Vivianki/LiCy/Documentos/relatorio/licy-apendices.tex

% ---
% Arquivo com os apêndices do Trabalho de Conclusão de Curso dos alunos
% Gabriel Takaoka Nishimura, Felippe Demarqui Ramos e Vivian Kimie Isuyama 
% da Escola Politécnica da Universidade de São Paulo
% ---
\chapter{Diagramas da Arquitetura}

\begin{figure}[h]
	\caption{\label{fig_sindrome_arq}Arquitetura do módulo de cálculo das síndromes.}
	\centering
	
	\legend{Fonte: Autores.}
\end{figure}

\begin{figure}[h]
	\caption{\label{fig_berlekamp_arq}Arquitetura do módulo de Berlekamp-Massey.}
	\centering
	
	\legend{Fonte: Autores.}
\end{figure}

\begin{figure}[h]
	\caption{\label{fig_chienloc_arq}Arquitetura do módulo de busca de Chien: localização de erros.}
	\centering
	
	\legend{Fonte: Autores.}
\end{figure}

\begin{figure}[h]
	\caption{\label{fig_chienval_arq}Arquitetura do módulo de busca de Chien: valores de erros.}
	\centering
		
	\legend{Fonte: Autores.}
\end{figure}

\begin{figure}[h]
	\caption{\label{figure:interleaver-rtl}Arquitetura do módulo de \textit{Interleaver}.}
	\centering
	
	\legend{Fonte: Autores.}
\end{figure}
\begin{figure}[h]
	\caption{\label{figure:sync-rtl}Arquitetura do módulo de Sincronização.}
	\centering
	
	\legend{Fonte: Autores.}
\end{figure}
\begin{figure}[h]
	\caption{\label{figure:manchester-decoder-rtl}Arquitetura do módulo de Decodificação Manchester.}
	\centering
	
	\legend{Fonte: Autores.}
\end{figure}

\begin{figure}[h]
	\caption{\label{figure:viterbi-rtl}Arquitetura do módulo de Decodificação Viterbi.}
	\centering
	
	\legend{Fonte: Autores.}
\end{figure}
