Vivianki/LiCy/Documentos/relatorio/ficha-catalografica.tex

\begin{fichacatalografica}
	\sffamily
	\vspace*{\fill}					% Posição vertical
	\begin{center}					% Minipage Centralizado
		\fbox{\begin{minipage}[c][8cm]{13.5cm}		% Largura
			\small
			\imprimirautor
			%Sobrenome, Nome do autor
				
			\hspace{0.5cm} \imprimirtitulo  / \imprimirautor. --
			\imprimirlocal, \imprimirdata-
			
			\hspace{0.5cm} \pageref{LastPage} p. : il. (algumas color.) ; 30 cm.\\
			
			\hspace{0.5cm} \imprimirorientadorRotulo~\imprimirorientador\\
			
			\hspace{0.5cm}
			\parbox[t]{\textwidth}{\imprimirtipotrabalho~--~\imprimirinstituicao,
				\imprimirdata.}\\
			
			\hspace{0.5cm}
			1. Engenharia
			2. Engenharia de computação
			3. Ensino e aprendizagem
			I. Universidade de São Paulo. Escola Politécnica. Departamento de Computação 	
		\end{minipage}}
	\end{center}
\end{fichacatalografica}
