Vivianki/LiCy/Documentos/relatorio/Arquitetura.pdf

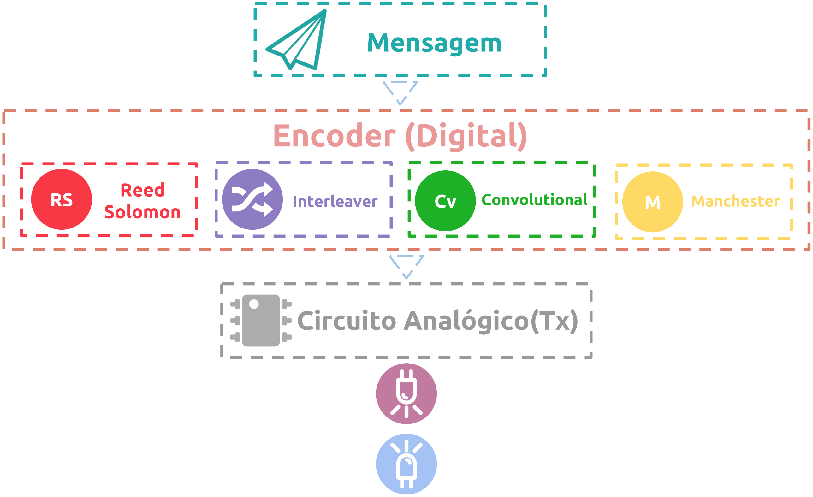
[picture p23: figure]
Convolutional Reed; Solomon RS; Interleaver; Mensagem; Manchester; Encoder (Digital); Circuito Analógico(Tx)

## Circuito Analógico(Rx)

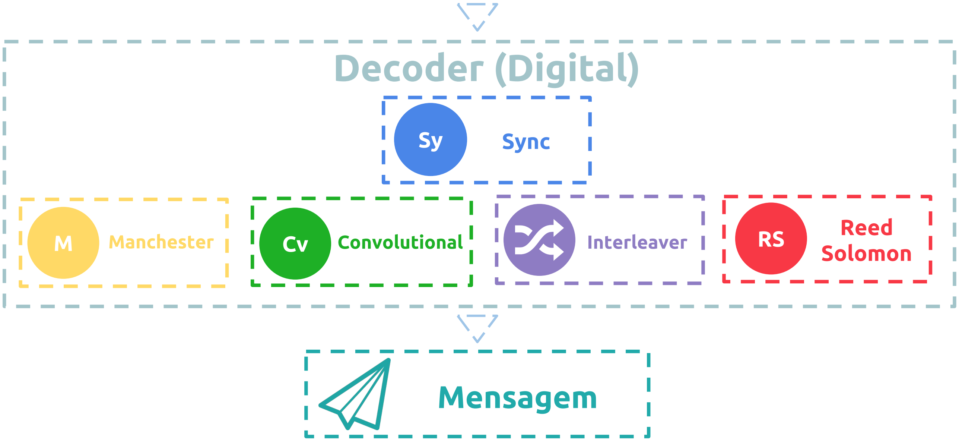
[picture p24: figure]
Convolutional; Reed; Solomon M; Manchester; Interleaver; Decoder (Digital); Mensagem; Sync
