Vivianki/LiCy/Documentos/relatorio/circuits/receiver_lify_final.pdf

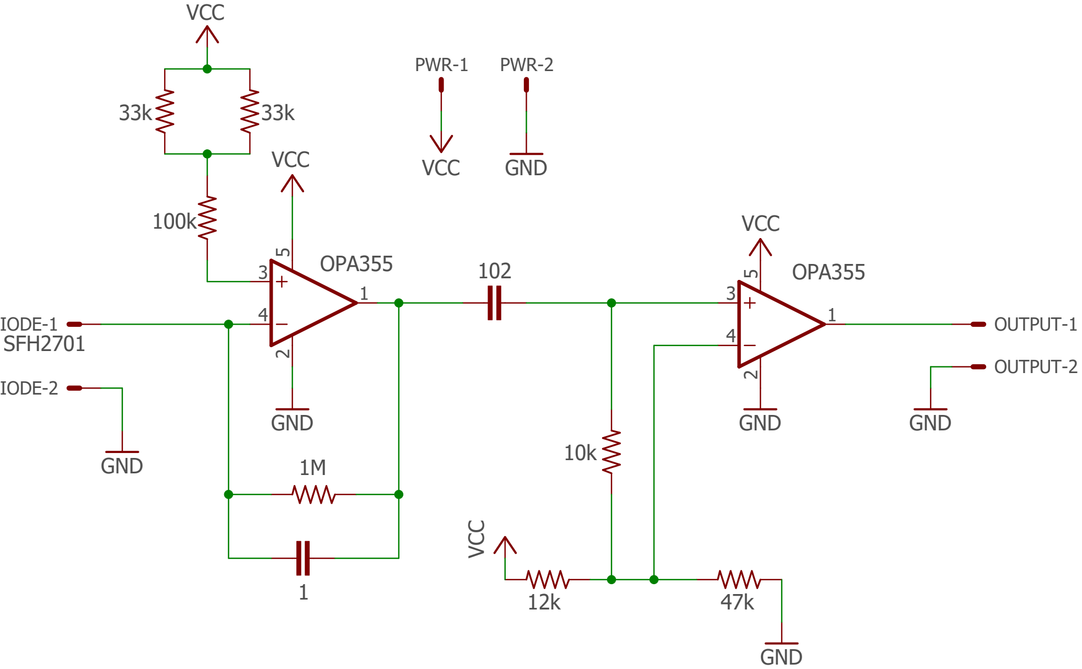
[picture p25: figure]
OPA355; GND; VCC; SFH2701; OUTPUT-1; OUTPUT-2; PWR-1; PWR-2

PHOTODIODE-1

PHOTODIODE-2
