Vivianki/LiCy/Documentos/relatorio/circuits/transmitter_fail1.pdf

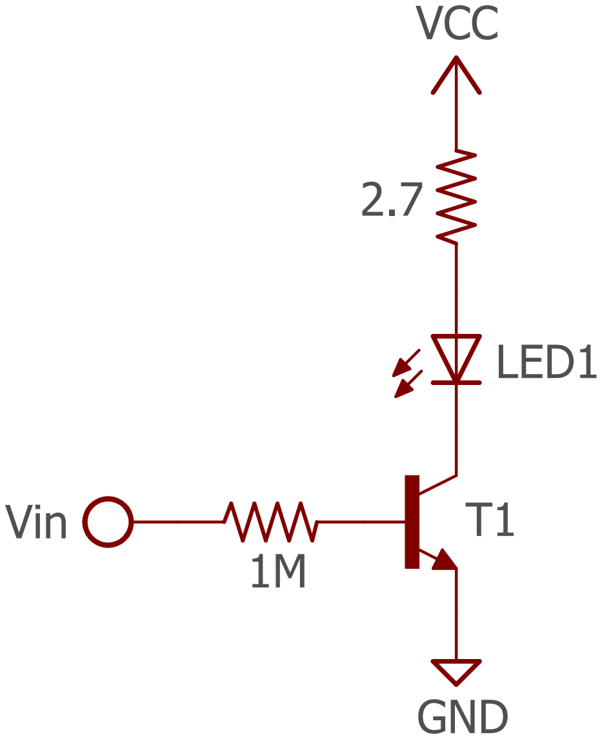
[picture p26: figure]
Vin; VCC; GND; LED1
