Vivianki/LiCy/Documentos/relatorio/circuits/transmitter_fail0.pdf

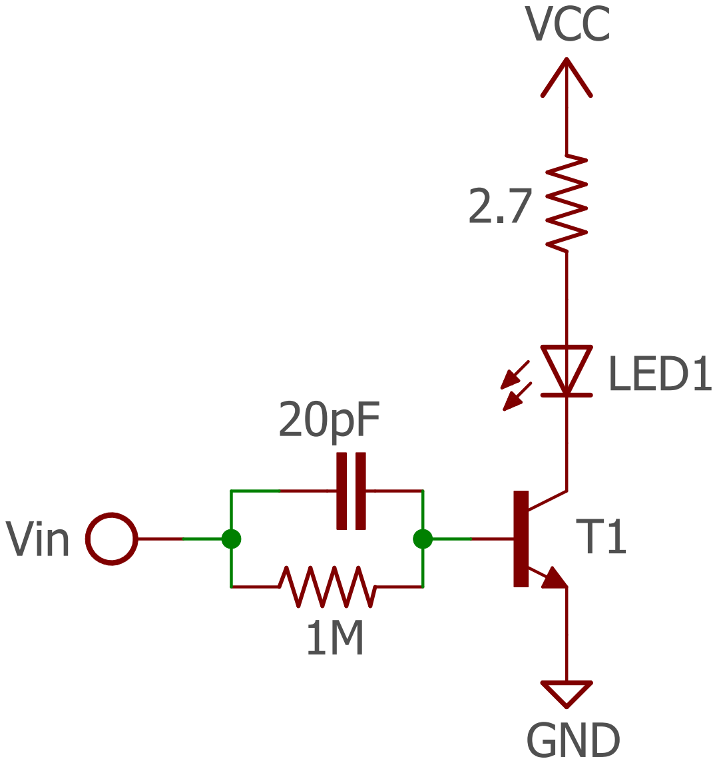
[picture p27: figure]
Vin; VCC; GND; LED1
