Vivianki/LiCy/Documentos/relatorio/circuits/transmitter_lify.pdf

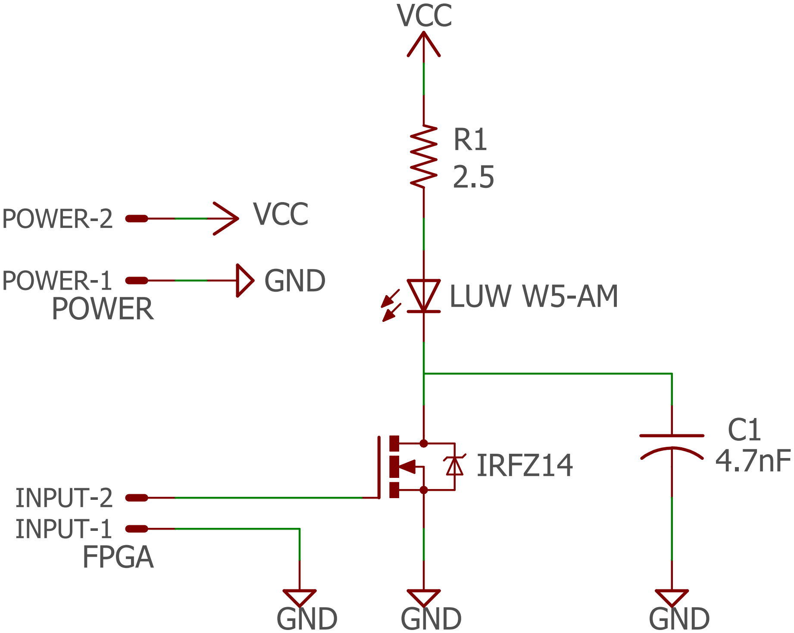
[picture p28: figure]
IRFZ14; GND; VCC; LUW W5-AM; FPGA; POWER; INPUT-1; INPUT-2; POWER-1; POWER-2
