Vivianki/LiCy/Documentos/relatorio/circuits/led_circuit.pdf

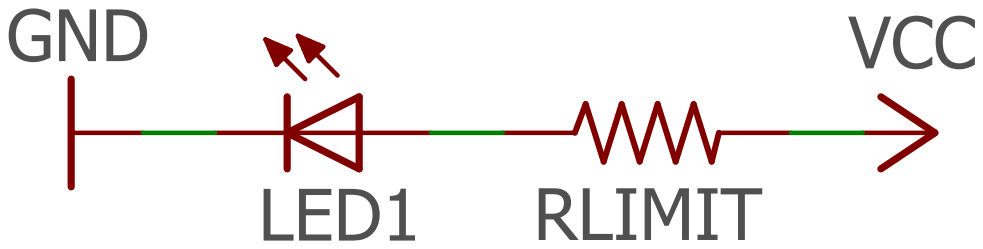
[picture p30: figure]
GND; VCC; LED1; RLIMIT
