Vivianki/LiCy/Documentos/relatorio/circuits/highpass_filter.pdf

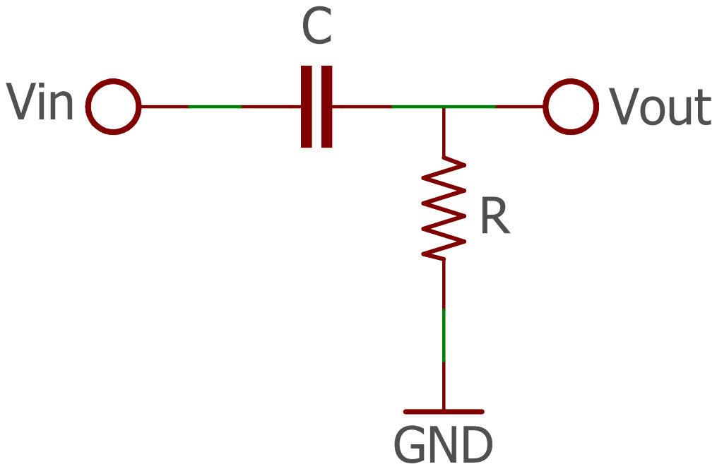
[picture p31: figure]
Vin; Vout; GND
