Vivianki/LiCy/Documentos/relatorio/circuits/lowpass-filter.pdf

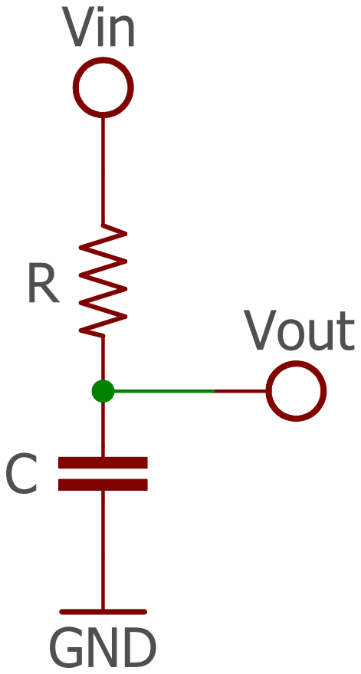
[picture p32: figure]
Vin; Vout; GND
