Vivianki/LiCy/Documentos/relatorio/circuits/mosfet_example.pdf

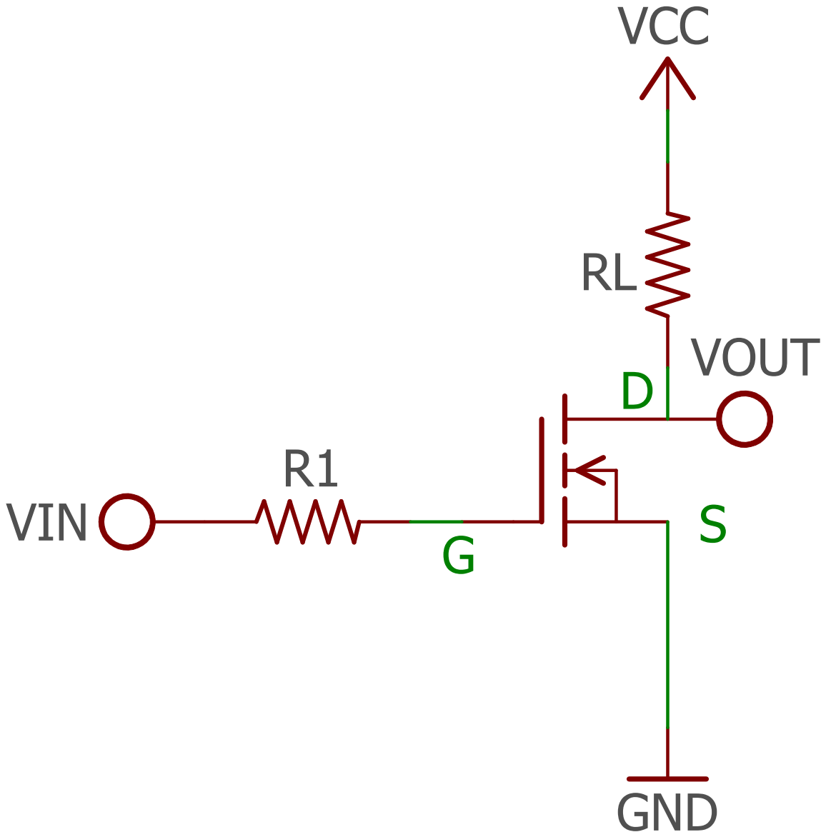
[picture p33: figure]
VCC; GND; VIN; VOUT
