Vivianki/LiCy/Documentos/relatorio/circuits/transimpedance_amp_simple.pdf

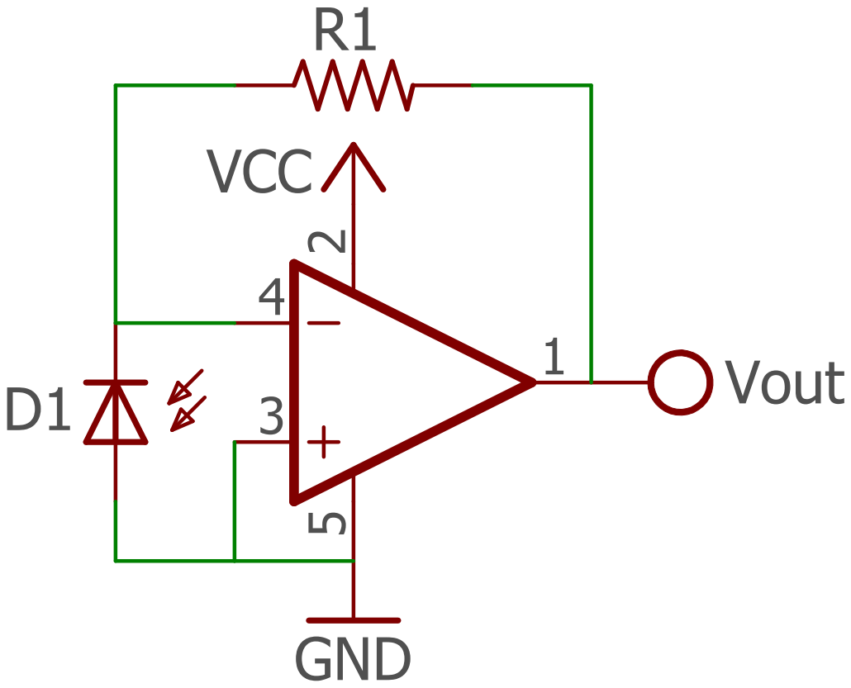
[picture p34: figure]
VCC; Vout; GND
