Vivianki/LiCy/Documentos/relatorio/licy.tex

% ------------------------------------------------------------------------
% ------------------------------------------------------------------------
% LiCy - Trabalho de Conclusão de Curso da Escola Politécnica da USP
% Integrantes: Gabriel Takaoka Nishimura, Felippe Demarqui Ramos e Vivian Kimie Isuyama.
% ------------------------------------------------------------------------
% ------------------------------------------------------------------------

\documentclass[
	12pt,				% tamanho da fonte
	openright,			% capítulos começam em pág ímpar
	oneside,			% para impressão em recto e verso. Oposto a oneside
	a4paper,			% tamanho do papel.
	hyphens,			% url longa nas referencias
	english,			% idioma adicional para hifenização
	brazil				% o último idioma é o principal do documento
]{abntex2}

% ---
%  PACOTES
% ---

% Pacotes básicos
\usepackage{lmodern}			% Usa a fonte Latin Modern
\usepackage[T1]{fontenc}		% Selecao de codigos de fonte.
\usepackage[utf8]{inputenc}		% Conversão automática dos acentos
\usepackage{lastpage}			% Usado pela Ficha catalográfica
\usepackage{indentfirst}		% Indenta o primeiro parágrafo de cada seção.
\usepackage{color}				% Controle das cores
\usepackage{amssymb}			% Less than or equal to
\usepackage{tikz}				% desenhos de graficos aux
\usepackage{pgfplots}			% desenhos de gráficos
\usepackage{graphicx}			% Inclusão de gráficos
\usepackage{subcaption}			% Subfigure
\usepackage{float}				% Gráficos
\usepackage{gensymb}			% degree
\usepackage{microtype} 			% para melhorias de justificação
\usepackage{lipsum}				% para geração de dummy text
\usepackage{listings}			% para listagem de código %
\usepackage{amsmath}			% para construção de sistemas lineares%

% Pacotes de citações
\usepackage[brazilian,hyperpageref]{backref}	 % Paginas com as citações
\usepackage[alf,abnt-url-package=url]{abntex2cite}	% Citações padrão ABNT

% ---
% CONFIGURAÇÕES DE PACOTES
% ---

% ---
% Configurações do pacote
\newenvironment{spmatrix}[1]{
	\def\mysubscript{#1}\mathop\bgroup\begin{pmatrix}
	}
{\end{pmatrix}\egroup_{\textstyle\mathstrut\mysubscript}}
% ---

% ---
% Configurações do pacote PGFPLOT
\pgfplotsset{compat=1.14}
\usetikzlibrary{patterns}
\usepgfplotslibrary{fillbetween}

% ---
% Configurações do pacote float
\newfloat{chart}{tbhp}{loc} %section
\floatname{chart}{Gráfico}
\floatstyle{plaintop}
\restylefloat{chart}
\newcommand{\listofcharts}{\listof{chart}{Lista de Gráficos}}
% ---
% Configurações do pacote backref
\renewcommand{\backrefpagesname}{Citado na(s) página(s):~}
\renewcommand{\backref}{}
\renewcommand*{\backrefalt}[4]{
	\ifcase #1 %
	Nenhuma citação no texto.%
	\or
	Citado na página #2.%
	\else
	Citado #1 vezes nas páginas #2.%
	\fi}%
% ---

% ---
% Informações de dados para CAPA e FOLHA DE ROSTO
% ---
\titulo{\textit{Light Cyber}: Um estudo sobre a implementação de \textit{Light Fidelity} utilizando a norma IEEE 802.15.7}
\autor{Gabriel Takaoka Nishimura \\ Felippe Demarqui Ramos \\ Vivian Kimie Isuyama}
\local{São Paulo}
\data{2016}
\orientador{Prof. Dr. Bruno Carvalho de Albertini}
\instituicao{Universidade de São Paulo -  USP \par
			Escola Politécnica \par
			Engenharia Elétrica com ênfase em Computação}
\tipotrabalho{Trabalho de Conclusão de Curso}
\preambulo{Trabalho de Conclusão de Curso apresentado ao Departamento de Engenharia de Computação e Sistemas
	Digitais da Escola Politécnica da Universidade de São Paulo para obtenção do título de Bacharel de Engenharia}
% ---

% ---
% Configurações de aparência do PDF final
\definecolor{blue}{RGB}{41,5,195} % cor azul

% informações do PDF
\makeatletter
\hypersetup{
	%pagebackref=true,
	pdftitle={\@title},
	pdfauthor={\@author},
	pdfsubject={\imprimirpreambulo},
	pdfcreator={LaTeX with abnTeX2},
	pdfkeywords={abnt}{latex}{abntex}{abntex2}{trabalho acadêmico},
	colorlinks=true,       		% false: boxed links; true: colored links
	linkcolor=blue,          	% color of internal links
	citecolor=blue,        		% color of links to bibliography
	filecolor=magenta,      		% color of file links
	urlcolor=blue,
	bookmarksdepth=4
}
\makeatother
% ---

% ---
% Espaçamentos entre linhas e parágrafos
% ---
\setlength{\parindent}{1.3cm} % O tamanho do parágrafo
\setlength{\parskip}{0.2cm}  % espacamento entre um paragrafo e outro

% ---
% compila o indice
% ---
\makeindex
% ---

% ----
% Início do documento
% ----
\begin{document}

	% Seleciona o idioma do documento
	\selectlanguage{brazil}

	% Retira espaço extra obsoleto entre as frases.
	\frenchspacing

	% ----------------------------------------------------------
	% ELEMENTOS PRÉ-TEXTUAIS
	% ----------------------------------------------------------
	% \pretextual

	% ---
	% Capa
	% ---
	\imprimircapa
	% ---

	% ---
	% Folha de rosto
	% ---
	%\imprimirfolhaderosto*
	
	\begin{center}
		%fix do nome zuadinho
		{\ABNTEXchapterfont\large\ Gabriel Takaoka Nishimura \\ Felippe Demarqui Ramos \\ \vspace*{0.18cm} Vivian Kimie Isuyama}
		
		\vspace*{\fill}\vspace*{\fill}
%		\vspace*{-0.2cm}
		\begin{center}
			\ABNTEXchapterfont\bfseries\Large\imprimirtitulo
		\end{center}
		\vspace*{\fill}
		
		{%
			\hspace{.45\textwidth}
			\begin{minipage}{.5\textwidth}
				\SingleSpacing
				\imprimirpreambulo
			\end{minipage}%
			\vspace*{\fill}
		}%
		
		{\imprimirinstituicao\vspace*{\fill}}
		
		{\large\imprimirorientadorRotulo~\imprimirorientador\par}

		\vspace*{\fill}
		
		{\large\imprimirlocal}
		\par
		{\large\imprimirdata}
		\vspace*{1cm}
		
	\end{center}
	% ---

	% ---
	% Ficha Catalográfica
	% Quando receber pdf da biblioteca, descomentar linhas abaixo
	% ---
	%\include{ficha-catalografica}
	% ---

	% \begin{fichacatalografica}
	%     \includepdf{fig_ficha_catalografica.pdf}
	% \end{fichacatalografica}

	% ---
	% TODO APROVACAO
	% Quando receber pdf com assinaturas, descomentar linha abaixo
	% ---
	% \includepdf{folhadeaprovacao_final.pdf}
	%

	% ---
	% Agradecimentos
	% ---
	\begin{agradecimentos}
		À instituição de ensino e todos os seus docentes por fornecerem uma aventura de graduação inesquecível aos integrantes do grupo.

		Ao nosso orientador, Bruno de Carvalho Albertini, por todo o apoio e paciência com o grupo. Seu otimismo e bom humor sempre foram grande fonte de motivação.

		Aos docentes e técnicos do Departamento de Sistemas Eletrônicos pelas aulas extracurriculares de eletrônica.

		À Carolina Ribeiro Minchin e Caique Bernardes Queiroz Magalhães por suas exímias revisões. A gentileza foi imensurável.

		Às nossas famílias pelo amor, incentivo e apoio incondicional.

		Por fim aos nossos amigos, que acreditaram no nosso potencial.
	\end{agradecimentos}
	% ---

	% ---
	% Epígrafe
	% ---
	\begin{epigrafe}
		\vspace*{\fill}
		\begin{flushright}
			\textit{``In a dark place we find ourselves,\\
				and a little more knowledge	lights our way.\\
				(Yoda, Episode 3: Revenge of the Sith)}
		\end{flushright}
	\end{epigrafe}
	% ---

	% ---
	% RESUMOS
	% ---
	\include{licy-resumos}
	% ---

	% ---
	% inserir lista de ilustrações
	% ---
	\pdfbookmark[0]{\listfigurename}{lof}
	\listoffigures*
	\cleardoublepage
	% ---

	% ---
	% inserir lista de gráficos
	% ---
	\pdfbookmark[0]{\listtablename}{lot}
	\listofcharts
	\cleardoublepage
	% ---

	% ---
	% inserir lista de tabelas
	% ---
	\pdfbookmark[0]{\listtablename}{lot}
	\listoftables*
	\cleardoublepage
	% ---

	% ---
	% inserir lista de abreviaturas e siglas
	% ---
	\begin{siglas}
		\item[AC] Corrente Alternada (do inglês \emph{Alternating Current})
		\item[ACS] Adicionar, Comparar e Selecionar (do inglês \emph{Add, Compare and Select})
		\item[ADC] Conversor Digital Analógico (do inglês \emph{Analog Digital Converter})
		\item[BM] Métrica de Ramificação (do inglês \emph{Branch Metrics})
		\item[BER] Taxa de Erro de \textit{bit} (do inglês \emph{Bit Error Rate})
		\item[CAP] \emph{Carrier-less amplitude and phase}
		\item[DC] Corrente Contínua (do inglês \emph{Direct Current})
		\item[DMT] Multi-Tom Discreto (do inglês \emph{Discrete Multi-Tone})
		\item[EAP] Estrutura Analítica de Projeto
		\item[FET] Transistor de Efeito de Campo (do inglês \emph{Field Effect Transistor})
		\item[FLP] Padrão de Rápido Travamento (do inglês \emph{Fast Locking Pattern})
		\item[FPGA] Arranjo de Portas Programável (do inglês \emph{Field Programable Gate Array})
		\item[GF] Campos de Galois (do inglês \emph{Galois Field})
		\item[GND] Terra (do inglês \emph{Ground})
		\item[GPIO] Pinos de Entrada e Saída de Propósito Geral (do inglês \emph{General Purpose Input/Output})
		\item[HDL] Linguagem de Descrição de Hardware (do inglês \emph{Hardware Description Language})
		\item[IEEE] Instituto dos Engenheiros Elétricos e Eletrônicos (do inglês \emph{Institute of Electrical and Electronics Engineers})
		\item[IP] Propriedade Intelectual (do inglês \emph{Intellectual Property})
		\item[ISI] Interferência Inter-Símbolo (do inglês \emph{Inter-symbol Interference})
		\item[LED] Diodo Emissor de Luz (do inglês \emph{Light Emitting Diode})
		\item[LUT] Tabela de Pesquisa (do inglês \emph{Look Up Table})
		\item[MAC] Controle de Acesso de Mídia (do inglês \emph{Media Access Control})
		\item[M-CMMA] \emph{Modified Cascaded Multi-Modulus Algorithm}
		\item[MCS] Esquema de Modulação e Codificação (do inglês \emph{Modulation and Coding Scheme})
		\item[MOSFET] \emph{Metal Oxide Semiconductor Field Effect Transistor}
		\item[OFDM] Multiplexação de Divisão de Frequência Ortogonal (do inglês \emph{Orthgonal Frequency Divided Multiplexing})
		\item[OOK] Chaveamento Alto-Baixo (do inglês \emph{On-Off Keying})
		\item[PHR] Cabeçalho do PHY (do inglês PHY \emph{Header})
		\item[PISO] Entrada Paralela para Saída Serial (do inglês \emph{Parallel Input to Serial Output})
		\item[PM] Métrica de Caminho (do inglês \emph{Path Metrics})
		\item[PPDU] Unidade de Dados da Camada Física (do inglês \emph{Physical Layer Data Unit})
		\item[PSDU] Unidade de Serviço de dados PHY I (do inglês \emph{PHY Service Data Unit})
		\item[QAM] Modulação de amplitude em quadratura (do inglês \emph{Quadrature Amplitude Modulation})
		\item[RLL] Comprimento de Execução Limitado (do inglês \emph{Run Length Limited})
		\item[RLS] \emph{Recursive Least Square}
		\item[RGB] Vermelho Verde e Azul (do inglês \emph{Red Green and Blue})
		\item[RS] Reed Solomon
		\item[RTL] Nível de Transferência de Registradores (do inglês \emph{Register Transfer Level})
		\item[SHR] Cabeçalho de Sincronização (do inglês \emph{Synchronization Header})
		\item[SIPO] Entrada Serial para Saída Paralela (do inglês \emph{Serial Input to Parallel Output})
		\item[TDP] Padrão Dependente de Topologia (do inglês \emph{Topology Dependant Pattern})
		\item[TTL] Lógica de Transistor-Transistor (do inglês \emph{Transistor-Transistor Logic)}
		\item[UART] Receptor/Transmissor Asíncrono Universal (do inglês \emph{Universal Asynchronous Receiver/Transmitter})
		\item[UC] Unidade de Controle
		\item[USB] Barramento Serial Universal (do inglês \emph{Universal Serial Bus})
		\item[VCC] Voltagem no Coletor Comum
		\item[VHDL] Linguagem Verilog de Descrição de Hardware (do inglês \emph{Verilog Hardware Description Language})
		\item[VPAN] \emph{Visible-Light Communication Personal Area Network}
		\item[WDM] Multiplexação por Divisão de Frequência (do inglês \emph{Wavelength Division Multiplexing)}
	\end{siglas}
	% ---

	% ---
	% inserir o sumario
	% ---
	\pdfbookmark[0]{\contentsname}{toc}
	\tableofcontents*
	\cleardoublepage
	% ---

	% ----------------------------------------------------------
	% ELEMENTOS TEXTUAIS
	% ----------------------------------------------------------
	\textual

	% ----------------------------------------------------------
	% Introdução
	% ----------------------------------------------------------
	\include{licy-introducao}
	% ----------------------------------------------------------
	
	% ----------------------------------------------------------
	% Revisões Bibliográficas
	% ----------------------------------------------------------
	\include{licy-revisao-bibliografica}
	% ----------------------------------------------------------

	% ----------------------------------------------------------
	% Metodologia
	% ----------------------------------------------------------
	\include{licy-metodologia}
	% ----------------------------------------------------------

	% ----------------------------------------------------------
	% Execução
	% ----------------------------------------------------------
	\include{licy-execucao}
	% ----------------------------------------------------------

	% ----------------------------------------------------------
	% Prepara pdf para iniciar o bookmark na raiz
	% ----------------------------------------------------------
	\phantompart

	% ----------------------------------------------------------
	% Conclusão
	% ----------------------------------------------------------
	\include{licy-conclusao}
	% ----------------------------------------------------------

	% ----------------------------------------------------------
	% ELEMENTOS PÓS-TEXTUAIS
	% ----------------------------------------------------------
	\postextual
	% ----------------------------------------------------------

	% ----------------------------------------------------------
	% Referências bibliográficas
	% ----------------------------------------------------------
	\bibliography{referencias-licy}

	% ----------------------------------------------------------
	% Glossário
	% ----------------------------------------------------------
	%\glossary
	% ----------------------------------------------------------

	% ----------------------------------------------------------
	% Apêndices
	% ----------------------------------------------------------
	\begin{apendicesenv}
		\partapendices % pagina indicando inicio dos apendices
		\include{licy-apendices}
	\end{apendicesenv}
	% ----------------------------------------------------------

	% ----------------------------------------------------------
	% Anexos - SEM ANEXOS
	% ----------------------------------------------------------
	%\begin{anexosenv}
		%\partanexos	% Imprime uma página indicando o início dos anexos
		%\include{licy-anexos}
	%\end{anexosenv}
	% ----------------------------------------------------------

	%---------------------------------------------------------------------
	% INDICE REMISSIVO
	%---------------------------------------------------------------------
	\phantompart
	\printindex
	%---------------------------------------------------------------------

\end{document}
