Vivianki/LiCy/Documentos/relatorio/gantt.pdf

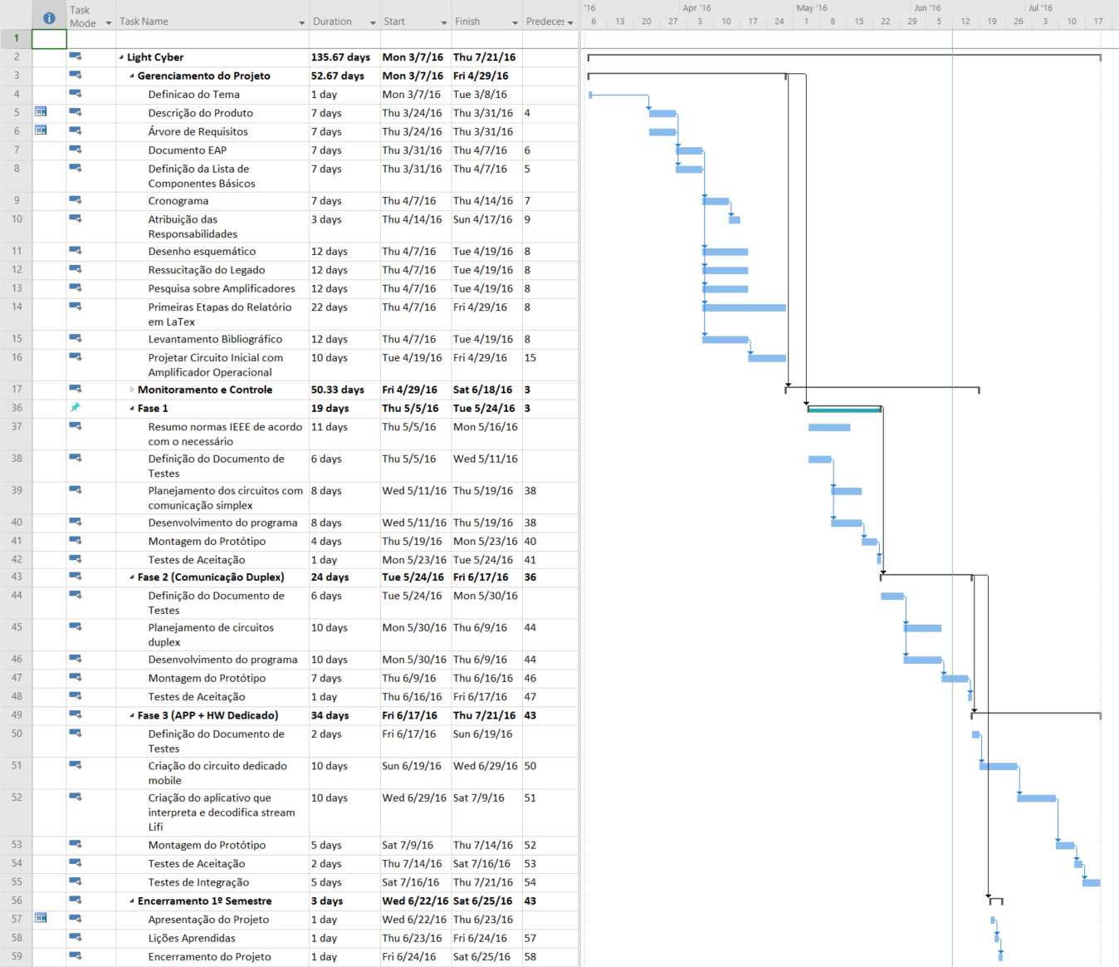
[picture p45: page 1]
