Vivianki/LiCy/Documentos/relatorio/interleaver/rtl.pdf

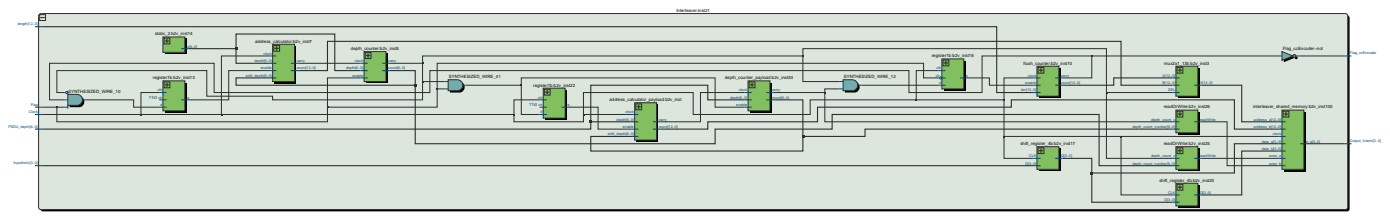
[picture p46: figure]
Interleaver:inst21; Clock Flag; InputIntrlv[3..0]; length[12..0]; PSDU_depth[6..0]; Flag_ccEncoder; Output_Interlv[3..0]; Flag_ccEncoder~not; SYNTHESIZED_WIRE_10; SYNTHESIZED_WIRE_41; SYNTHESIZED_WIRE_12; address_calculator:b2v_inst7; clock; enable; depth[6..0]; shift_depth[6..0]; carry; count[12..0]; address_calculator_payload:b2v_inst; depth_counter:b2v_inst5; count[6..0]; flush_counter:b2v_inst10; clock enable; len[12..0]; interleaver_shared_memory:b2v_inst100; wren_a wren_b; address_a[12..0] address_b[12..0]; data_a[3..0] data_b[3..0]; mux2x1_13b:b2v_inst3; SEL; readOrWrite:b2v_inst25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

count[6..0] | depth_counter_payload:b2v_inst30
shift_register_4b:b2v_inst17 CLK D[3..0] | Q[3..0]
shift_register_4b:b2v_inst20 CLK D[3..0] | Q[3..0]
