Vivianki/LiCy/Documentos/relatorio/viterbi/rtl.pdf

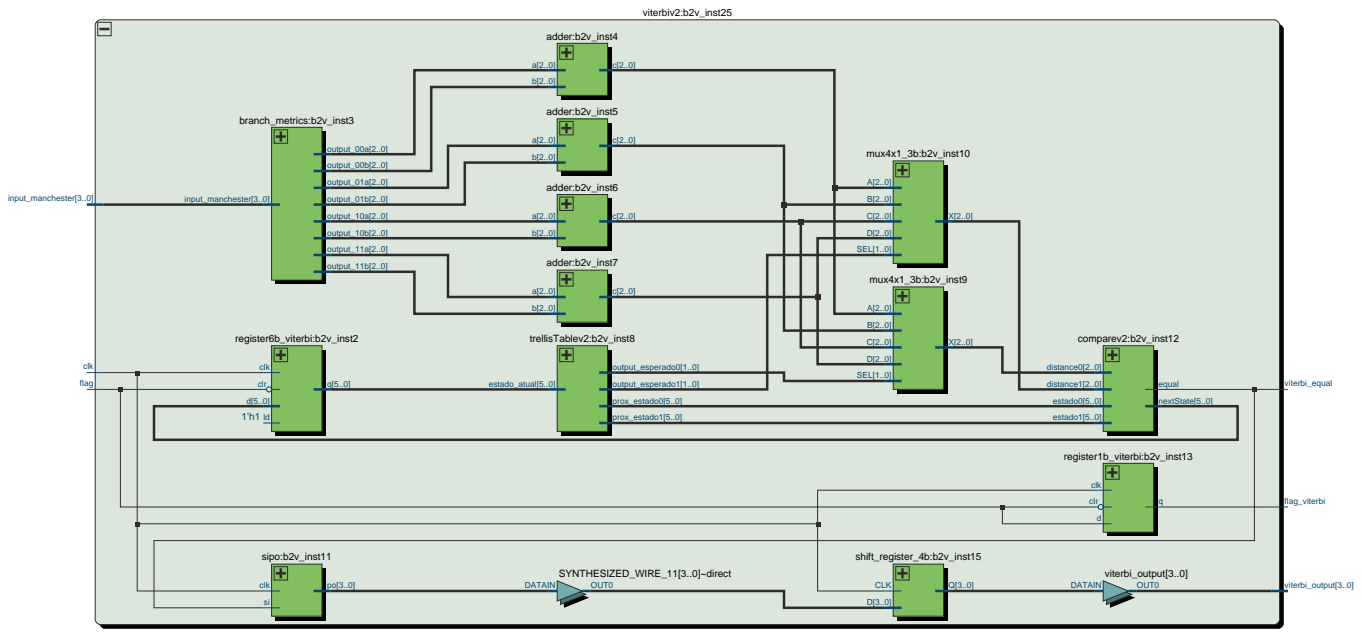
[picture p47: figure]
viterbiv2:b2v_inst25; clk; flag; input_manchester[3..0]; flag_viterbi; viterbi_equal; viterbi_output[3..0]; SYNTHESIZED_WIRE_11[3..0]~direct DATAIN; OUT0; adder:b2v_inst4; adder:b2v_inst5; adder:b2v_inst6; adder:b2v_inst7; branch_metrics:b2v_inst3; output_00a[2..0]; output_00b[2..0]; output_01a[2..0]; output_01b[2..0]; output_10a[2..0]; output_10b[2..0]; output_11a[2..0]; output_11b[2..0]; comparev2:b2v_inst12; estado0[5..0]; estado1[5..0]; distance0[2..0]; distance1[2..0]; equal; nextState[5..0]; mux4x1_3b:b2v_inst9; SEL[1..0]; mux4x1_3b:b2v_inst10; register1b_viterbi:b2v_inst13; clr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
