Vivianki/LiCy/Documentos/relatorio/RS/ChienLocationRTL.pdf

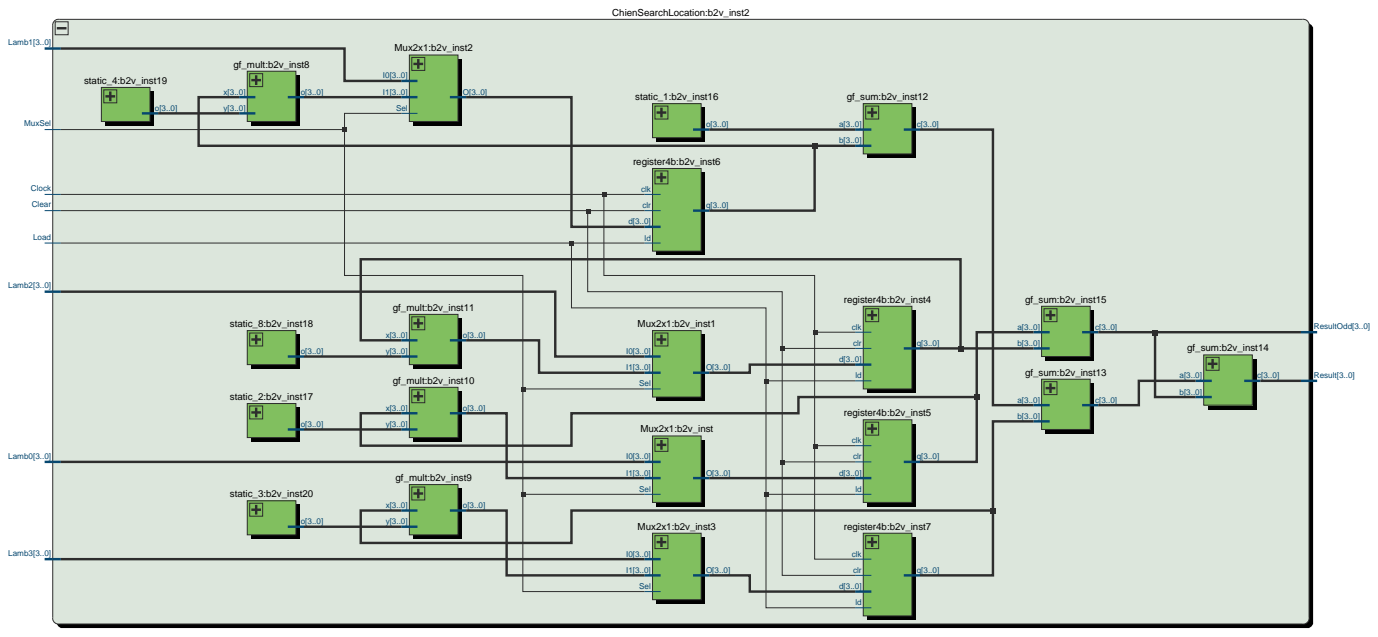
[picture p48: figure]
ChienSearchLocation:b2v_inst2; Clear; Clock; Load; MuxSel; Lamb0[3..0]; Lamb1[3..0]; Lamb2[3..0]; Lamb3[3..0]; Result[3..0]; ResultOdd[3..0]; Mux2x1:b2v_inst; Sel; Mux2x1:b2v_inst1; Mux2x1:b2v_inst2; Mux2x1:b2v_inst3; gf_mult:b2v_inst8; gf_mult:b2v_inst9; gf_mult:b2v_inst10; gf_mult:b2v_inst11; gf_sum:b2v_inst12; gf_sum:b2v_inst13; gf_sum:b2v_inst14; gf_sum:b2v_inst15; register4b:b2v_inst4; clk; clr; register4b:b2v_inst5; register4b:b2v_inst6; register4b:b2v_inst7; static_1:b2v_inst16; static_2:b2v_inst17; static_3:b2v_inst20; static_4:b2v_inst19; static_8:b2v_inst18
