Vivianki/LiCy/Documentos/relatorio/RS/ChienValueRTL.pdf

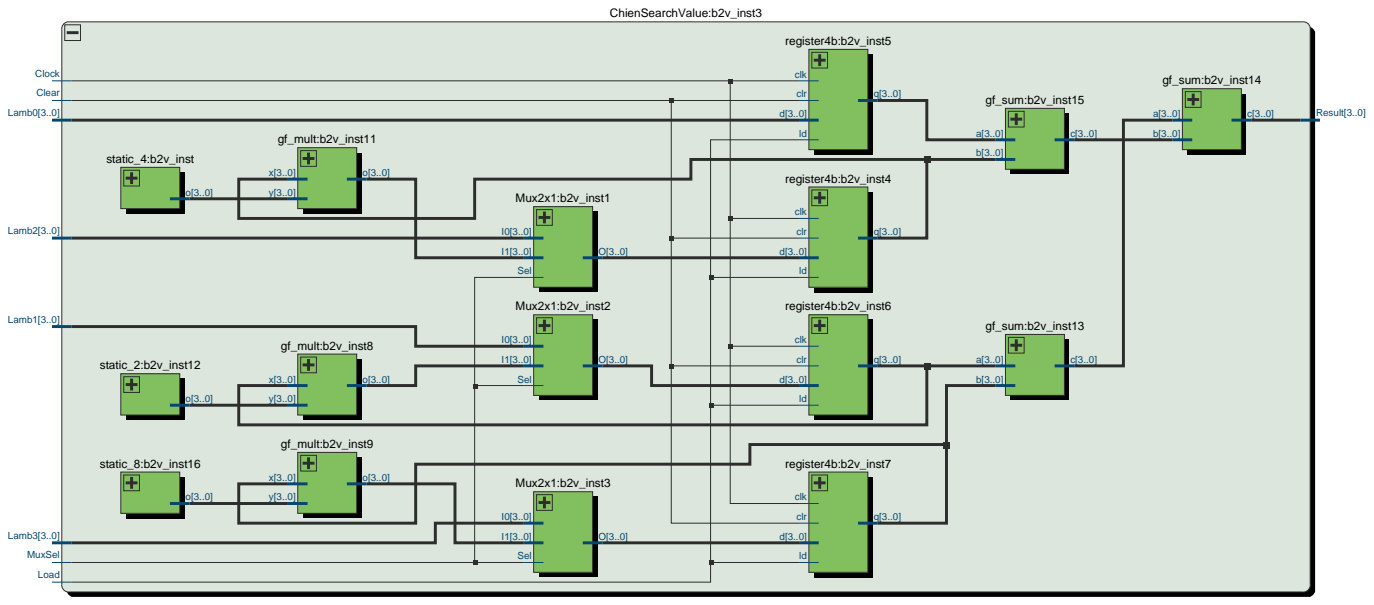
[picture p49: figure]
ChienSearchValue:b2v_inst3; Clear; Clock; Load; MuxSel; Lamb0[3..0]; Lamb1[3..0]; Lamb2[3..0]; Lamb3[3..0]; Result[3..0]; Mux2x1:b2v_inst1; Sel; Mux2x1:b2v_inst2; Mux2x1:b2v_inst3; gf_mult:b2v_inst8; gf_mult:b2v_inst9; gf_mult:b2v_inst11; gf_sum:b2v_inst13; gf_sum:b2v_inst14; gf_sum:b2v_inst15; register4b:b2v_inst4; clk; clr; register4b:b2v_inst5; register4b:b2v_inst6; register4b:b2v_inst7; static_2:b2v_inst12; static_4:b2v_inst; static_8:b2v_inst16
