Vivianki/LiCy/Documentos/relatorio/RS/ForneyRTL.pdf

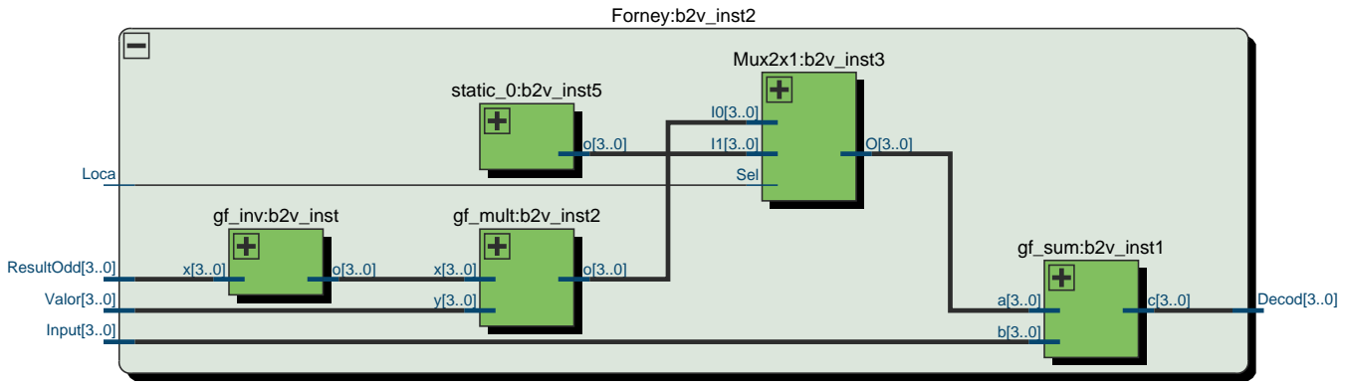
[picture p50: figure]
Forney:b2v_inst2; Loca; Input[3..0]; ResultOdd[3..0]; Valor[3..0]; Decod[3..0]; Mux2x1:b2v_inst3; Sel; gf_inv:b2v_inst; gf_mult:b2v_inst2; gf_sum:b2v_inst1; static_0:b2v_inst5
