Vivianki/LiCy/Documentos/relatorio/RS/SindromeRTL.pdf

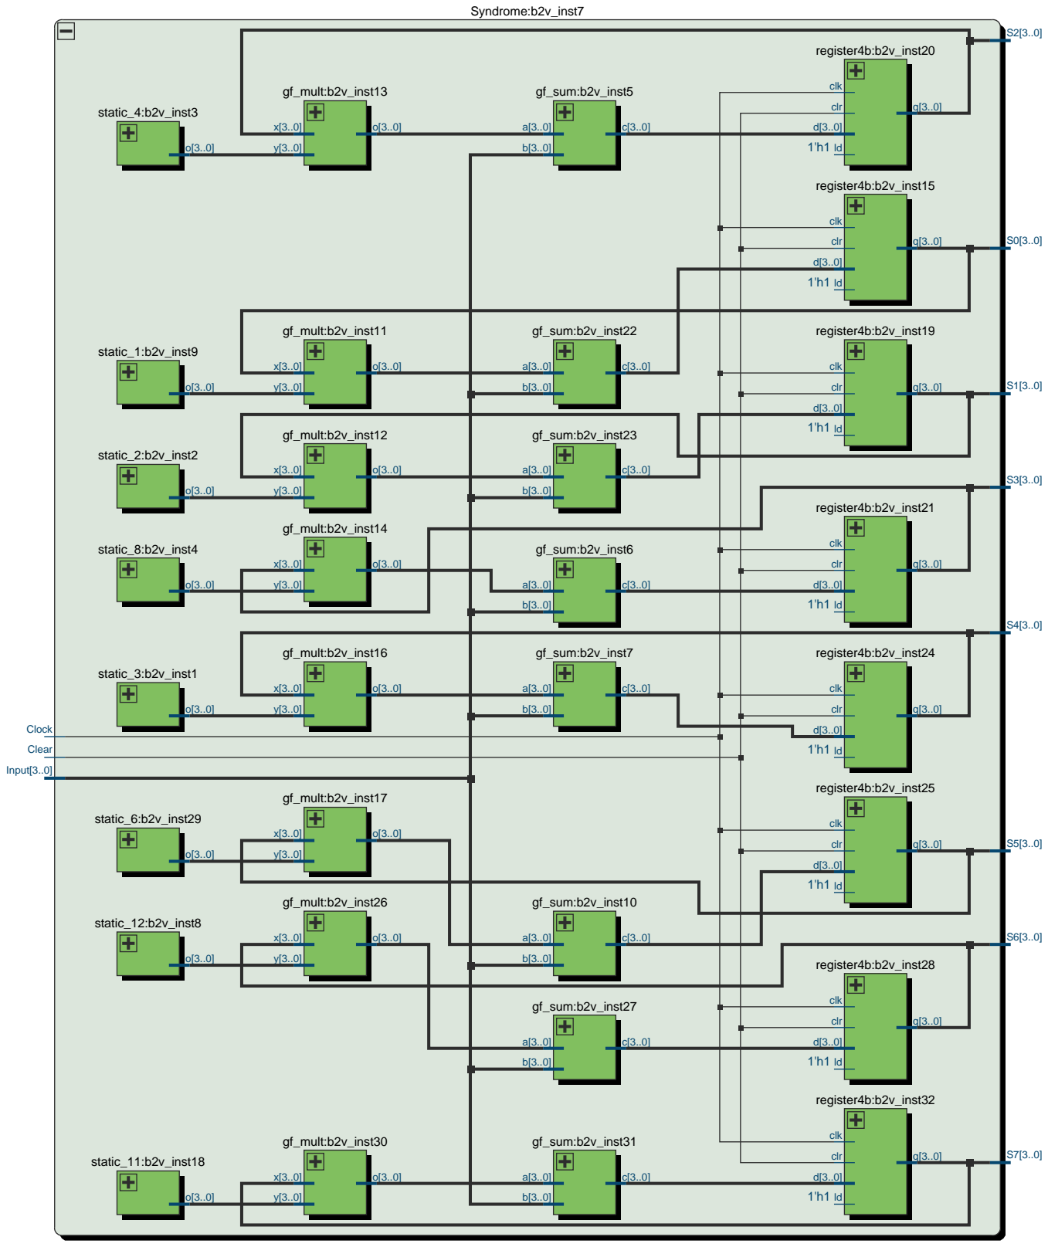
[picture p51: figure]
Syndrome:b2v_inst7; Clear; Clock; Input[3..0]; gf_mult:b2v_inst11; gf_mult:b2v_inst12; gf_mult:b2v_inst13; gf_mult:b2v_inst14; gf_mult:b2v_inst16; gf_mult:b2v_inst17; gf_mult:b2v_inst26; gf_mult:b2v_inst30; gf_sum:b2v_inst5; gf_sum:b2v_inst6; gf_sum:b2v_inst7; gf_sum:b2v_inst10; gf_sum:b2v_inst22; gf_sum:b2v_inst23; gf_sum:b2v_inst27; gf_sum:b2v_inst31; register4b:b2v_inst15; clk; clr; register4b:b2v_inst19; register4b:b2v_inst20; register4b:b2v_inst21; register4b:b2v_inst24; register4b:b2v_inst25; register4b:b2v_inst28; register4b:b2v_inst32; static_1:b2v_inst9; static_2:b2v_inst2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
