Vivianki/LiCy/Documentos/relatorio/circuits/highpass_filter_bias.pdf

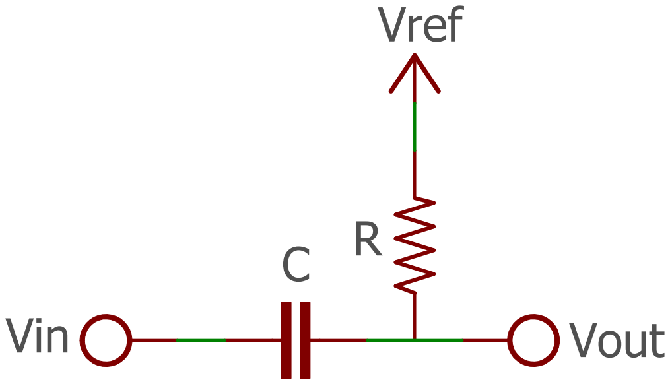
[picture p52: figure]
Vin; Vout; Vref
