Vivianki/LiCy/Documentos/relatorio/circuits/photos/RX TIA_photo.jpg

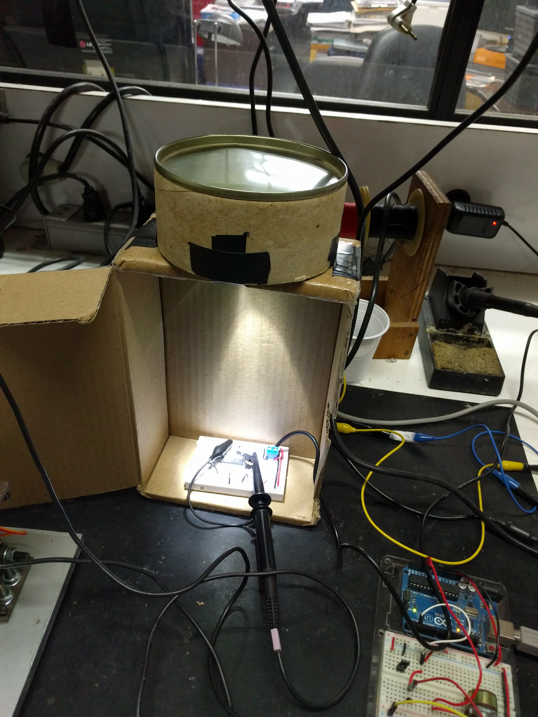
Documentos/relatorio/circuits/photos/RX TIA_photo.jpg
