Vivianki/LiCy/Documentos/relatorio/circuits/photos/RX_TIA_circuit.jpg

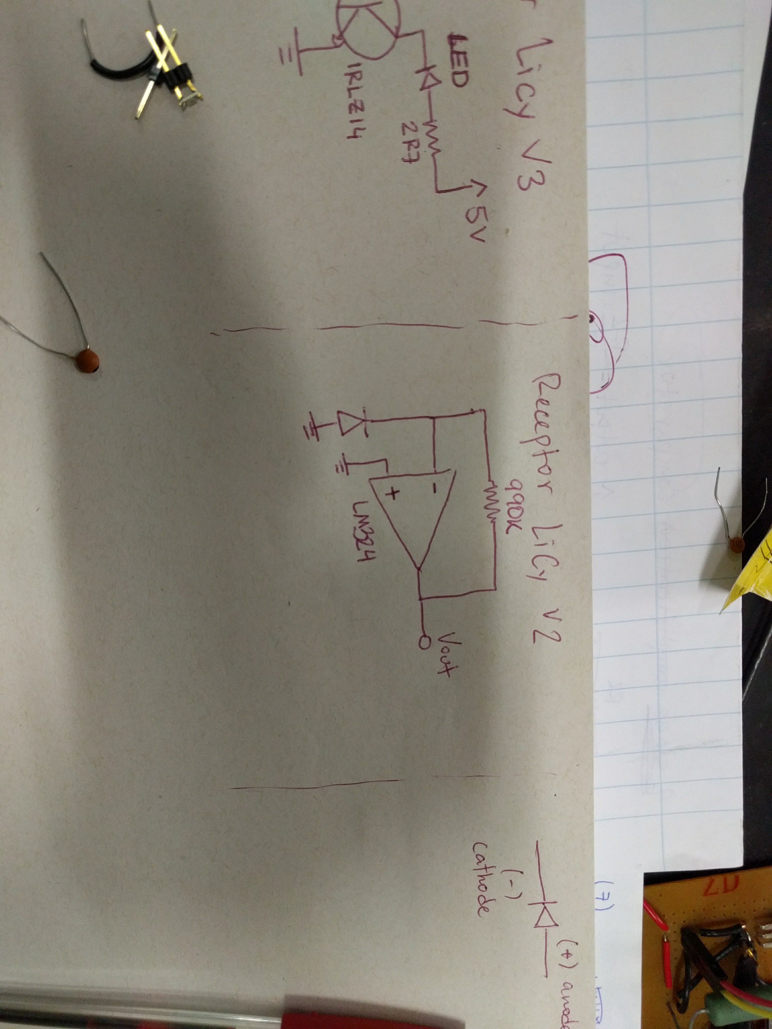
Documentos/relatorio/circuits/photos/RX_TIA_circuit.jpg
