Vivianki/LiCy/Documentos/relatorio/circuits/photos/TX_bd139_and DCbias.jpg

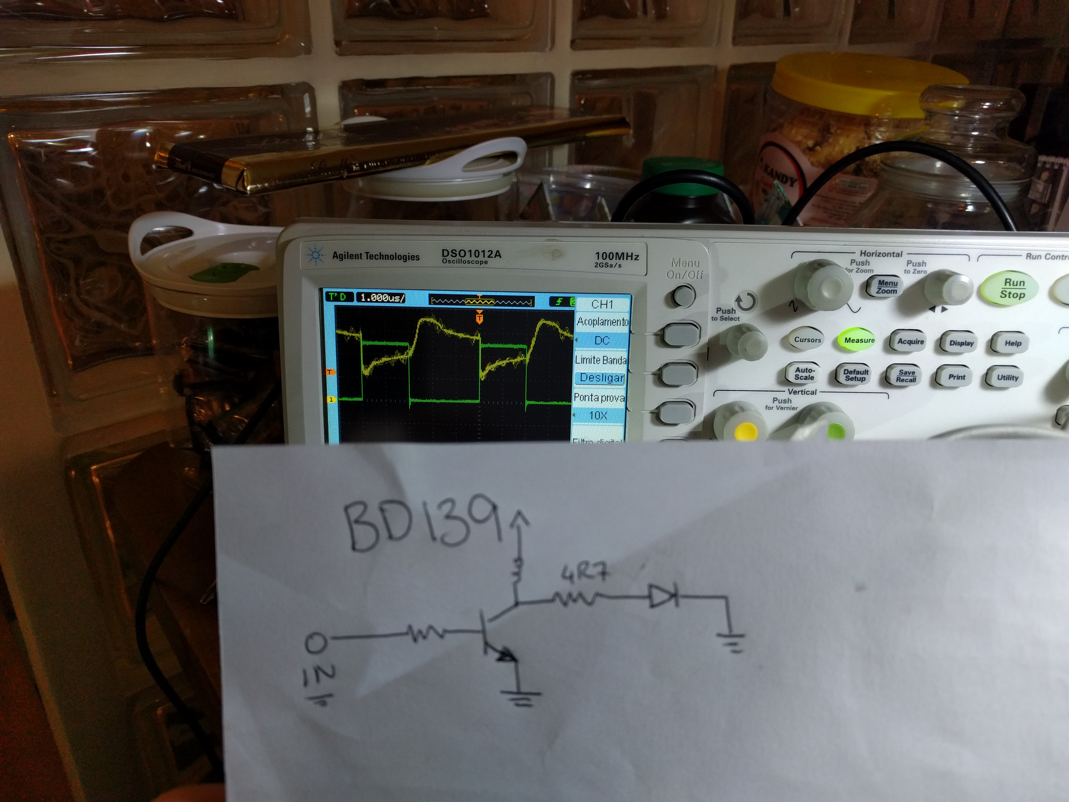
Documentos/relatorio/circuits/photos/TX_bd139_and DCbias.jpg
