Vivianki/LiCy/Documentos/relatorio/circuits/photos/TX_probe_circuit.jpg

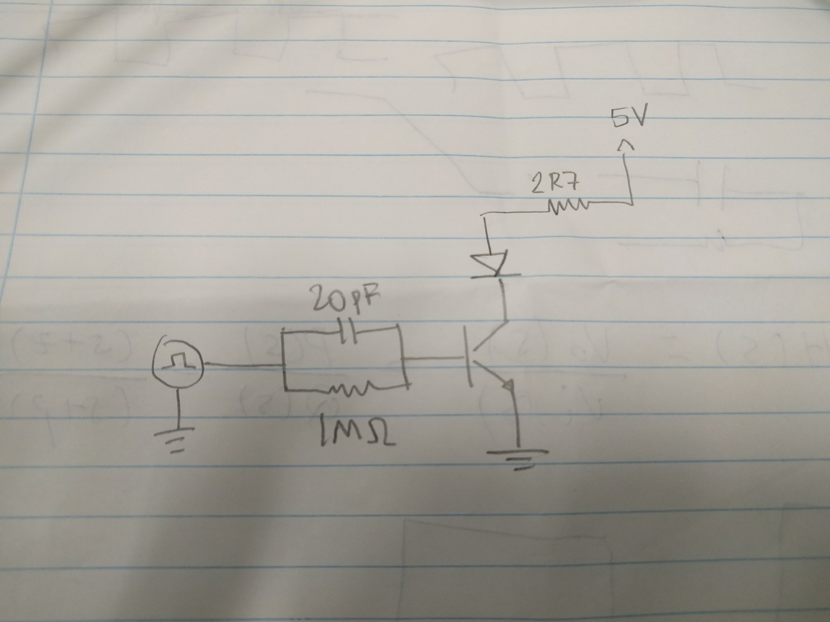
Documentos/relatorio/circuits/photos/TX_probe_circuit.jpg
