Vivianki/LiCy/Documentos/relatorio/RS/Sim_Lambda.PNG

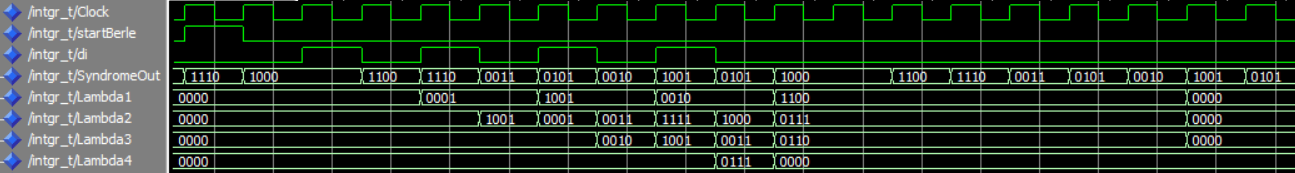
Documentos/relatorio/RS/Sim_Lambda.PNG
