Vivianki/LiCy/Documentos/relatorio/RS/Sindrome_bloco.jpg

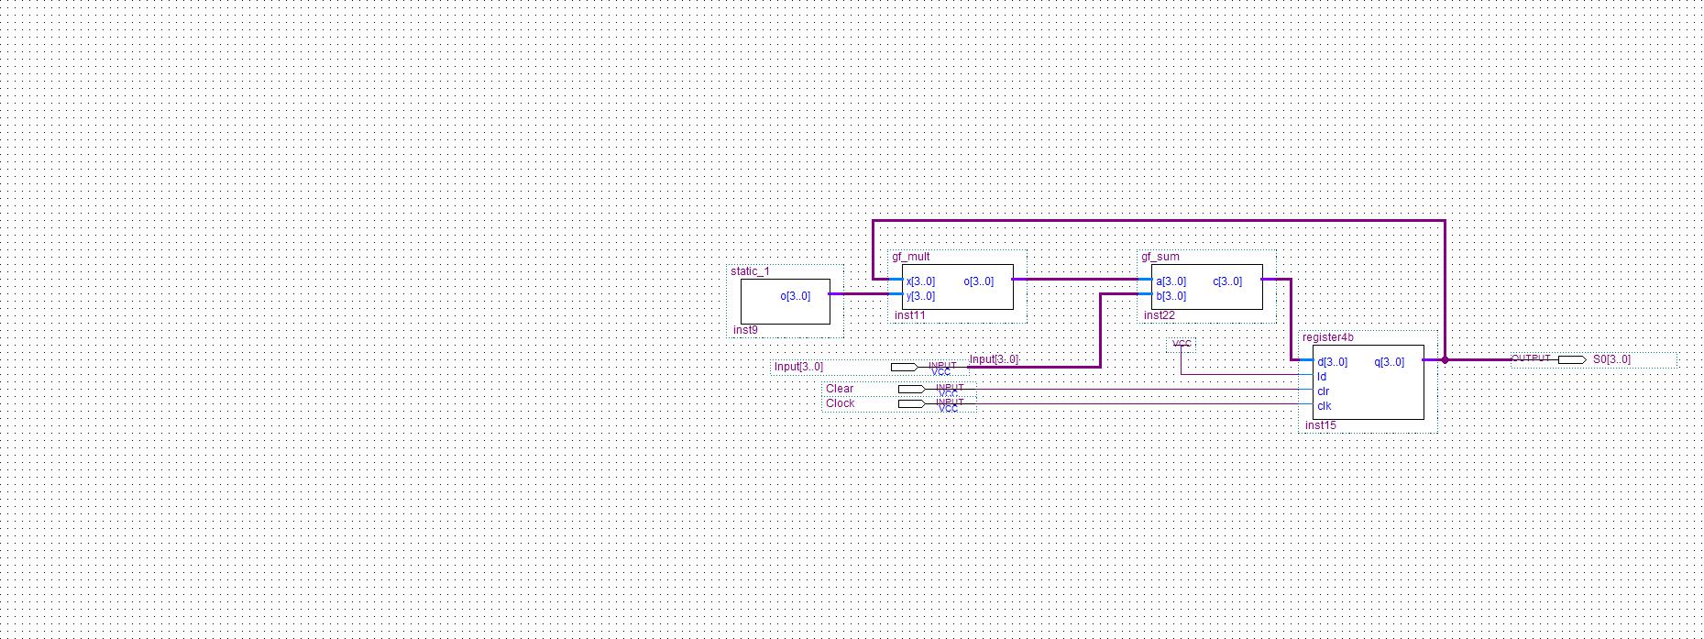
Documentos/relatorio/RS/Sindrome_bloco.jpg
