Vivianki/LiCy/Documentos/relatorio/RS/Sindrome_bloco.PNG

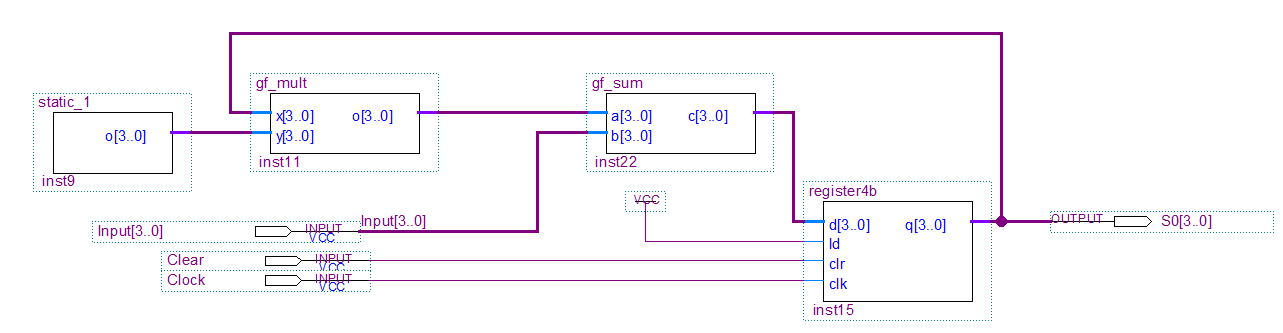
Documentos/relatorio/RS/Sindrome_bloco.PNG
