Vivianki/LiCy/JS Reed Solomon/thEPLUSGTR.jpg

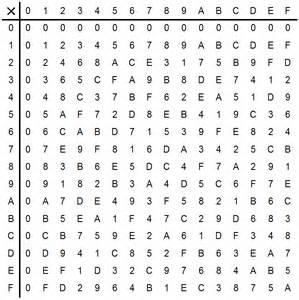
JS Reed Solomon/thEPLUSGTR.jpg
