Vivianki/LiCy/Reed Solomon decoder/simulation/modelsim/berlekamp_birl.png

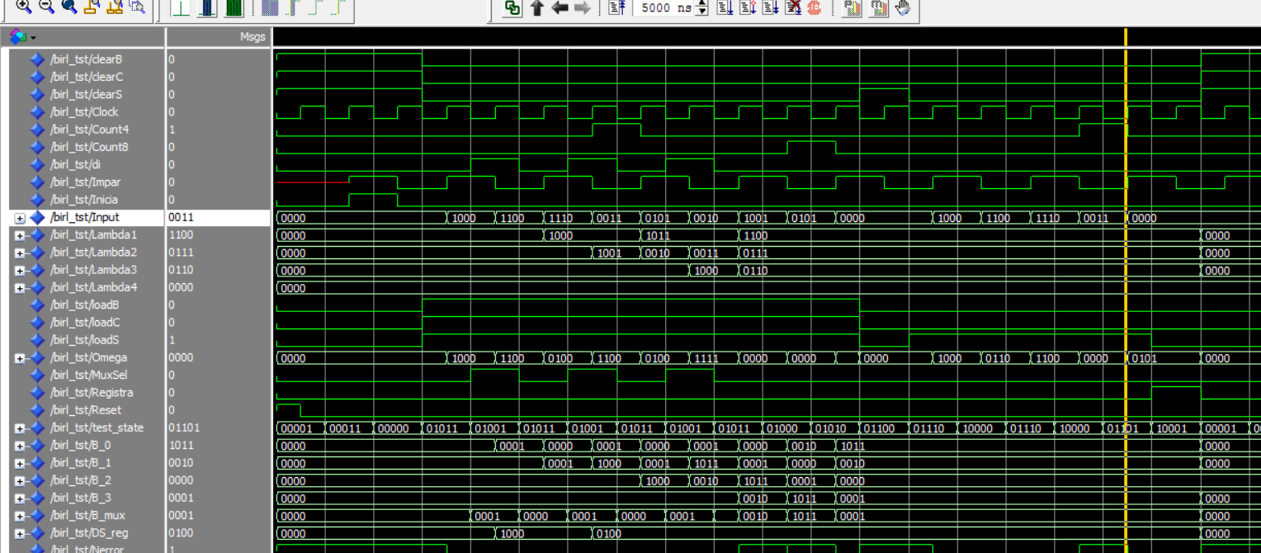
Reed Solomon decoder/simulation/modelsim/berlekamp_birl.png
