Vivianki/LiCy/Reed Solomon decoder/simulation/modelsim/BerlekampChienForney.png

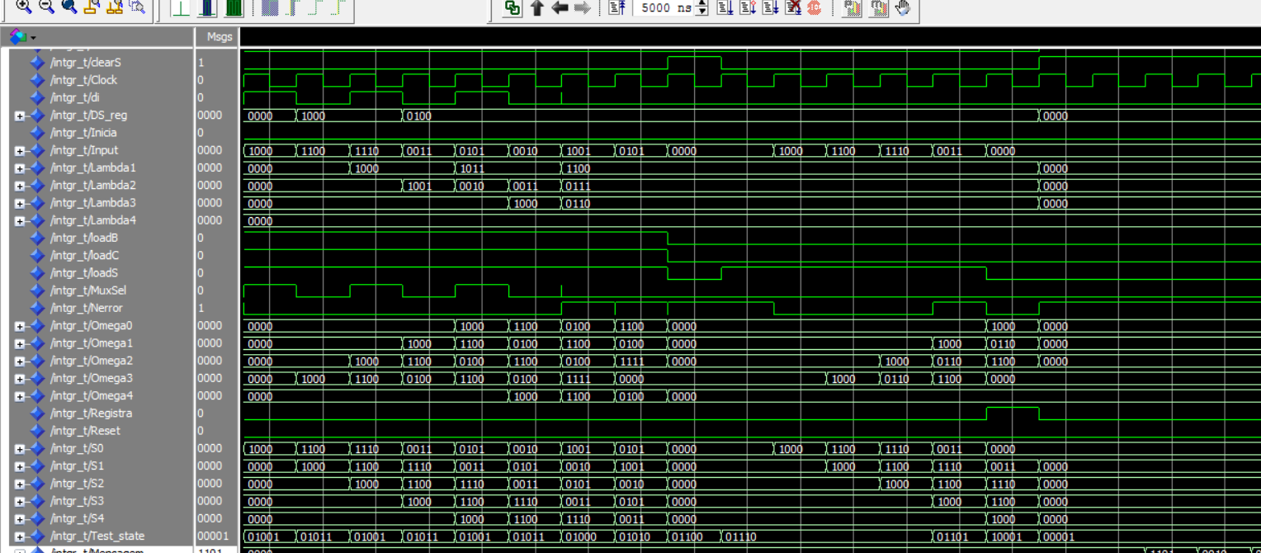
Reed Solomon decoder/simulation/modelsim/BerlekampChienForney.png
