Vivianki/LiCy/Reed Solomon decoder/simulation/modelsim/chien sim.png

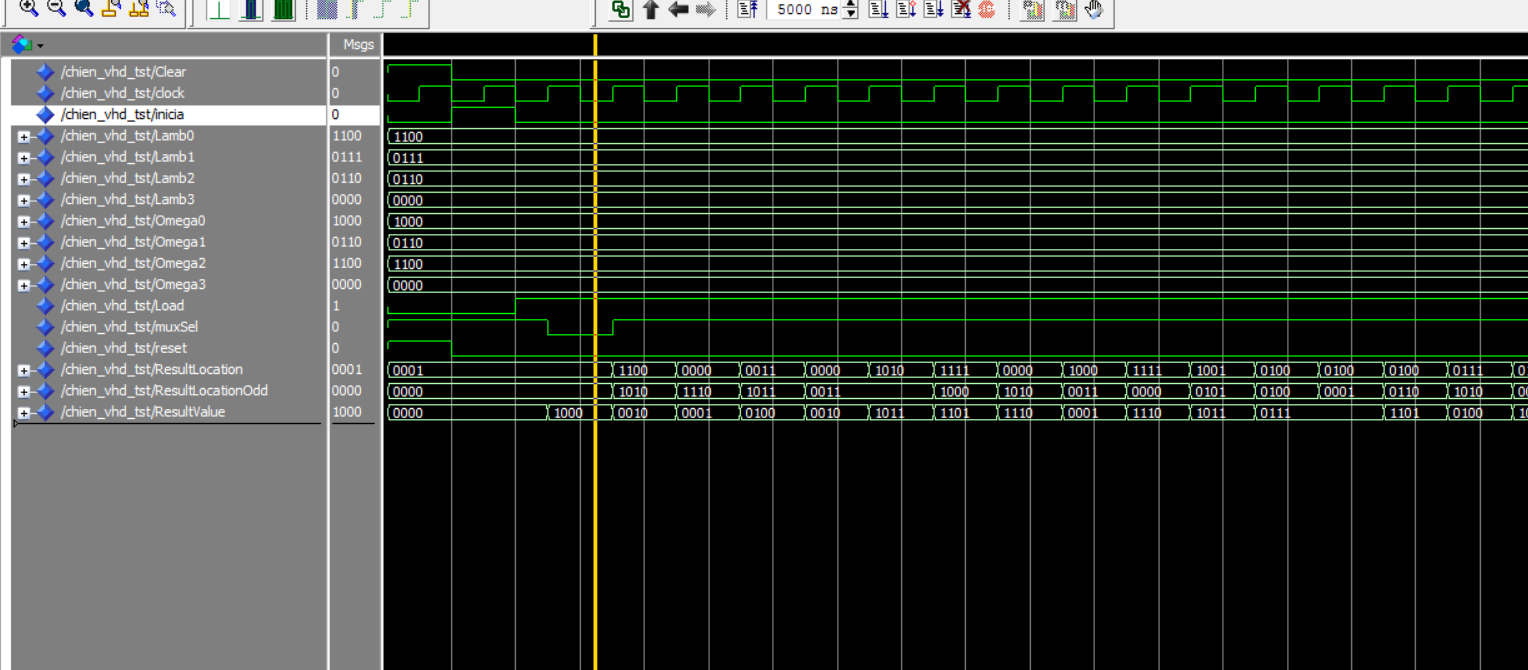
Reed Solomon decoder/simulation/modelsim/chien sim.png
