Vivianki/LiCy/VHDL Simulations/Working Sync Proof.png

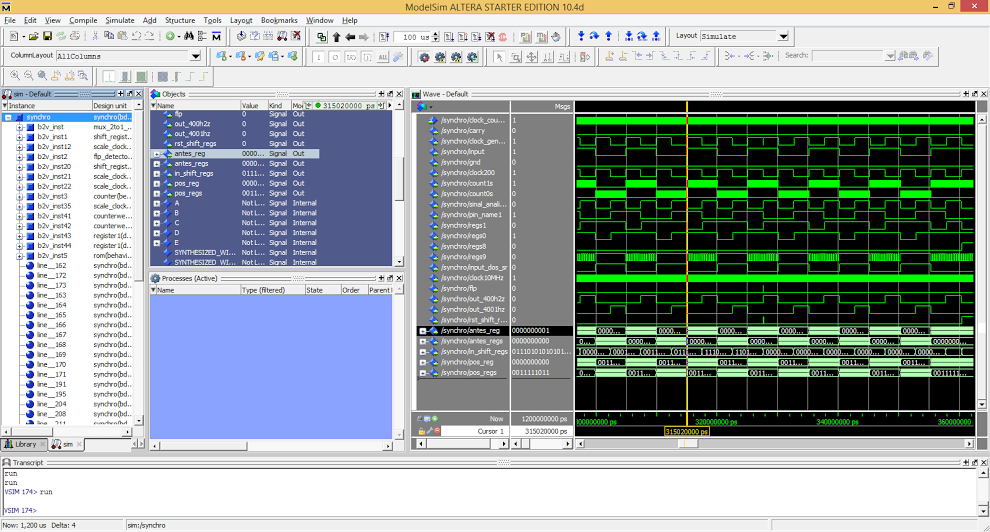
VHDL Simulations/Working Sync Proof.png
