Vivianki/LiCy/(list of files, cad)

Other CAD files:
VHDL/all_cycl5/all.stp
VHDL/Encoder/stp1.stp
VHDL/uart_test/output_files/uart_tap.stp
