Vivianki/LiCy/VHDL/uart_test/uart/uart.html

uart

2016.10.31.18:43:28 | Datasheet

Overview

All Components
rs232_0 altera_up_avalon_rs232 15.1

Memory Map

| rs232_0

avalon_rs232_slave

## rs232_0

altera_up_avalon_rs232 v15.1

Parameters

avalon_bus_type | Memory Mapped
clk_rate | 50000000
baud | 9600
parity | Odd
data_bits | 8
stop_bits | 1
AUTO_DEVICE_FAMILY | CYCLONEIVE
AUTO_CLK_CLOCK_RATE | 0
deviceFamily | Cyclone IV E
generateLegacySim | false

Software Assignments
(none)

generation took 0.00 seconds | rendering took 0.03 seconds
