Vivianki/LiCy/VHDL/uart_test/uart/testbench/uart_tb.html

uart_tb

2016.10.23.17:58:14 | Datasheet

Overview

All Components
uart_inst uart 1.0
uart_inst_rs232_0 altera_up_avalon_rs232 15.1

Memory Map

| uart_inst_avalon_rs232_slave_bfm
| m0
uart_inst
avalon_rs232_slave
uart_inst_rs232_0
avalon_rs232_slave | 0x00000000

## uart_inst

uart v1.0

Parameters

AUTO_GENERATION_ID | 1477252694
AUTO_UNIQUE_ID | uart
AUTO_DEVICE_FAMILY | CYCLONEIVE
AUTO_DEVICE | EP4CE30F23C7
AUTO_DEVICE_SPEEDGRADE | 7
AUTO_CLK_CLOCK_RATE | 0
AUTO_CLK_CLOCK_DOMAIN | 1
AUTO_CLK_RESET_DOMAIN | 1
deviceFamily | Cyclone IV E
generateLegacySim | false

Software Assignments
(none)

## uart_inst_rs232_0

altera_up_avalon_rs232 v15.1

uart_inst_avalon_rs232_slave_bfm | m0 | uart_inst_rs232_0
| avalon_rs232_slave
uart_inst_clk_bfm | clk
| clk
uart_inst_external_interface_bfm | conduit
| external_interface
uart_inst_interrupt_bfm | irq
| interrupt
uart_inst_reset_bfm | reset
| reset

Parameters

avalon_bus_type | Memory Mapped
clk_rate | 50000000
baud | 9600
parity | Odd
data_bits | 8
stop_bits | 1
AUTO_DEVICE_FAMILY | CYCLONEIVE
AUTO_CLK_CLOCK_RATE | 0
deviceFamily | Cyclone IV E
generateLegacySim | false

Software Assignments
(none)

## uart_inst_avalon_rs232_slave_bfm

altera_avalon_mm_master_bfm v15.1

uart_inst_clk_bfm | clk | uart_inst_avalon_rs232_slave_bfm
| clk
uart_inst_reset_bfm | reset
| clk_reset
| | | m0 | uart_inst_rs232_0
| | | avalon_rs232_slave

Parameters

AV_ADDRESS_W | 1
AV_SYMBOL_W | 8
AV_NUMSYMBOLS | 4
AV_BURSTCOUNT_W | 1
AV_READRESPONSE_W | 1
AV_WRITERESPONSE_W | 1
USE_READ | 1
USE_WRITE | 1
USE_ADDRESS | 1
USE_BYTE_ENABLE | 1
USE_BURSTCOUNT | 0
USE_READ_DATA | 1
USE_READ_DATA_VALID | 0
USE_WRITE_DATA | 1
USE_BEGIN_TRANSFER | 0
USE_BEGIN_BURST_TRANSFER | 0
USE_ARBITERLOCK | 0
USE_LOCK | 0
USE_DEBUGACCESS | 0
USE_WAIT_REQUEST | 0
USE_TRANSACTIONID | 0
USE_WRITERESPONSE | 0
USE_READRESPONSE | 0
USE_CLKEN | 0
ASSERT_HIGH_RESET | 1
ASSERT_HIGH_WAITREQUEST | 1
ASSERT_HIGH_READ | 1
ASSERT_HIGH_WRITE | 1
ASSERT_HIGH_BYTEENABLE | 1
ASSERT_HIGH_READDATAVALID | 1
ASSERT_HIGH_ARBITERLOCK | 1
ASSERT_HIGH_LOCK | 1
AV_CONSTANT_BURST_BEHAVIOR | 1
AV_BURST_LINEWRAP | 0
AV_BURST_BNDR_ONLY | 0
AV_ALWAYS_BURST_MAX_BURST | 0
AV_MAX_PENDING_READS | 0
AV_MAX_PENDING_WRITES | 0
AV_FIX_READ_LATENCY | 1
AV_READ_WAIT_TIME | 0
AV_WRITE_WAIT_TIME | 0
REGISTER_WAITREQUEST | 0
AV_REGISTERINCOMINGSIGNALS | 0
ADDRESS_UNITS | WORDS
VHDL_ID | 0
deviceFamily | UNKNOWN
generateLegacySim | false

Software Assignments
(none)

## uart_inst_clk_bfm

altera_avalon_clock_source v15.1

Parameters

CLOCK_RATE | 50000000
CLOCK_UNIT | 1
deviceFamily | UNKNOWN
generateLegacySim | false

Software Assignments
(none)

## uart_inst_external_interface_bfm

altera_conduit_bfm v15.1

Parameters

CLOCKED_SIGNAL | false
ENABLE_RESET | false
SIGNAL_ROLES | RXD,TXD
SIGNAL_WIDTHS | 1,1
SIGNAL_DIRECTIONS | output,input
deviceFamily | UNKNOWN
generateLegacySim | false

Software Assignments
(none)

## uart_inst_interrupt_bfm

altera_avalon_interrupt_sink v15.1

uart_inst_clk_bfm | clk | uart_inst_interrupt_bfm
| clock_reset
uart_inst_reset_bfm | reset
| clock_reset_reset
| | | irq | uart_inst_rs232_0
| | | interrupt

Parameters

ASSERT_HIGH_IRQ | 1
AV_IRQ_W | 1
ASYNCHRONOUS_INTERRUPT | 0
VHDL_ID | 0
deviceFamily | UNKNOWN
generateLegacySim | false

Software Assignments
(none)

## uart_inst_reset_bfm

altera_avalon_reset_source v15.1

uart_inst_clk_bfm | clk | uart_inst_reset_bfm
| clk
| | | reset | uart_inst_avalon_rs232_slave_bfm
| | | clk_reset
| | | reset | uart_inst_interrupt_bfm
| | | clock_reset_reset
| | | reset | uart_inst_rs232_0
| | | reset

Parameters

ASSERT_HIGH_RESET | 1
INITIAL_RESET_CYCLES | 50
deviceFamily | UNKNOWN
generateLegacySim | false

Software Assignments
(none)

generation took 0.00 seconds | rendering took 0.02 seconds
