Vivianki/LiCy/Documentos/relatorio/Req_Tree_Digital.pdf

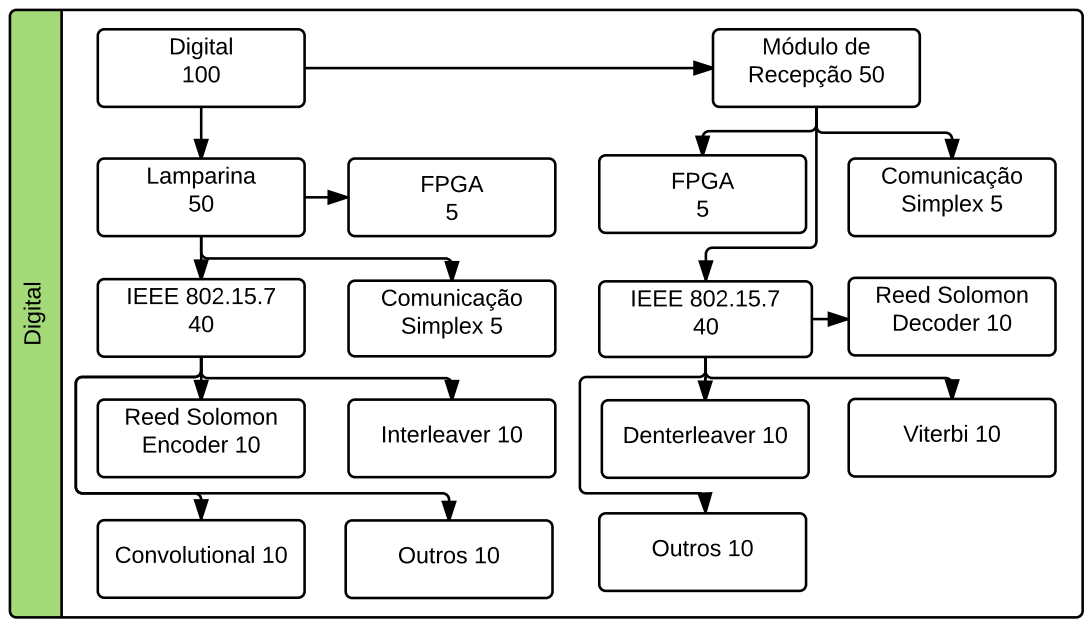
[picture p65: page 1]
Digital 100; Lamparina 50; FPGA 5; IEEE 802.15.7 40; Comunicação Simplex 5; IEEE 802.15.7; 40 Digital; Reed Solomon Encoder 10; Interleaver 10; Convolutional 10; Outros 10; Denterleaver 10; Viterbi 10

Módulo de Recepção 50

Reed Solomon Decoder 10
