Vivianki/LiCy/Documentos/relatorio/Req_Tree_NFunc.pdf

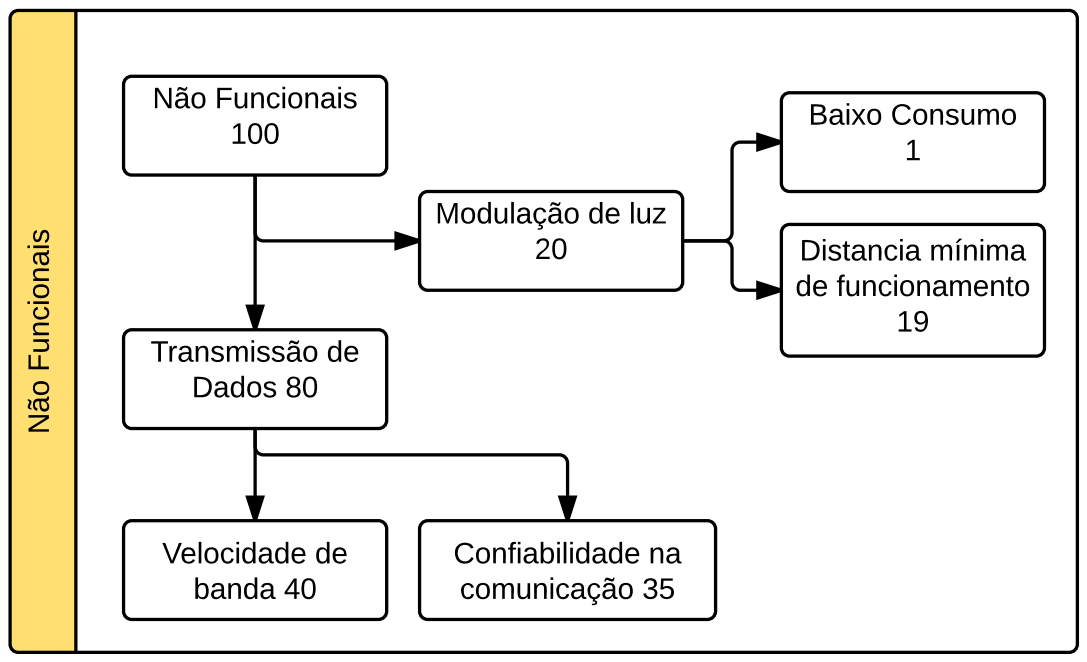
[picture p66: page 1]
Não Funcionais 100; Velocidade de banda 40; Confiabilidade na comunicação 35; Distancia mínima de funcionamento 19; Baixo Consumo 1; Não Funcionais

Modulação de luz

Transmissão de Dados 80
