Vivianki/LiCy/Documentos/relatorio/circuits/transimpedance_amp.pdf

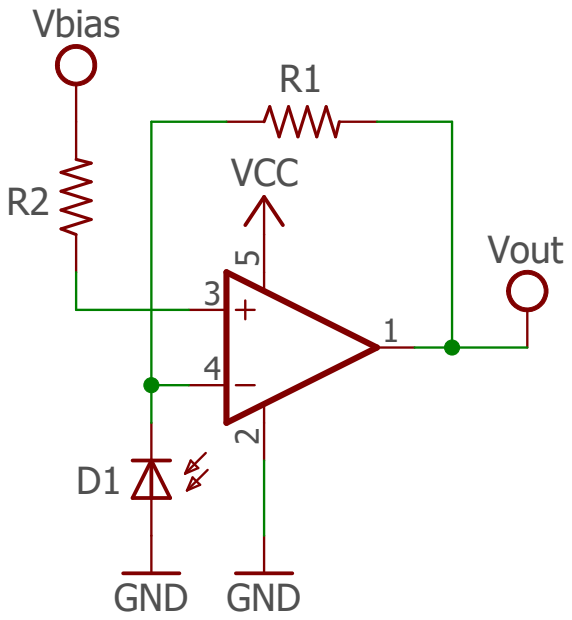
[picture p67: page 1]
VCC; GND; Vout; Vbias
