Vivianki/LiCy/Documentos/relatorio/circuits/dataflow_analog_circuits.pdf

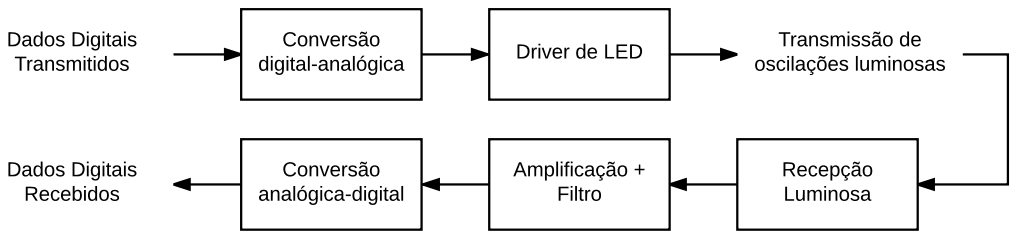
[picture p68: page 1]
Dados Digitais Transmitidos; Transmissão de oscilações luminosas; Recepção Luminosa; Amplificação + Filtro; Conversão analógica-digital; Conversão digital-analógica

Driver de LED

Dados Digitais Recebidos
