Vivianki/LiCy/Documentos/relatorio/circuits/mosfet_cutoff.pdf

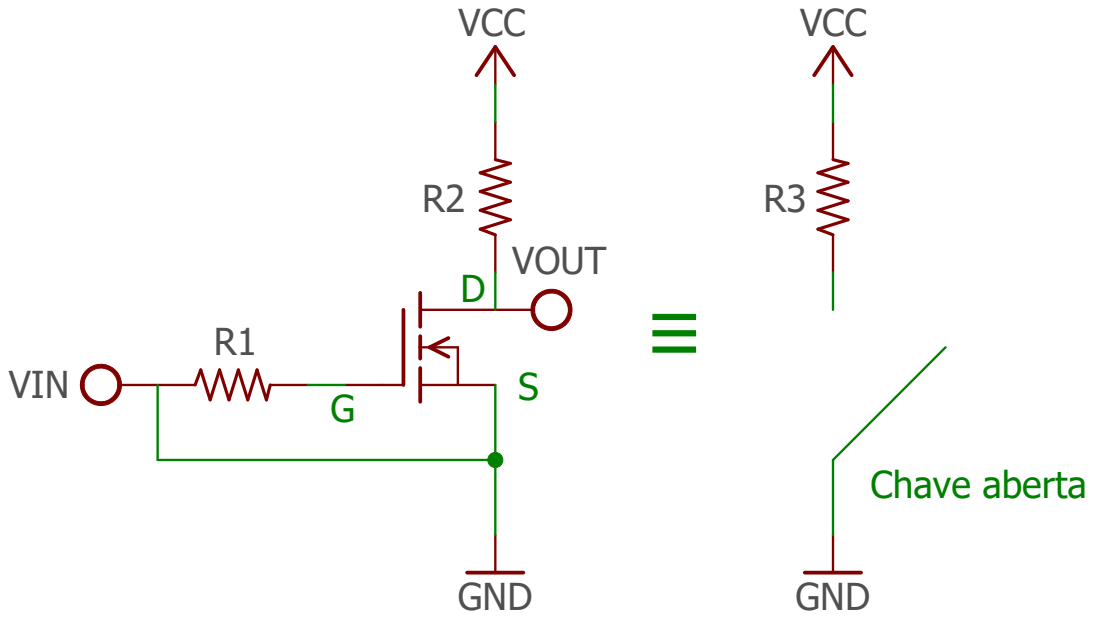
[picture p69: page 1]
VCC; GND; VIN; VOUT; Chave aberta
