Vivianki/LiCy/Documentos/relatorio/circuits/mosfet_saturation.pdf

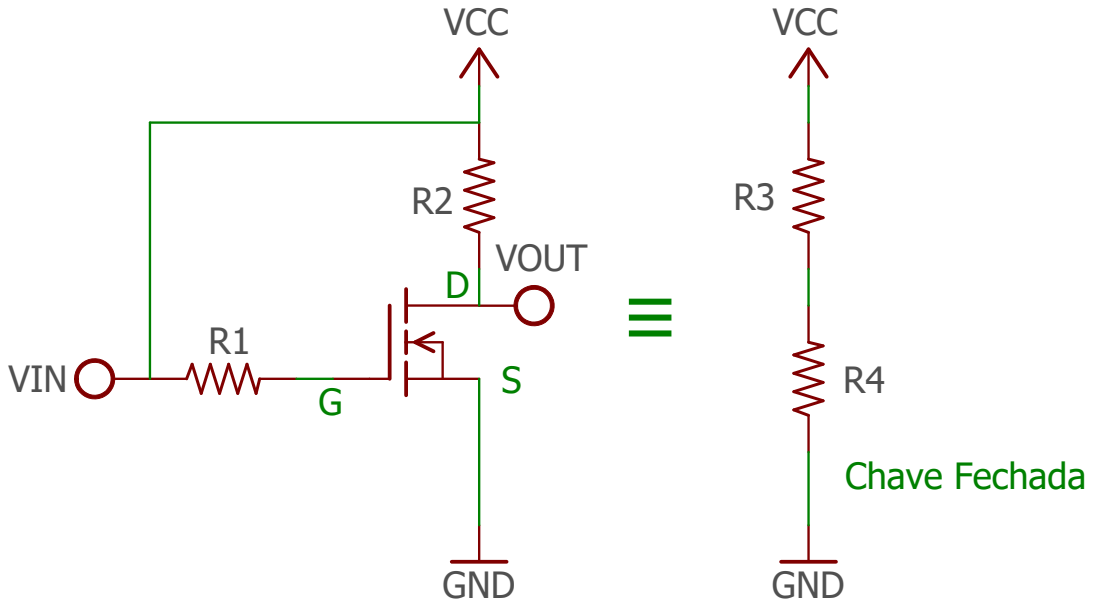
[picture p70: page 1]
VCC; GND; VIN; VOUT; Chave Fechada
