Vivianki/LiCy/Documentos/relatorio/sant-ana.pdf

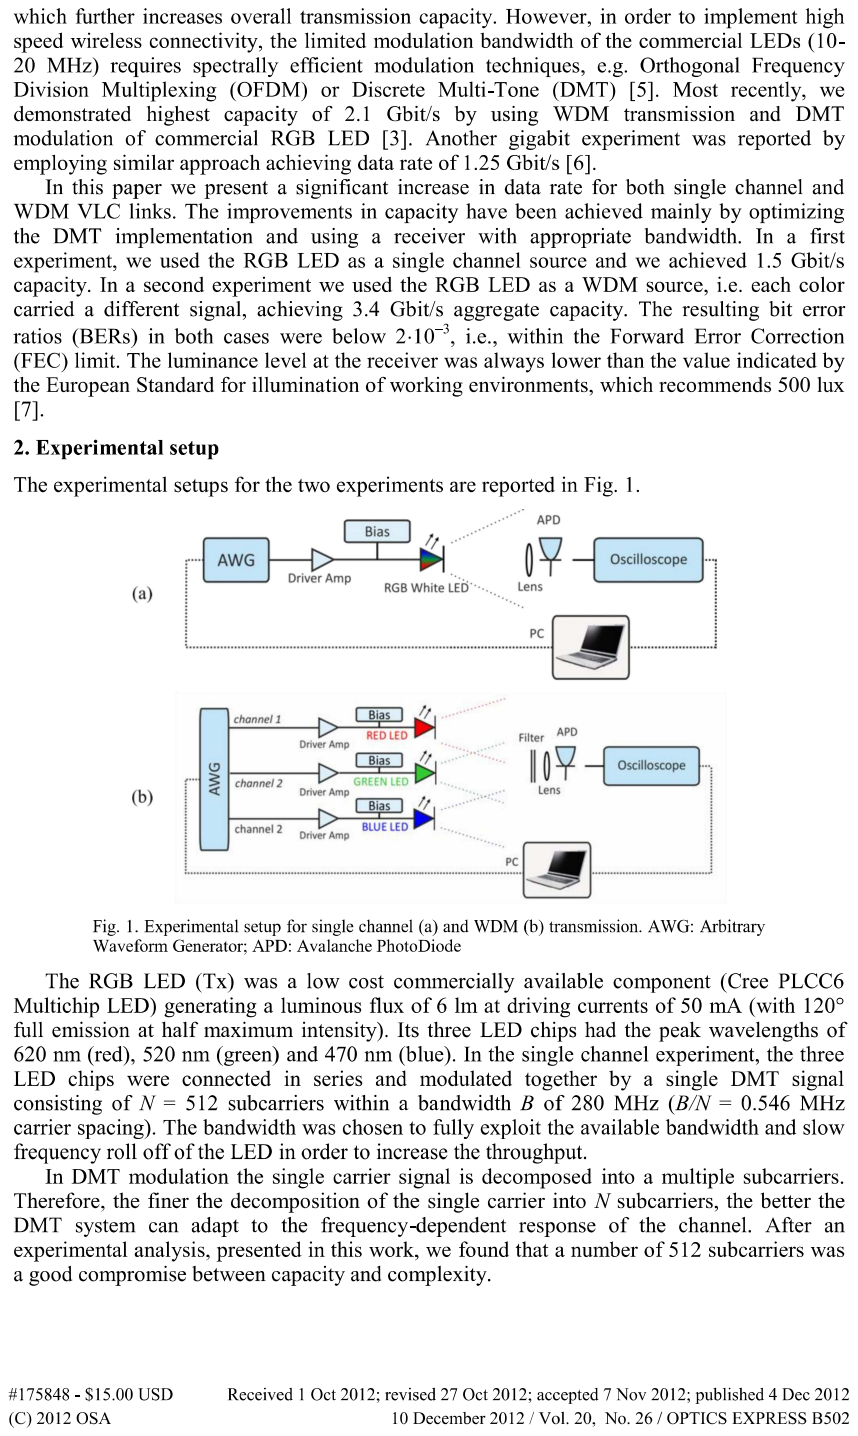
[picture p71: page 1]
