Vivianki/LiCy/Documentos/relatorio/PHY1-reception.pdf

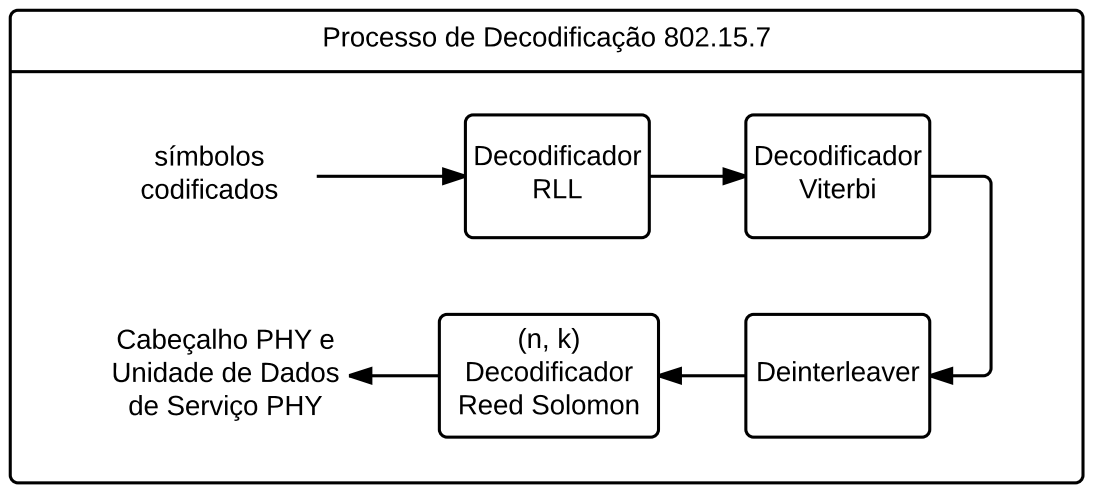
[picture p72: page 1]
símbolos codificados; Decodificador Viterbi; Deinterleaver; Decodificador RLL

Processo de Decodificação 802.15.7

Cabeçalho PHY e Unidade de Dados

Decodificador Reed Solomon

de Serviço PHY
