Vivianki/LiCy/Documentos/relatorio/PHY1-transmission.pdf

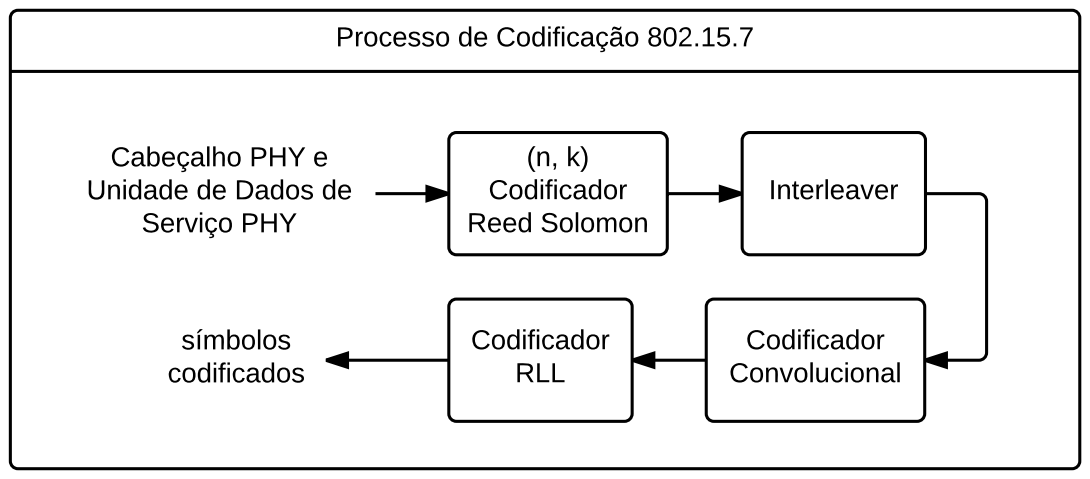
[picture p73: page 1]
Serviço PHY; Interleaver; Codificador Convolucional; Codificador RLL; símbolos codificados

Processo de Codificação 802.15.7

Cabeçalho PHY e Unidade de Dados de

Codificador Reed Solomon
