Vivianki/LiCy/Documentos/relatorio/EAP.pdf

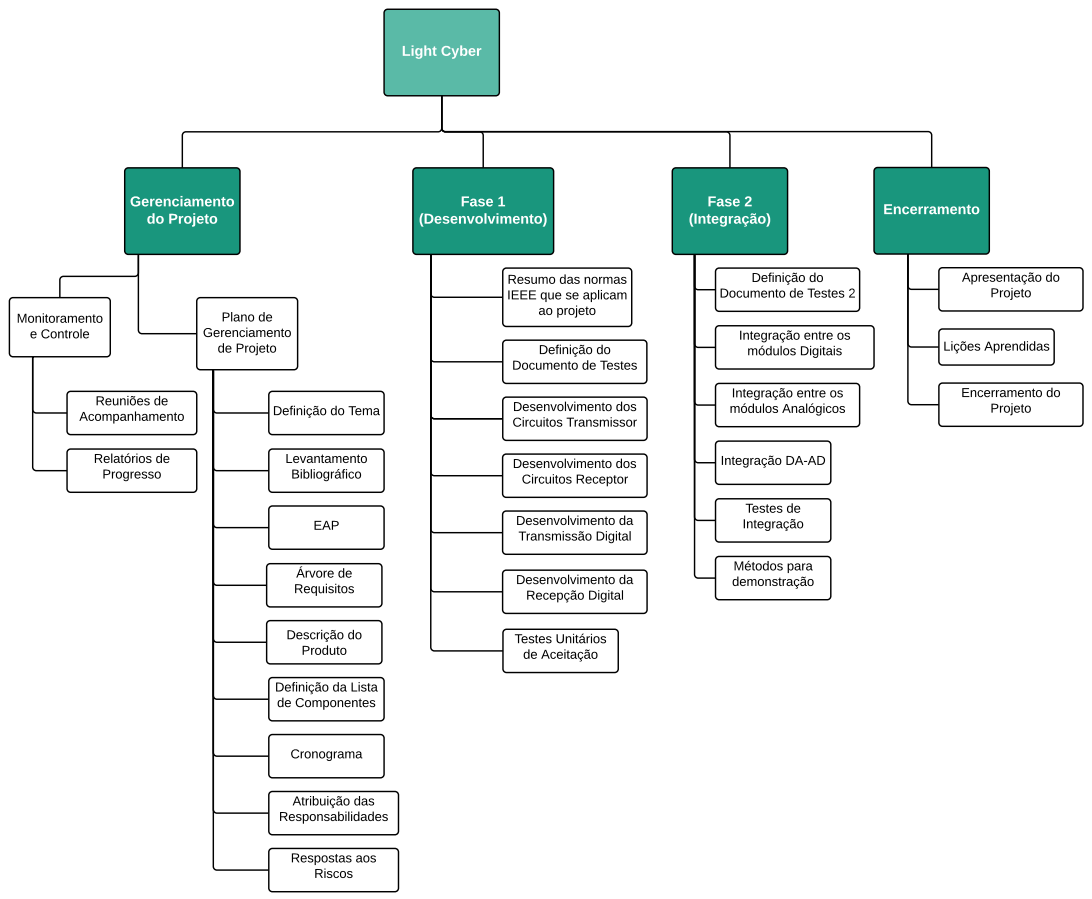
[picture p74: page 1]
Light Cyber; Gerenciamento do Projeto; Fase 1 (Desenvolvimento); Fase 2 (Integração); Levantamento Bibliográfico; Monitoramento e Controle; de Projeto; Testes Unitários de Aceitação; Encerramento; Relatórios de Progresso; EAP; Descrição do Produto; Cronograma; Lições Aprendidas; Encerramento do Projeto; Desenvolvimento da Transmissão Digital; Testes de Integração; Apresentação do Projeto; Métodos para demonstração

Resumo das normas
IEEE que se aplicam
ao projeto

Definição do Documento de Testes 2

Plano de Gerenciamento

Integração entre os módulos Digitais

Definição do Documento de Testes

Integração entre os módulos Analógicos

Definição do Tema Reuniões de
Acompanhamento

Desenvolvimento dos Circuitos Transmissor

Desenvolvimento dos Circuitos Receptor

Integração DA-AD

Árvore de Requisitos

Desenvolvimento da Recepção Digital

Definição da Lista
de Componentes

Atribuição das Responsabilidades

Respostas aos Riscos
