Vivianki/LiCy/Documentos/relatorio/Req_Tree_Analog.pdf

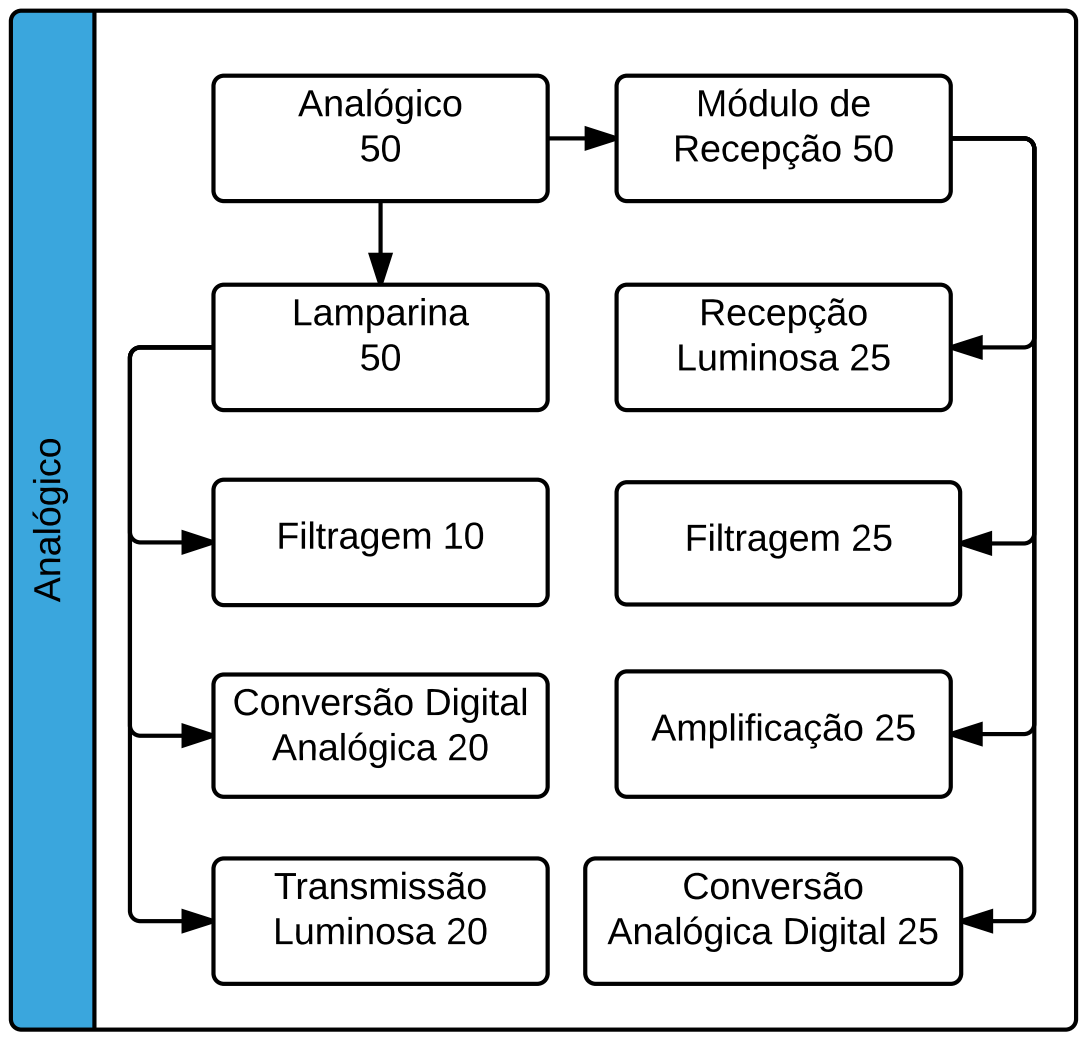
[picture p75: page 1]
Analógico 50; Lamparina 50; Transmissão Luminosa 20; Filtragem 10; Recepção Luminosa 25; Conversão Analógica Digital 25; Conversão Digital Analógica 20; Filtragem 25; Analógico; Amplificação 25

Módulo de Recepção 50
