Vivianki/LiCy/Documentos/relatorio/reed_solomon_message.pdf

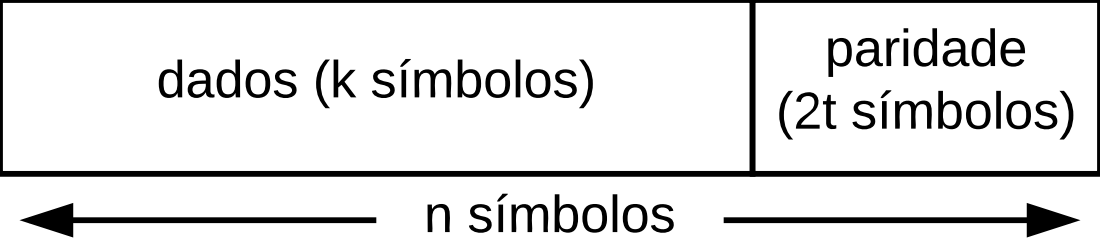
[picture p76: page 1]
dados (k símbolos); paridade; (2t símbolos); n símbolos
