Vivianki/LiCy/Documentos/relatorio/Encoder - Interleaver.pdf

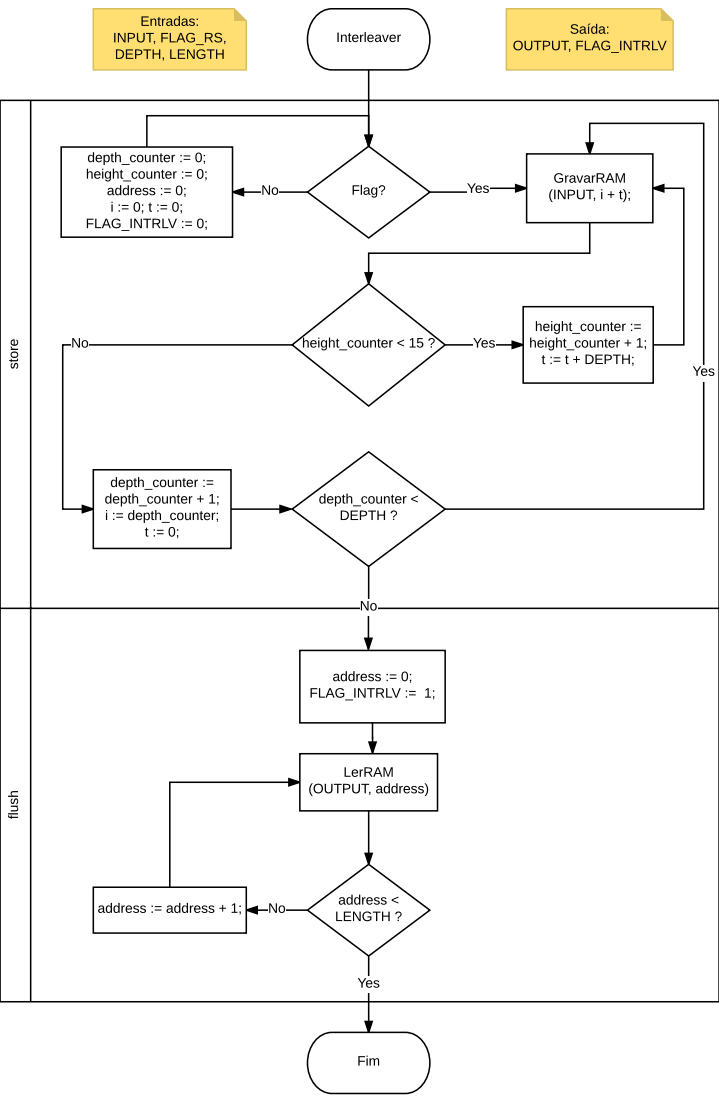
[picture p77: page 1]
Interleaver; Flag?; Yes; depth_counter := 0; height_counter := 0; address := 0; i := 0; t := 0; FLAG_INTRLV := 0;; GravarRAM (INPUT, i + t);; height_counter < 15 ?; height_counter := height_counter + 1; t := t + DEPTH;; depth_counter < DEPTH ?; depth_counter := depth_counter + 1; i := depth_counter; t := 0;; LerRAM (OUTPUT, address); Saída: OUTPUT, FLAG_INTRLV; store flush; address < LENGTH ?; Fim; address := address + 1;; address := 0; FLAG_INTRLV := 1;

Entradas:
INPUT, FLAG_RS, DEPTH, LENGTH
