Vivianki/LiCy/Documentos/relatorio/transmissao-blocos-simplificado.pdf

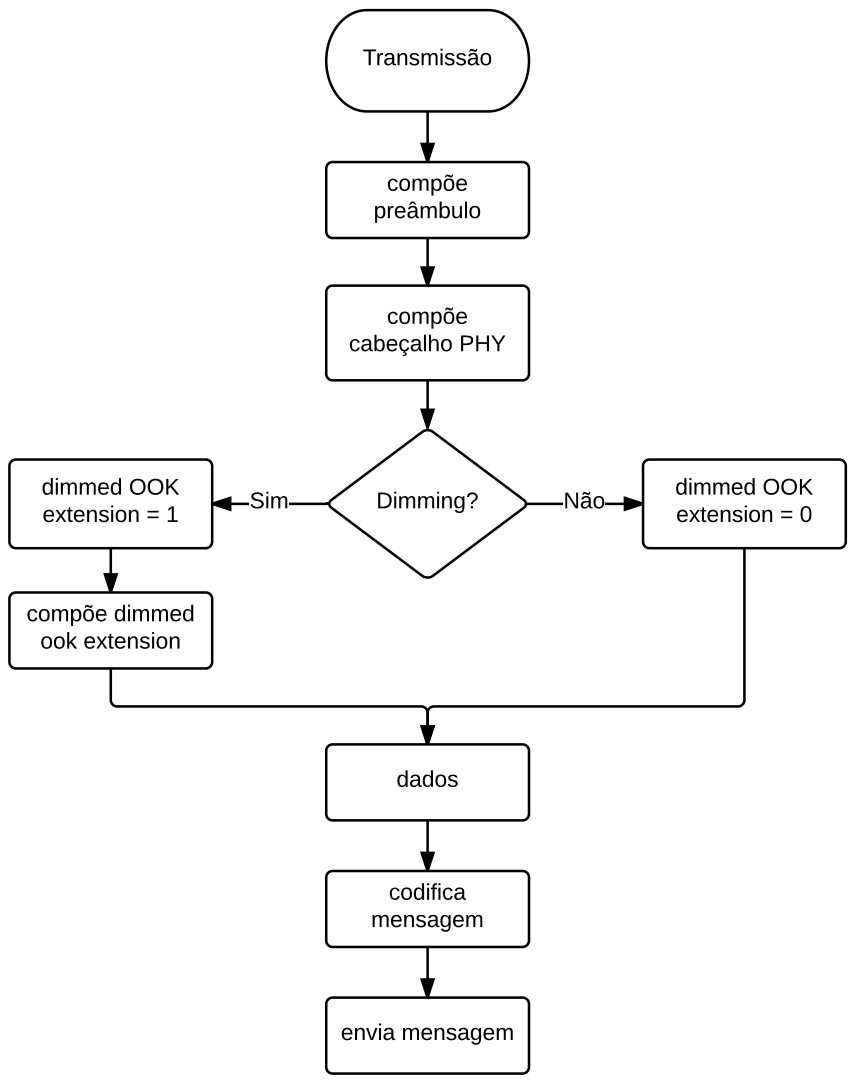
[picture p78: page 1]
Transmissão; compõe preâmbulo; compõe cabeçalho PHY; Sim; Dimming?; dimmed OOK; extension = 1; Não; dimmed OOK extension = 0; compõe dimmed ook extension; dados; codifica mensagem; envia mensagem
