Vivianki/LiCy/Documentos/relatorio/manchester/decoder-rtl.pdf

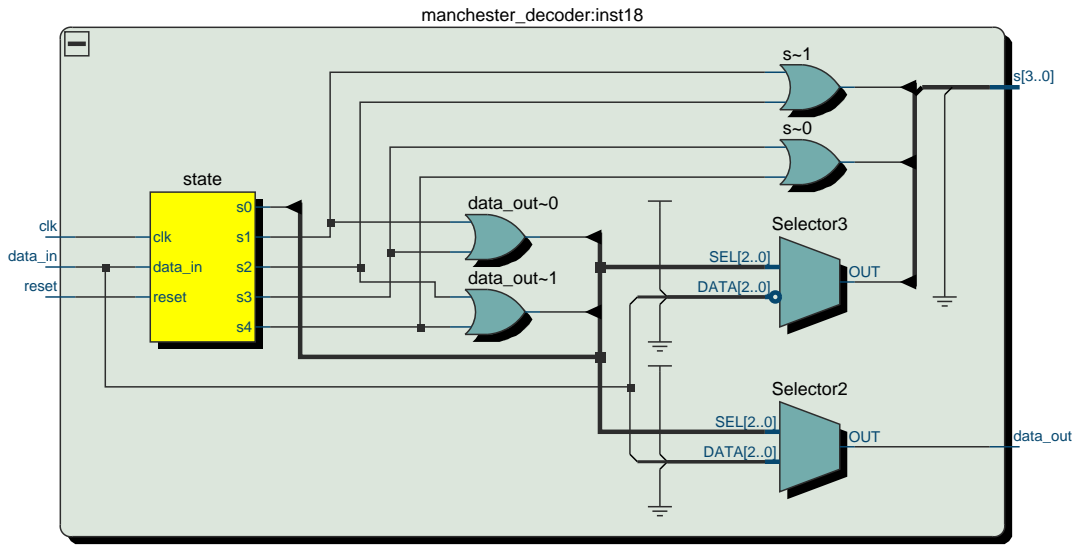
[picture p79: page 1]
manchester_decoder:inst18; clk; data_in; reset; data_out; Selector2; SEL[2..0]; DATA[2..0]; OUT; Selector3; data_out~0; data_out~1; state
