Vivianki/LiCy/Documentos/relatorio/sync/rtl.pdf

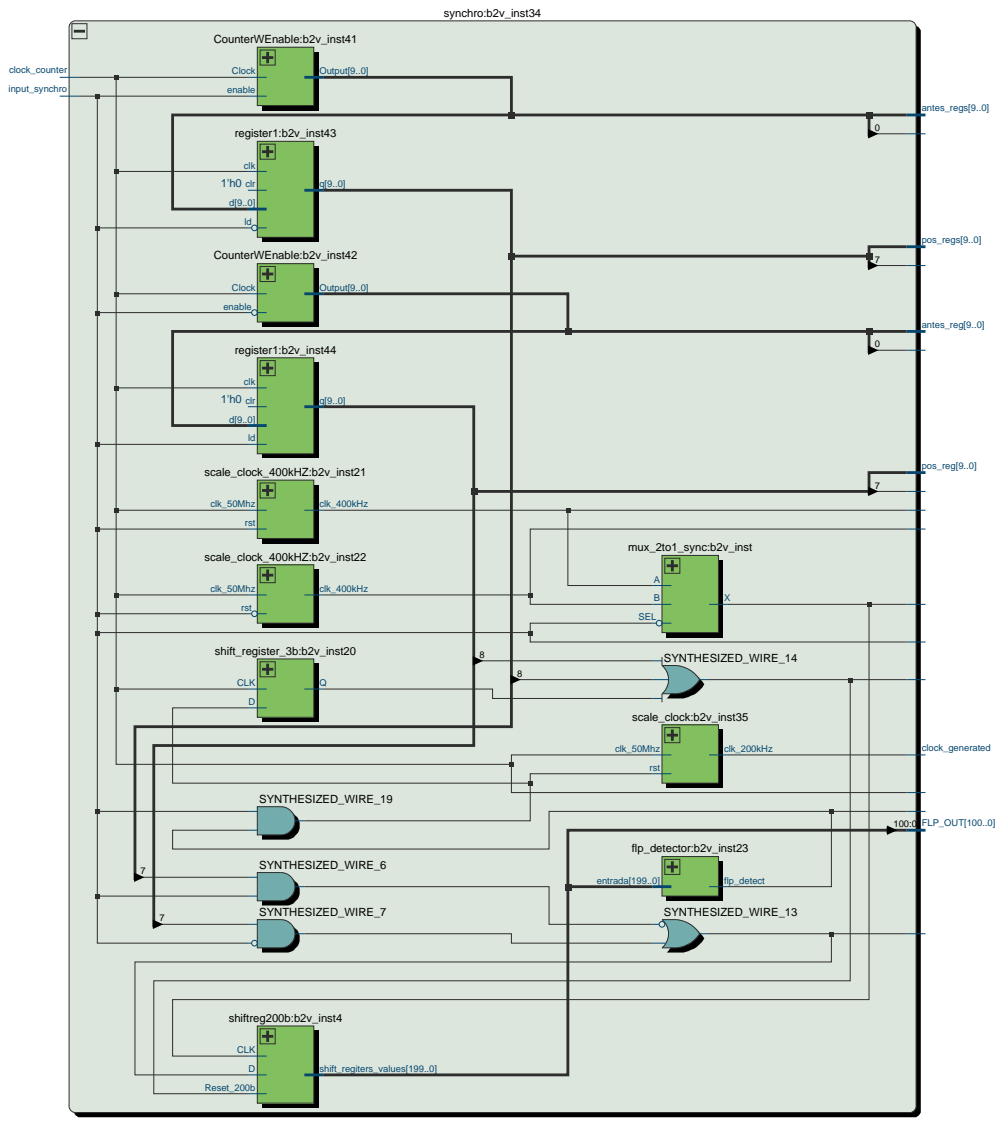
[picture p80: page 1]
synchro:b2v_inst34; clock_counter; input_synchro; clock_generated; antes_reg[9..0]; antes_regs[9..0]; FLP_OUT[100..0]; pos_reg[9..0]; pos_regs[9..0]; CounterWEnable:b2v_inst41; Clock; enable; Output[9..0]; CounterWEnable:b2v_inst42; SYNTHESIZED_WIRE_6; SYNTHESIZED_WIRE_7; SYNTHESIZED_WIRE_13; SYNTHESIZED_WIRE_14; SYNTHESIZED_WIRE_19; flp_detector:b2v_inst23; entrada[199..0]; flp_detect; mux_2to1_sync:b2v_inst; SEL; register1:b2v_inst43; clk 1'h0 clr; register1:b2v_inst44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
