Vivianki/LiCy/Documentos/relatorio/sync/schematics.pdf

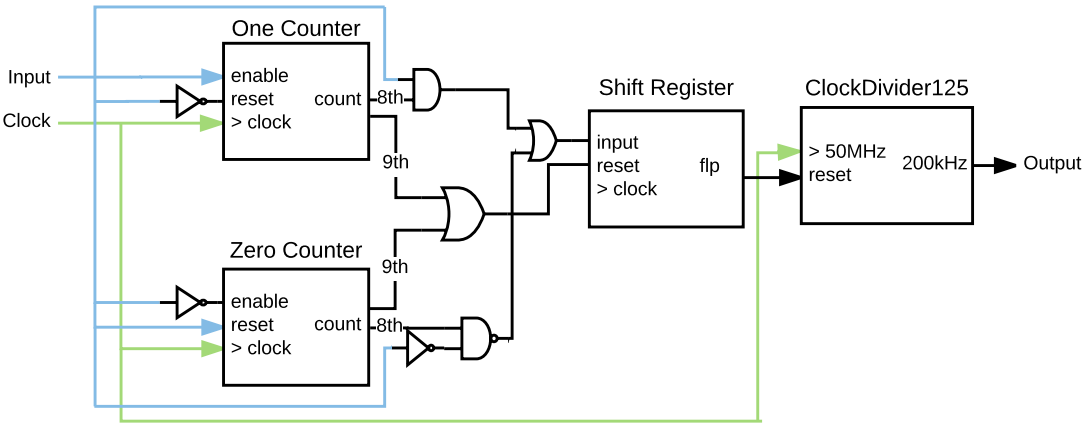
[picture p81: page 1]
ble; clo; hif; gis; r input reset > clock; flp Input; Clo; Divid
