Vivianki/LiCy/Documentos/relatorio/interleaver/flow.pdf

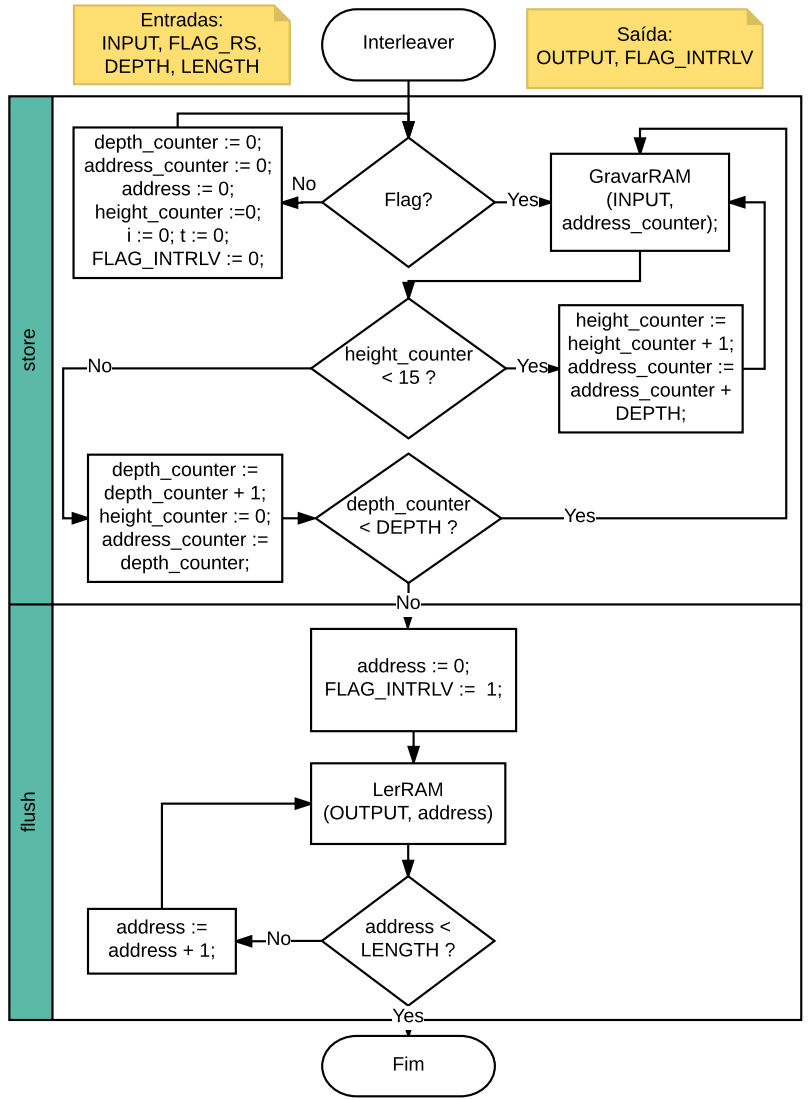
[picture p82: page 1]
Interleaver; Flag?; Yes; depth_counter := 0; address_counter := 0; address := 0; height_counter :=0; i := 0; t := 0; FLAG_INTRLV := 0;; GravarRAM (INPUT, address_counter);; height_counter; height_counter := height_counter + 1; address_counter := address_counter + DEPTH;; depth_counter < DEPTH ?; depth_counter := depth_counter + 1; height_counter := 0; address_counter := depth_counter;; LerRAM (OUTPUT, address); Saída: OUTPUT, FLAG_INTRLV; store flush; address < LENGTH ?; Fim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

Entradas:
INPUT, FLAG_RS, DEPTH, LENGTH
