Vivianki/LiCy/Documentos/relatorio/interleaver/order.pdf

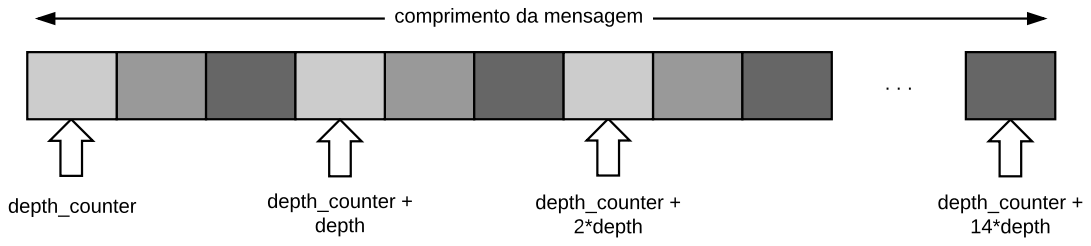
[picture p83: page 1]
depth_counter; depth_counter +; depth; depth_counter + 2*depth; depth_counter + 14*depth

comprimento da mensagem
