Vivianki/LiCy/Documentos/relatorio/interleaver/schematics.pdf

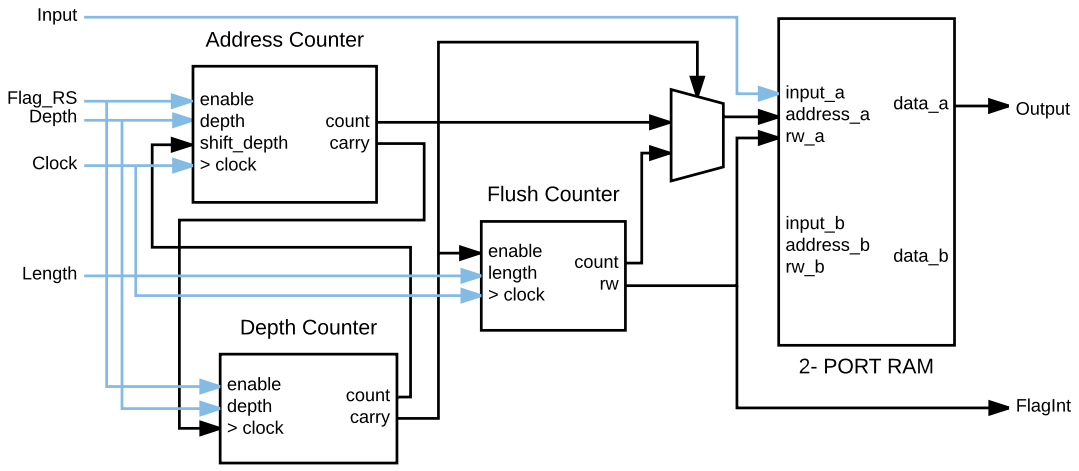
[picture p84: page 1]
a input; ble; clo; Flu; Fla; Clo; gIn

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

s hif >

ble length > clock
