Vivianki/LiCy/Documentos/relatorio/manchester/decoder-flow.pdf

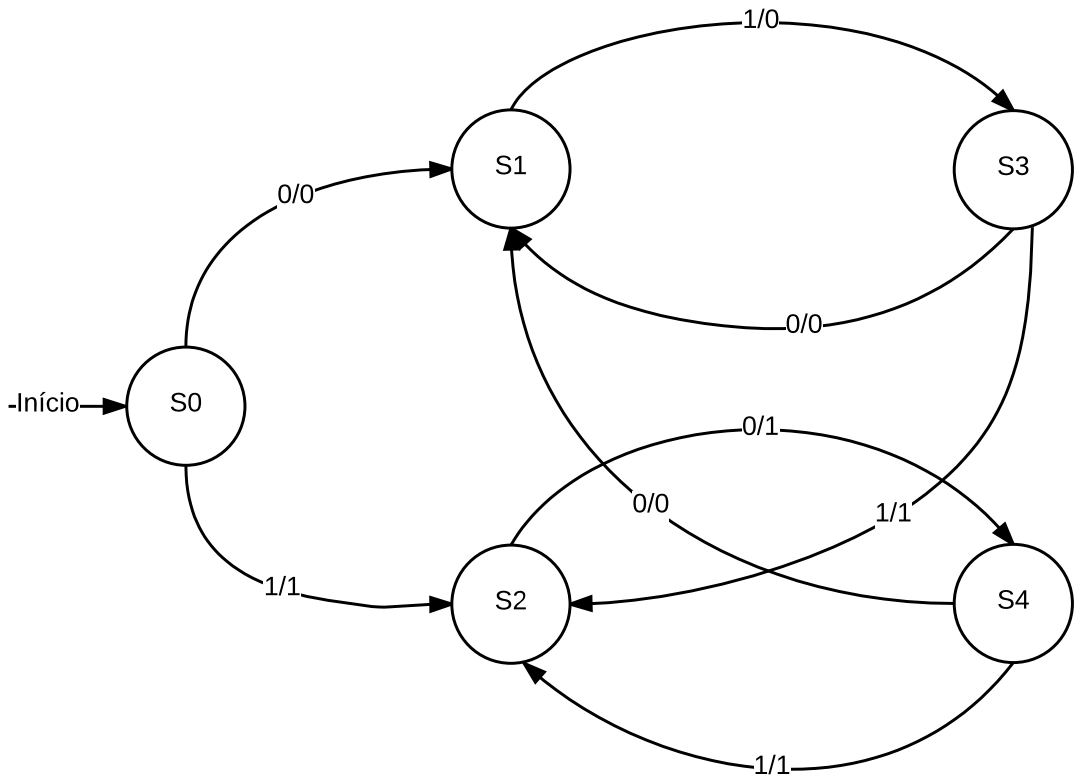
[picture p85: page 1]
Início
