Vivianki/LiCy/Documentos/relatorio/uart/txrx.pdf

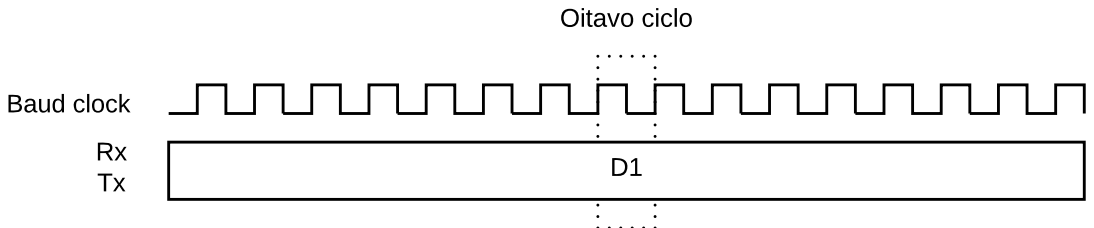
[picture p86: page 1]
clo; Oit; ciclo
