Vivianki/LiCy/Documentos/relatorio/frame/PSDU.pdf

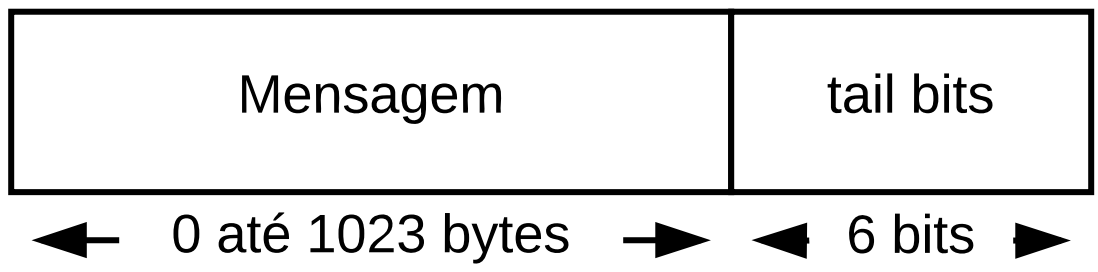
[picture p87: page 1]
Mensagem; tail bits; 0 até 1023 bytes; 6 bits
