Vivianki/LiCy/Documentos/relatorio/RS/BerlekampRTL.pdf

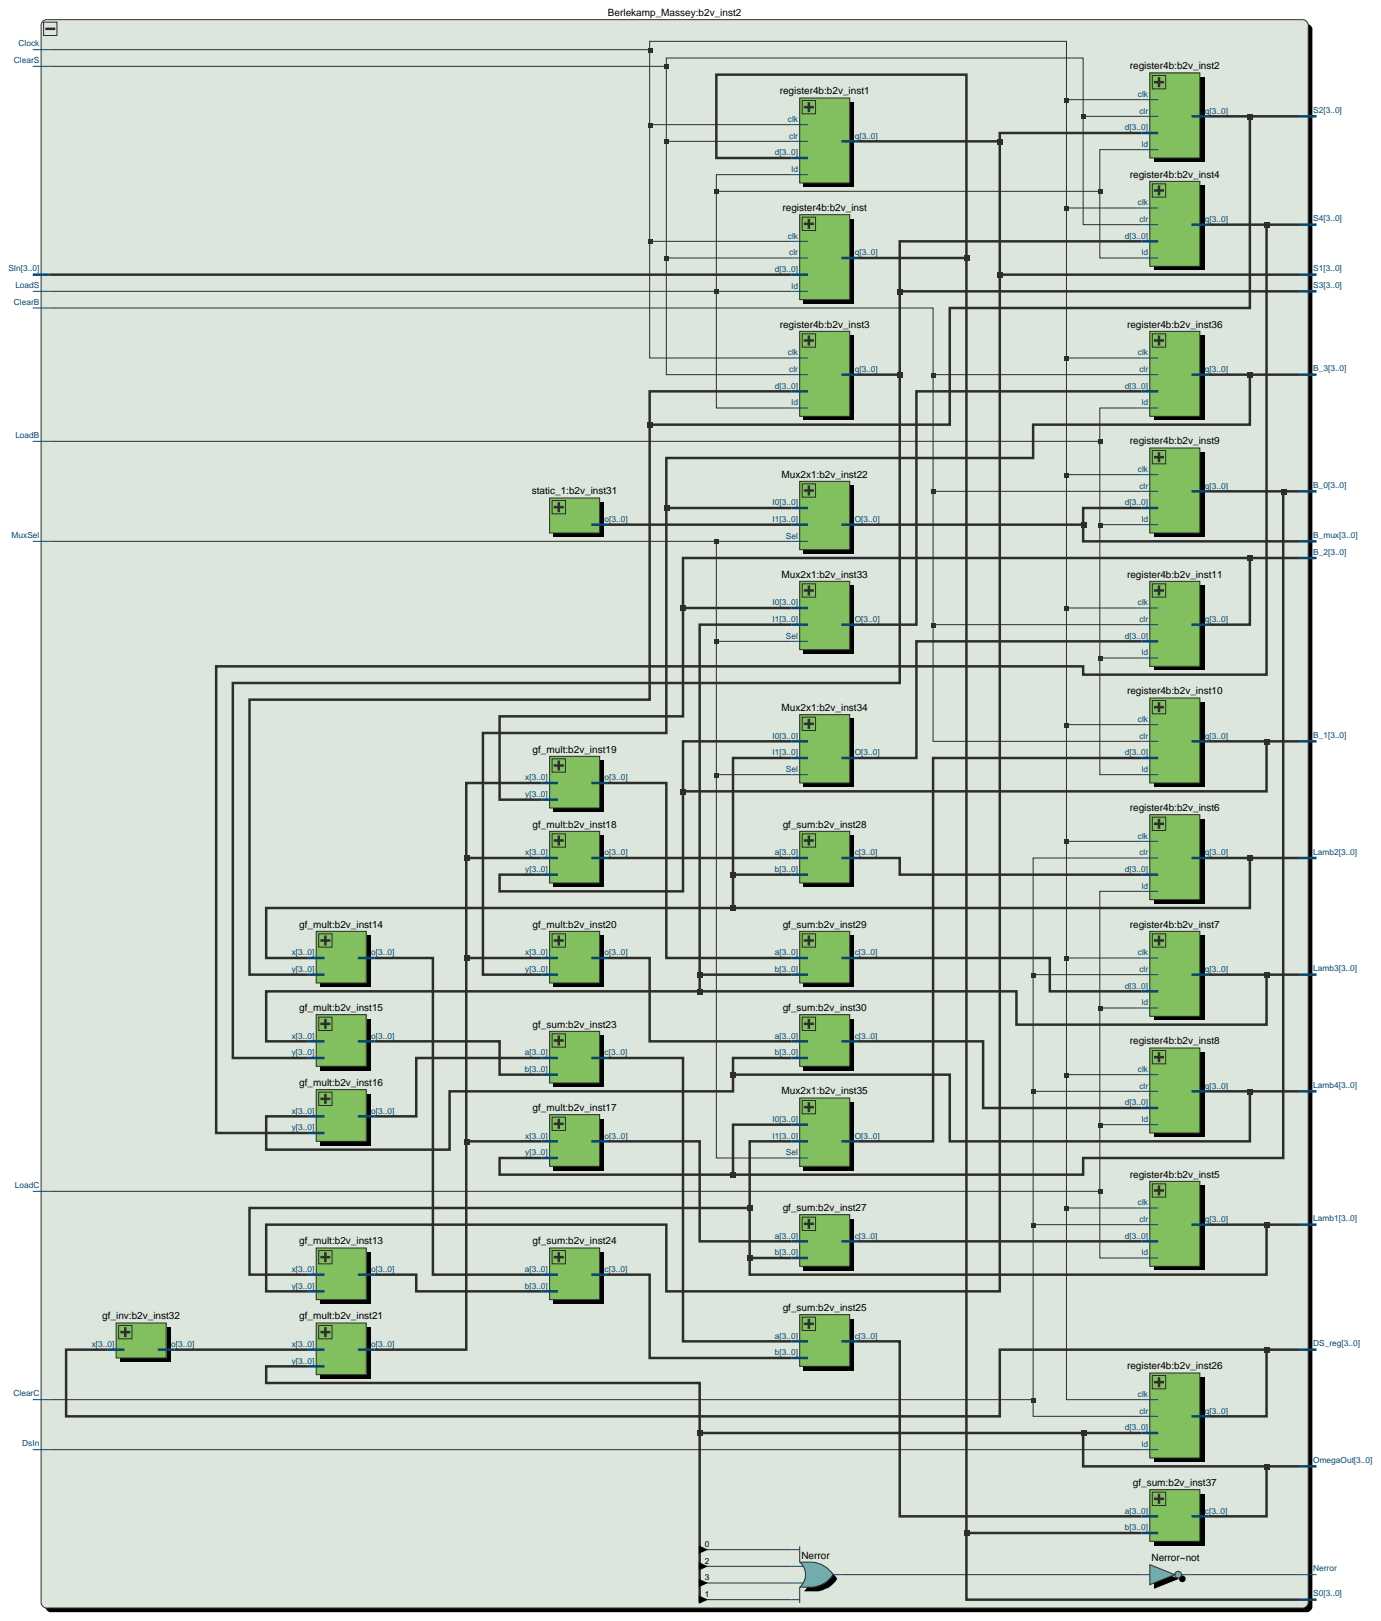
[picture p88: page 1]
Berlekamp_Massey:b2v_inst2; ClearB; ClearC; ClearS; Clock; DsIn; LoadB; LoadC; LoadS; MuxSel; SIn[3..0]; Nerror; B_mux[3..0]; DS_reg[3..0]; Lamb1[3..0]; Lamb2[3..0]; Lamb3[3..0]; Lamb4[3..0]; OmegaOut[3..0]; Mux2x1:b2v_inst22; Sel; Mux2x1:b2v_inst33; Mux2x1:b2v_inst34; Mux2x1:b2v_inst35; Nerror~not; gf_inv:b2v_inst32; gf_mult:b2v_inst13; gf_mult:b2v_inst14; gf_mult:b2v_inst15; gf_mult:b2v_inst16; gf_mult:b2v_inst17; gf_mult:b2v_inst18; gf_mult:b2v_inst19; gf_mult:b2v_inst20; gf_mult:b2v_inst21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
