Vivianki/LiCy/Documentos/relatorio/convolutional/puncture.pdf

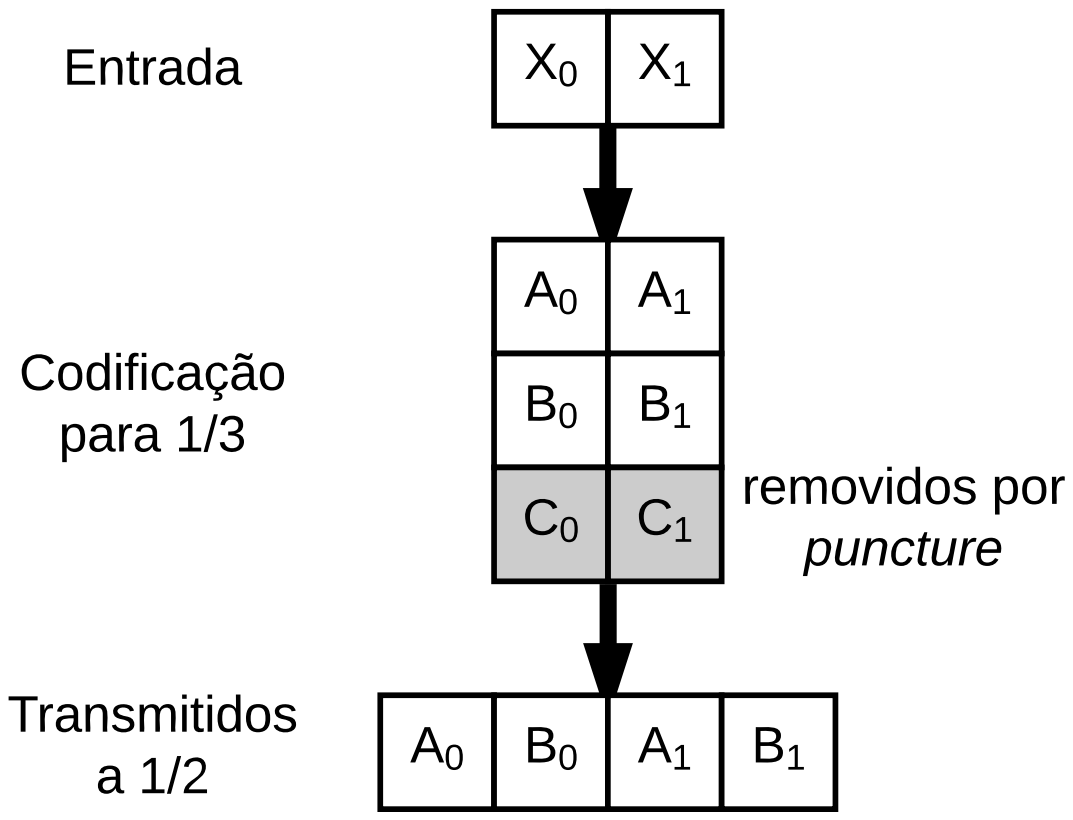
[picture p89: page 1]
Entrada; Codificação para 1/3; Transmitidos a 1/2; removidos por puncture

A0 | A1
B0 | B1
C0 | C1
