Vivianki/LiCy/Documentos/relatorio/convolutional/repetition.pdf

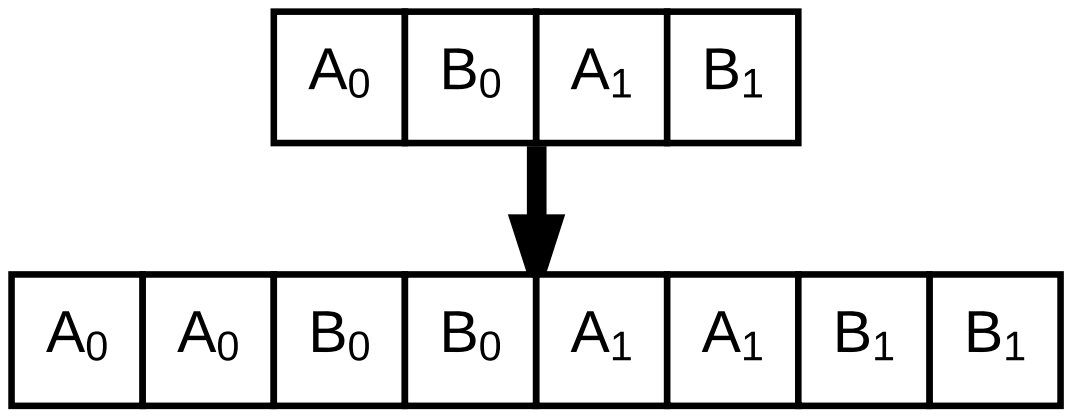
[picture p90: page 1]
