Vivianki/LiCy/Documentos/relatorio/convolutional/schematics.pdf

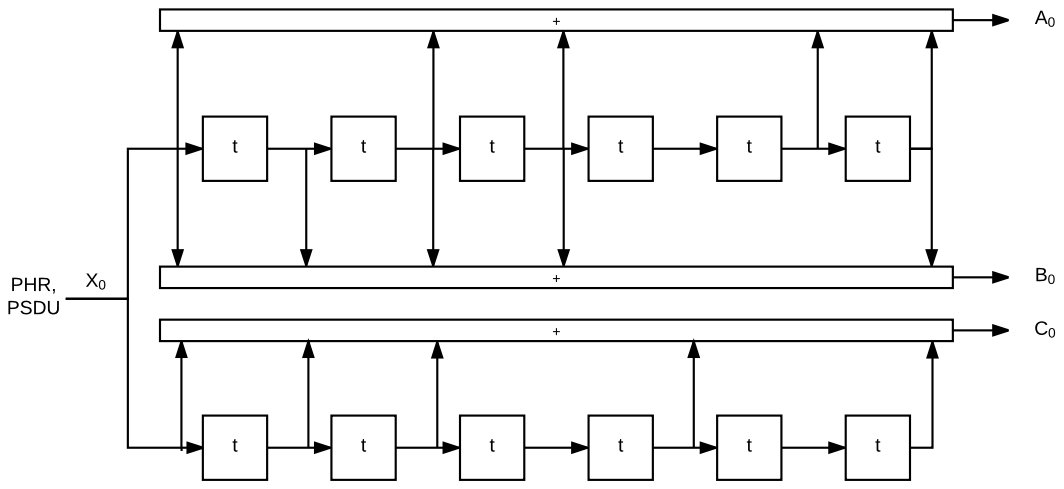
[picture p91: page 1]
R, PSDU
