Vivianki/LiCy/Documentos/relatorio/viterbi/states.pdf

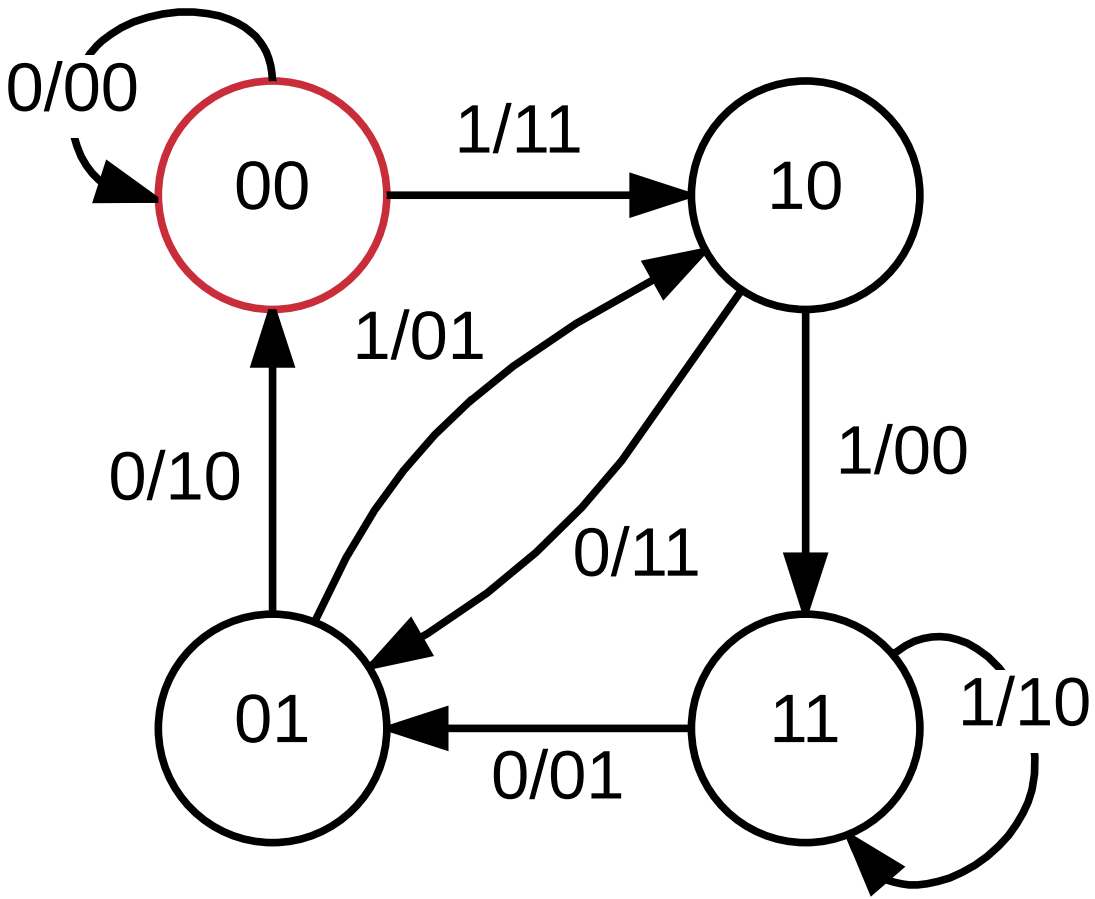
[picture p92: page 1]
