Vivianki/LiCy/Documentos/relatorio/frame/rs-codeword.pdf

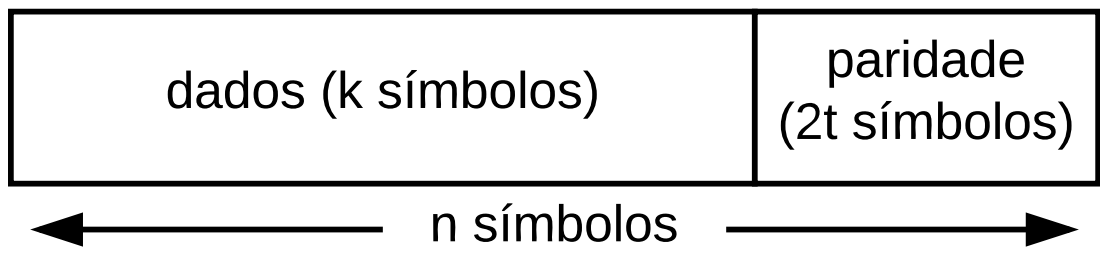
[picture p93: page 1]
dados (k símbolos); paridade; (2t símbolos); n símbolos
