Vivianki/LiCy/Documentos/relatorio/frame/SHR.pdf

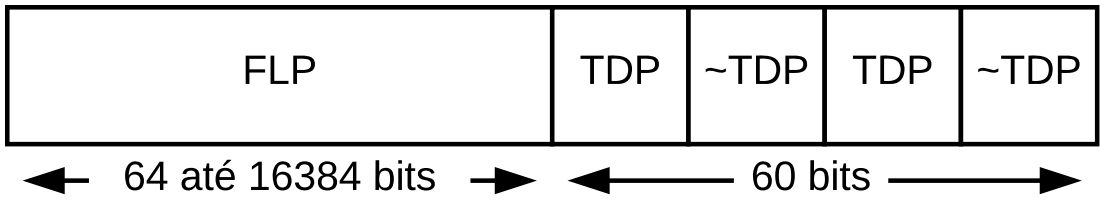
[picture p94: page 1]
FLP; TDP; ~TDP; 64 até 16384 bits; 60 bits
