Vivianki/LiCy/Documentos/relatorio/circuits/comparator_amp.pdf

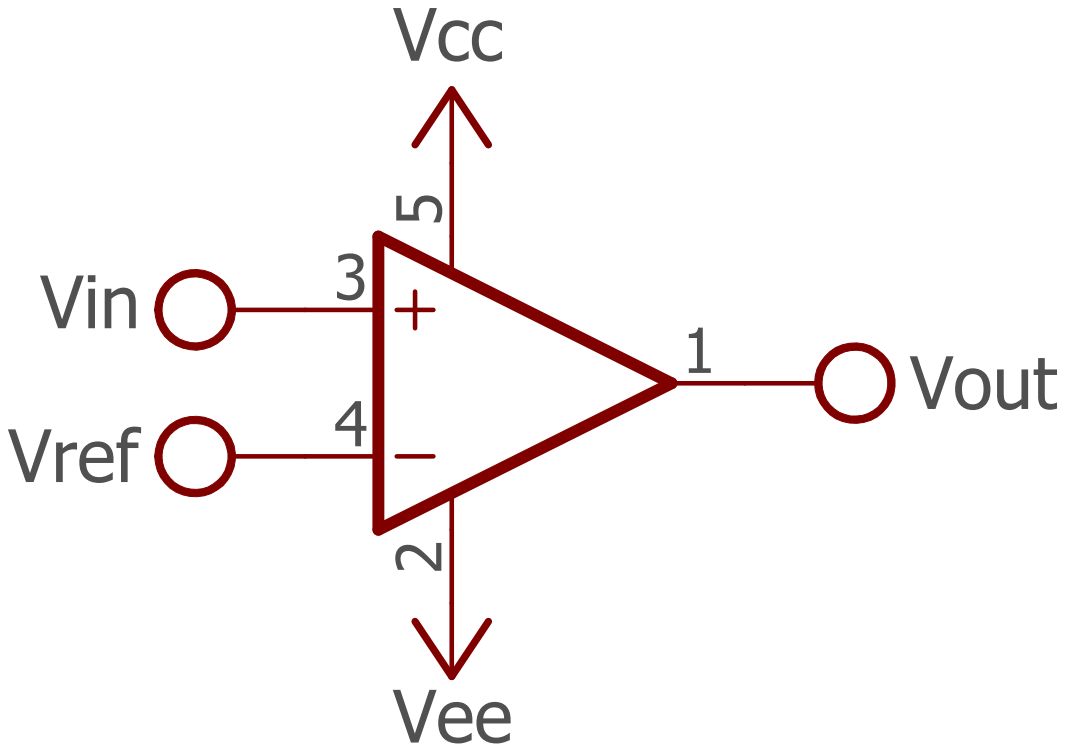
[picture p95: page 1]
Vcc; Vout; Vee; Vin; Vref
