Vivianki/LiCy/Documentos/relatorio/circuits/common_source.pdf

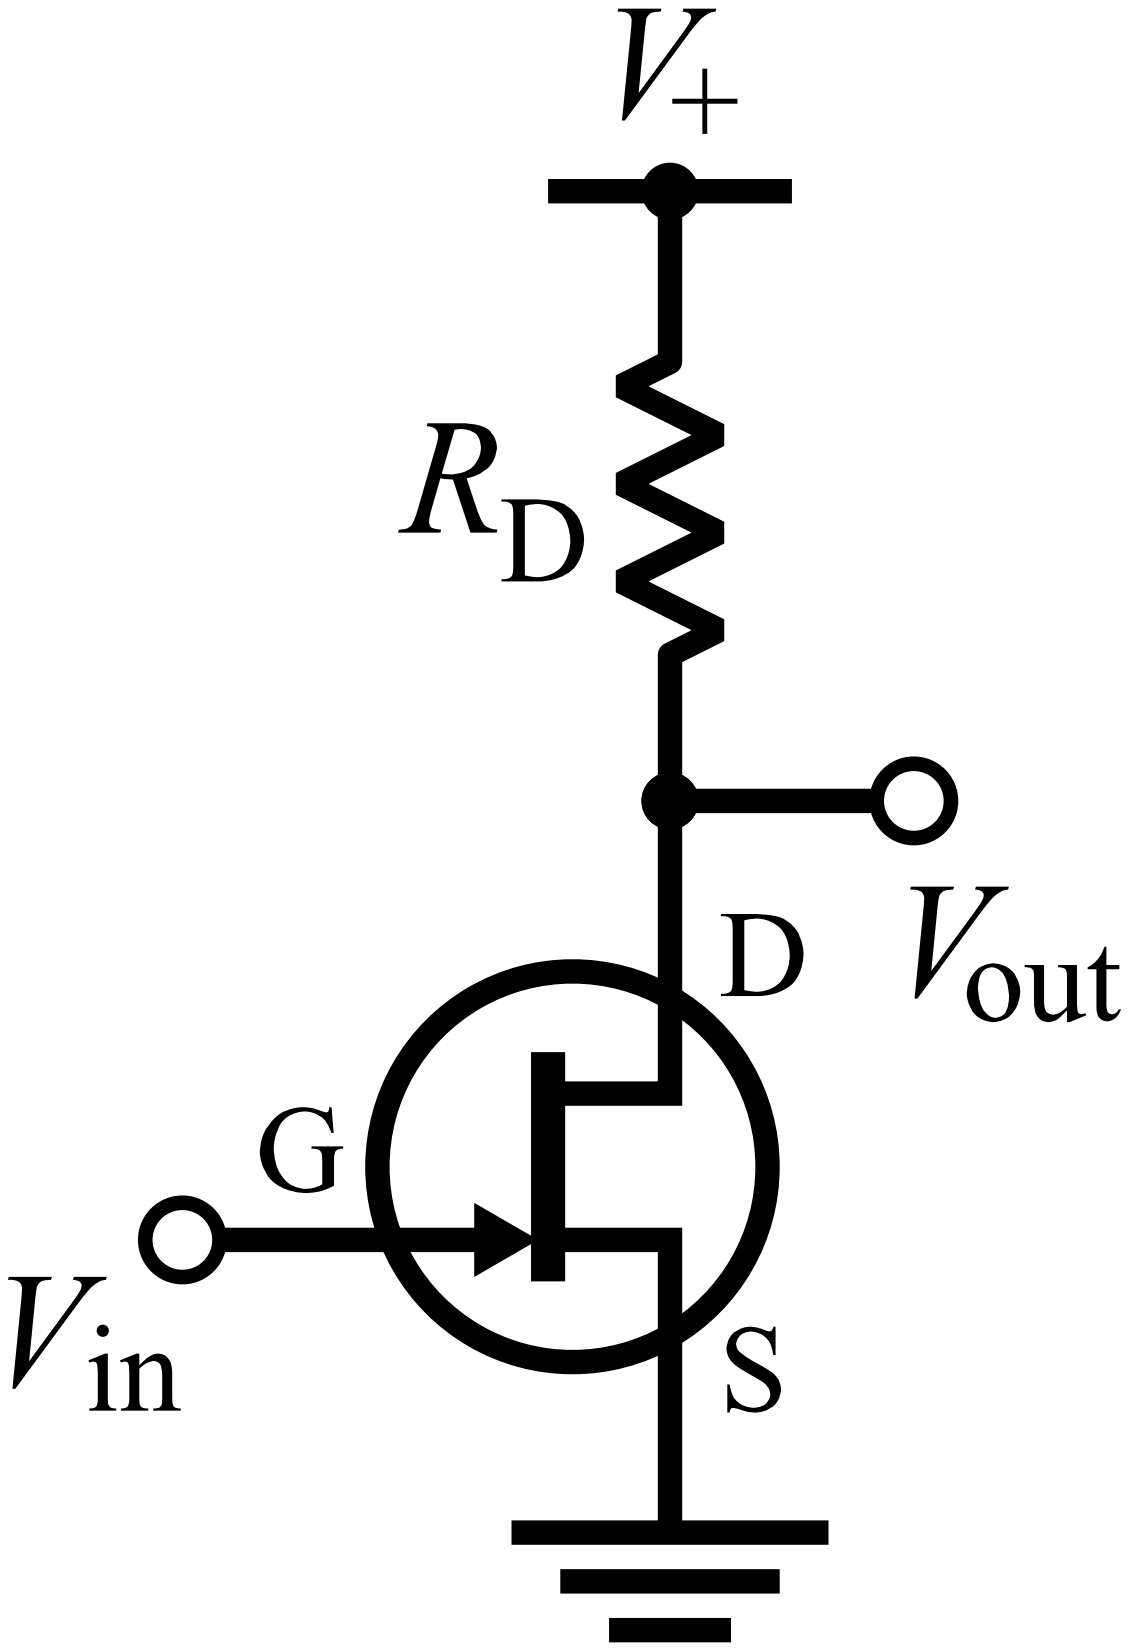
[picture p96: page 1]
