Vivianki/LiCy/(list of files, drawings)

Other design files:
Circuits/Multisim Simulations/comparator.ms14
Circuits/Multisim Simulations/receiver-licy2.ms14
Circuits/Multisim Simulations/receiver-licy3.ms14
Circuits/Multisim Simulations/receiver-licy.ms14
