Vivianki/LiCy/Circuits/Eagle Circuits/transmitter_lify.brd

## EAGLE design Circuits/Eagle Circuits/transmitter_lify.brd (2016-11-12)

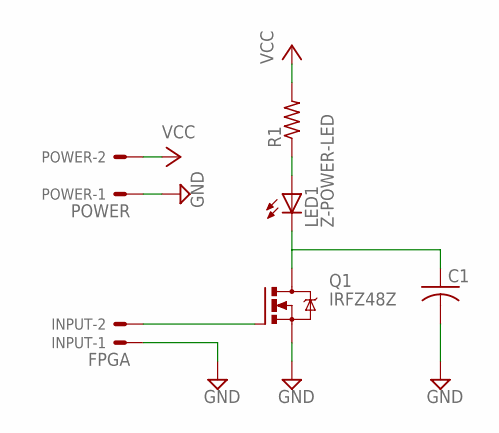
[picture p97: schematic transmitter_lify.sch]

Parts:
C1: C-US050-030X075; C050-030X075
INPUT: FPGA; 22-23-2021
LED1: Z-POWER-LED; Z-POWER-LED-PCB-TYPE
POWER: POWER; 22-23-2021
Q1: IRFZ48Z; TO220BH
R1: R-US_0411/12; 0411/12

Connections:
GND: C1.2, INPUT.1, POWER.1, Q1.S
unnamed: C1.1, LED1.C, Q1.D
unnamed: LED1.A, R1.1
unnamed: INPUT.2, Q1.G
VCC: POWER.2, R1.2

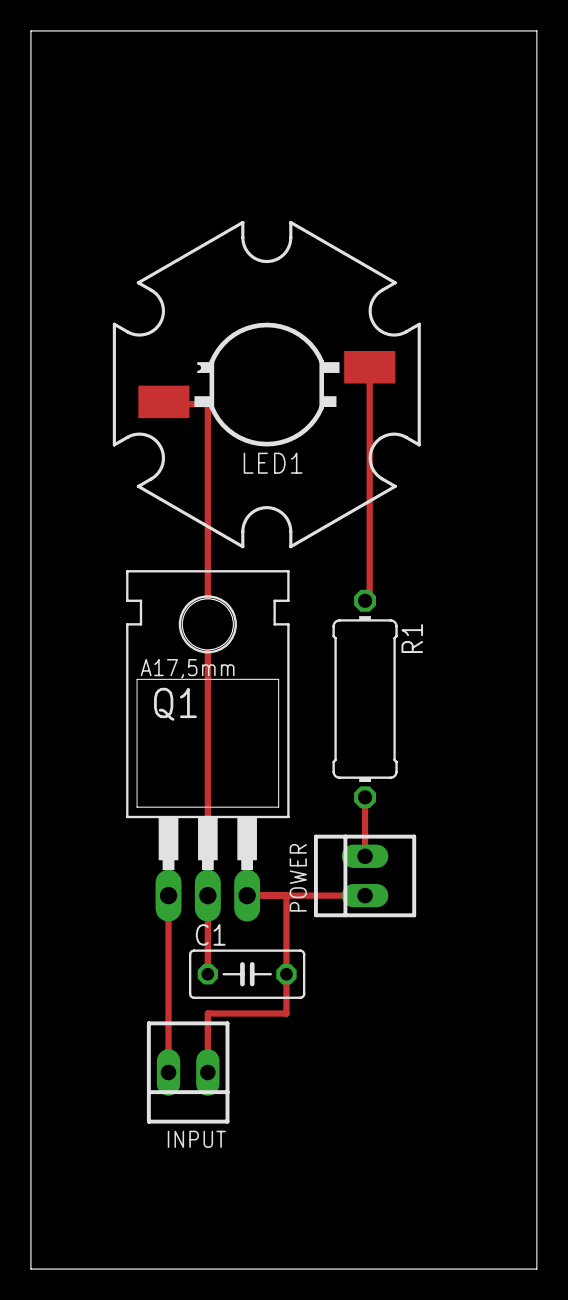
[picture p98: board transmitter_lify.brd from above]

Board: 2 copper layers, 32.7 x 80.0 mm, 6 parts (0 on the bottom side), 5 nets.
