Vivianki/LiCy/Circuits/Eagle Circuits/receiver_lify.brd

## EAGLE design Circuits/Eagle Circuits/receiver_lify.brd (2016-11-12)

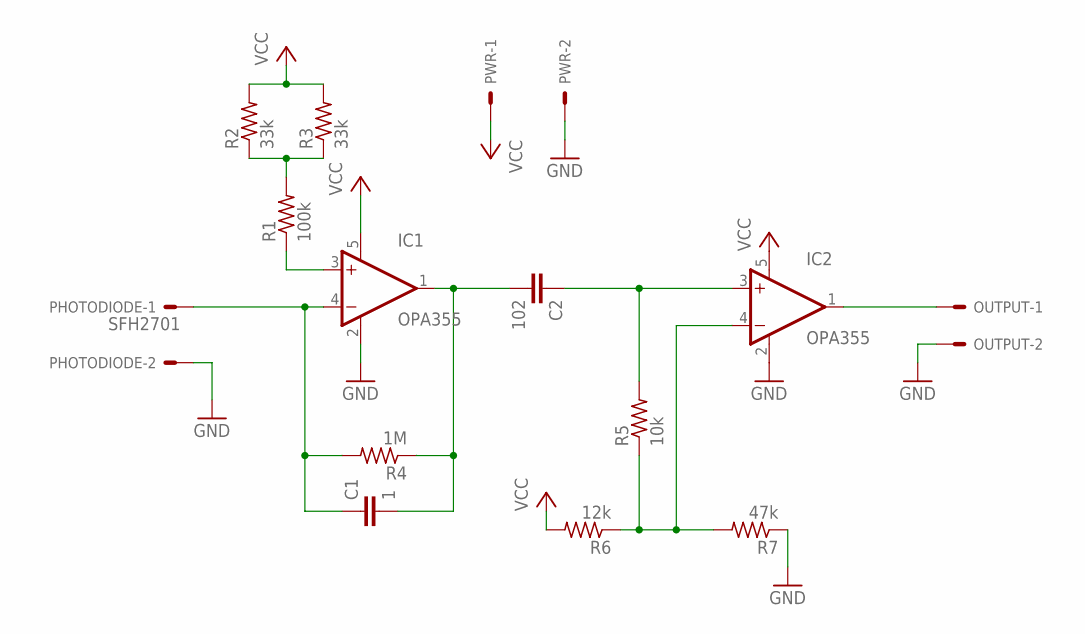
[picture p99: schematic receiver_lify.sch]

Parts:
C1: 1; C050-025X075
C2: 102; C050-025X075
IC1, IC2: OPA355; SOT23-5
OUTPUT: 22-23-2021
PHOTODIODE: SFH2701; 22-23-2021
PWR: 22-23-2021
R1: 100k; 0204/7
R2, R3: 33k; 0204/7
R4: 1M; 0204/7
R5: 10k; 0204/7
R6: 12k; 0204/7
R7: 47k; 0204/7

Connections:
GND: IC1.2 (V-), IC2.2 (V-), OUTPUT.2, PHOTODIODE.2, PWR.2, R7.1
unnamed: C1.1, IC1.4 (-IN), PHOTODIODE.1, R4.2
unnamed: IC1.3 (+IN), R1.1
unnamed: R1.2, R2.1, R3.1
unnamed: C1.2, C2.2, IC1.1 (OUT), R4.1
unnamed: IC2.4 (-IN), R5.1, R6.1, R7.2
unnamed: C2.1, IC2.3 (+IN), R5.2
unnamed: IC2.1 (OUT), OUTPUT.1
VCC: IC1.5 (V+), IC2.5 (V+), PWR.1, R2.2, R3.2, R6.2

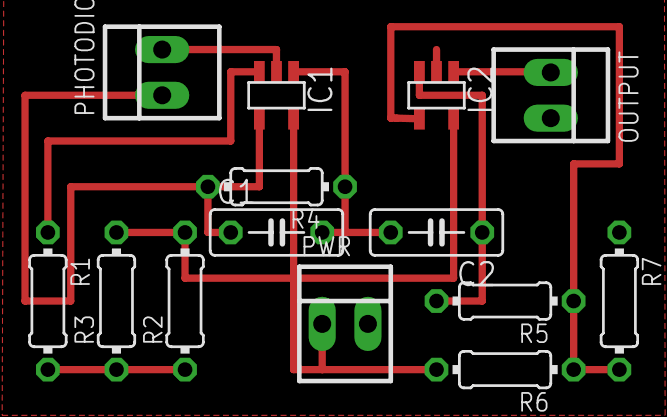
[picture p100: board receiver_lify.brd from above]

Board: 2 copper layers, 14 parts (0 on the bottom side), 9 nets.
