Vivianki/LiCy/Circuits/Eagle Circuits/smd-to-breadboard.brd

## EAGLE design Circuits/Eagle Circuits/smd-to-breadboard.brd (2016-11-12)

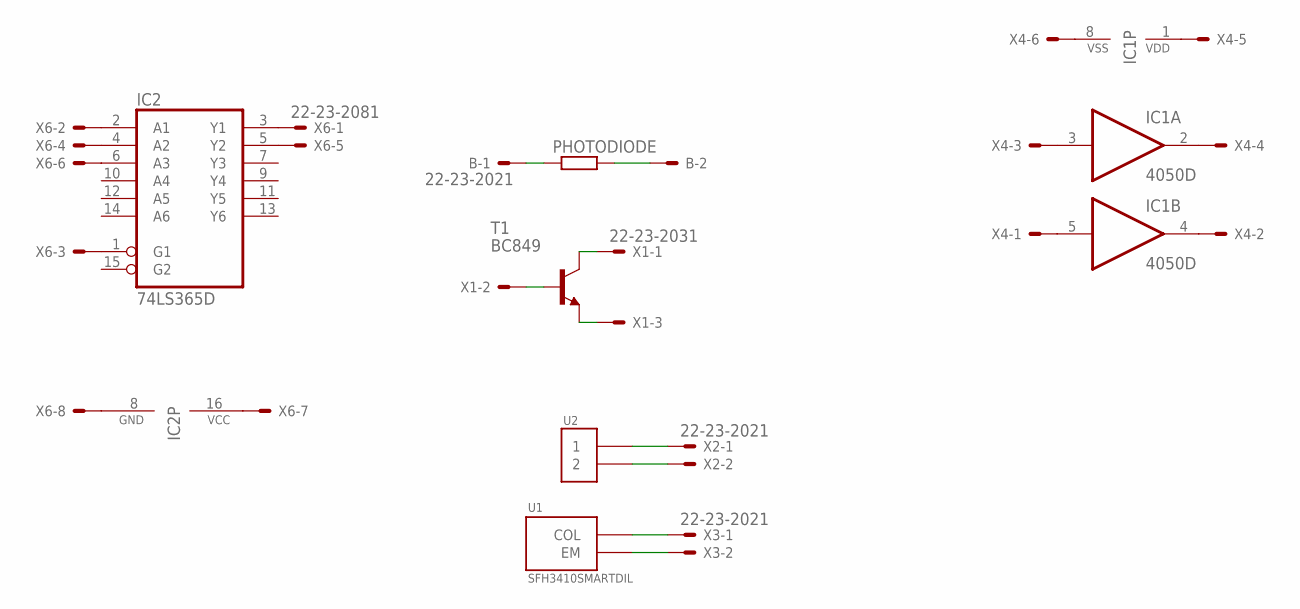
[picture p101: schematic smd-to-breadboard.sch]

Parts:
B: 22-23-2021
IC1: 4050D; SO16
IC2: 74LS365D; SO16
PHOTODIODE: RR1206; R1206
T1: BC849; SOT23
U1: SFH3410SMARTDIL; SFH3410
U2: LUW-W5AMGULLWING; LUW-W5AM
X1: 22-23-2031
X2, X3: 22-23-2021
X4: 22-23-2061
X6: 22-23-2081

Connections:
unnamed: B.1, PHOTODIODE.1
unnamed: B.2, PHOTODIODE.2
unnamed: T1.3 (C), X1.1
unnamed: T1.1 (B), X1.2
unnamed: T1.2 (E), X1.3
unnamed: U2.1, X2.1
unnamed: U2.2, X2.2
unnamed: U1.1 (COL), X3.1
unnamed: U1.2 (EM), X3.2
unnamed: IC1.5 (I), X4.1
unnamed: IC1.3 (I), X4.3
unnamed: IC1.2 (O), X4.4
unnamed: IC1.4 (O), X4.2
unnamed: IC2.3 (Y1), X6.1
unnamed: IC2.2 (A1), X6.2
unnamed: IC2.1 (G1), X6.3
unnamed: IC2.16 (VCC), X6.7
unnamed: IC2.8 (GND), X6.8
unnamed: IC1.8 (VSS), X4.6
unnamed: IC1.1 (VDD), X4.5
unnamed: IC2.4 (A2), X6.4
unnamed: IC2.5 (Y2), X6.5
unnamed: IC2.6 (A3), X6.6

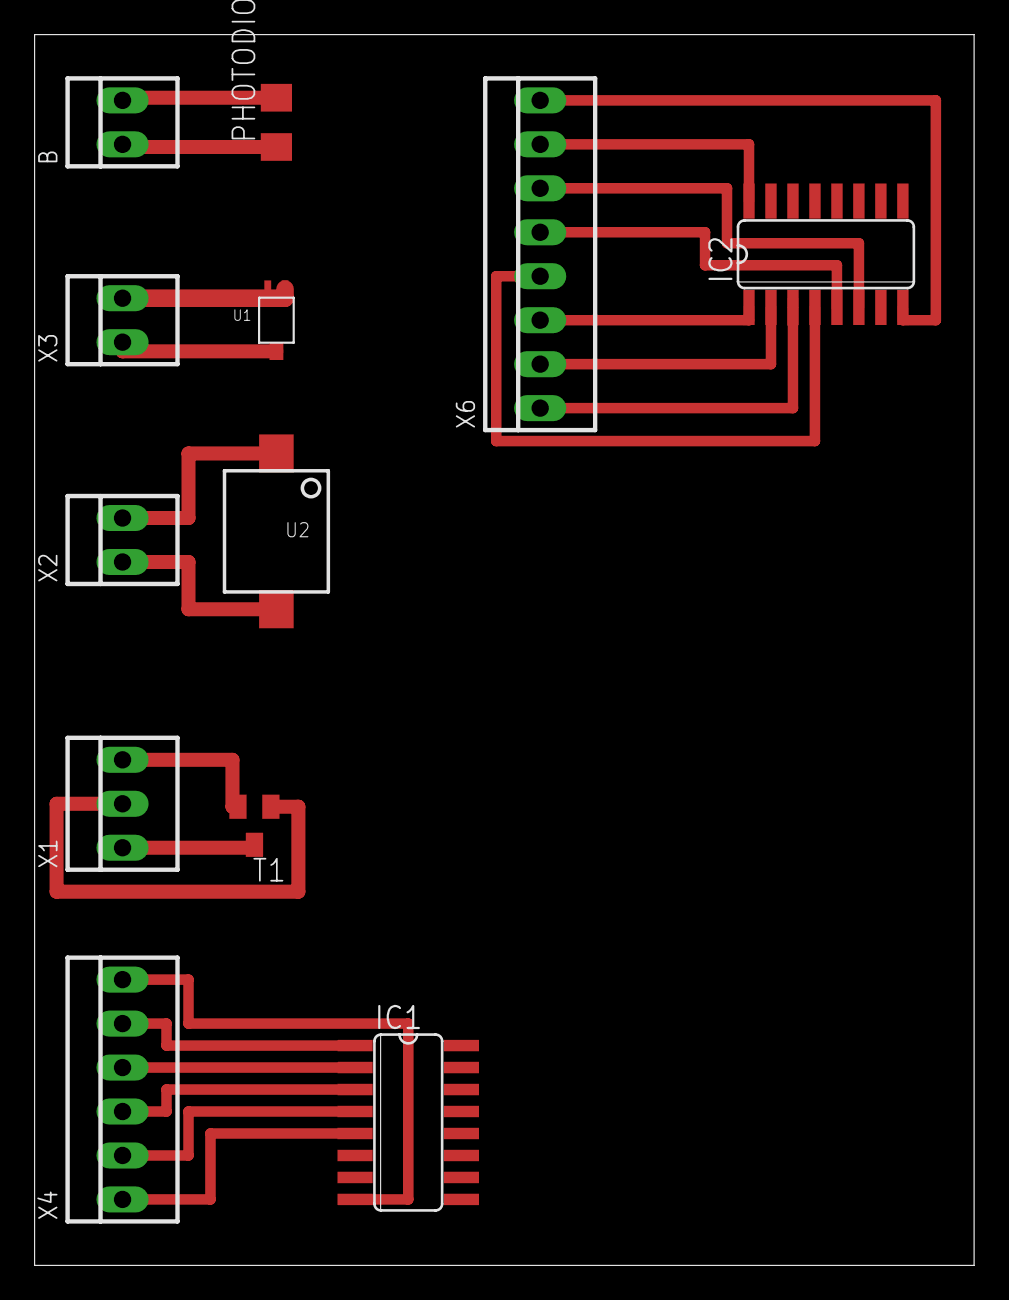
[picture p102: board smd-to-breadboard.brd from above]

Board: 2 copper layers, 54.3 x 71.1 mm, 12 parts (0 on the bottom side), 23 nets.
