Vivianki/LiCy/Circuits/Eagle Circuits/smd-to-breadboard2.brd

## EAGLE design Circuits/Eagle Circuits/smd-to-breadboard2.brd (2016-11-12)

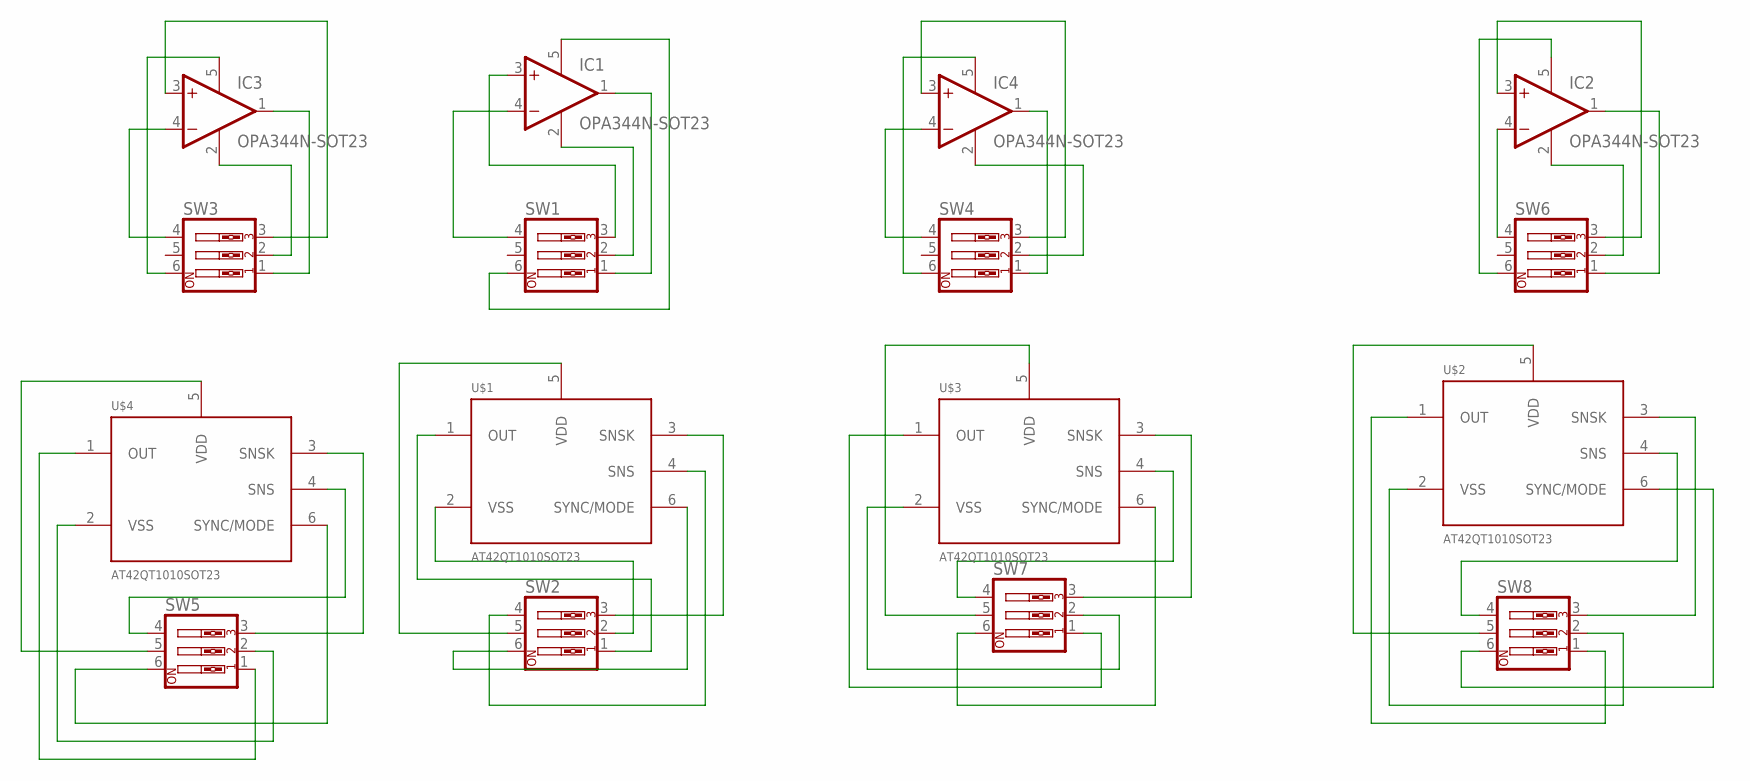
[picture p103: schematic smd-to-breadboard2.sch]

Parts:
IC1, IC2, IC3, IC4: OPA344N-SOT23; SOT23-5
SW1, SW2, SW3, SW4, SW5, SW6, SW7, SW8: SW_DIP-3; EDG-03
U$1, U$2, U$3, U$4: AT42QT1010SOT23; SOT23-6

Connections:
unnamed: IC3.1 (OUT), SW3.1
unnamed: IC3.2 (V-), SW3.2
unnamed: IC3.3 (+IN), SW3.3
unnamed: IC3.5 (V+), SW3.6
unnamed: IC3.4 (-IN), SW3.4
unnamed: IC4.3 (+IN), SW4.3
unnamed: IC4.5 (V+), SW4.6
unnamed: IC4.4 (-IN), SW4.4
unnamed: IC4.1 (OUT), SW4.1
unnamed: IC1.1 (OUT), SW1.1
unnamed: IC1.2 (V-), SW1.2
unnamed: IC1.5 (V+), SW1.6
unnamed: IC1.3 (+IN), SW1.3
unnamed: IC1.4 (-IN), SW1.4
unnamed: SW2.1, U$1.1 (OUT)
unnamed: SW2.6, U$1.6 (SYNC/MODE)
unnamed: SW2.2, U$1.2 (VSS)
unnamed: SW2.4, U$1.4 (SNS)
unnamed: SW2.5, U$1.5 (VDD)
unnamed: SW2.3, U$1.3 (SNSK)
unnamed: IC4.2 (V-), SW4.2
unnamed: IC2.4 (-IN), SW6.4
unnamed: IC2.5 (V+), SW6.6
unnamed: IC2.3 (+IN), SW6.3
unnamed: IC2.1 (OUT), SW6.1
unnamed: IC2.2 (V-), SW6.2
unnamed: SW5.1, U$4.1 (OUT)
unnamed: SW5.2, U$4.2 (VSS)
unnamed: SW5.5, U$4.5 (VDD)
unnamed: SW5.6, U$4.6 (SYNC/MODE)
unnamed: SW5.4, U$4.4 (SNS)
unnamed: SW5.3, U$4.3 (SNSK)
unnamed: SW7.1, U$3.1 (OUT)
unnamed: SW7.2, U$3.2 (VSS)
unnamed: SW7.6, U$3.6 (SYNC/MODE)
unnamed: SW7.5, U$3.5 (VDD)
unnamed: SW7.4, U$3.4 (SNS)
unnamed: SW7.3, U$3.3 (SNSK)
unnamed: SW8.1, U$2.1 (OUT)
unnamed: SW8.2, U$2.2 (VSS)
unnamed: SW8.3, U$2.3 (SNSK)
unnamed: SW8.4, U$2.4 (SNS)
unnamed: SW8.5, U$2.5 (VDD)
unnamed: SW8.6, U$2.6 (SYNC/MODE)

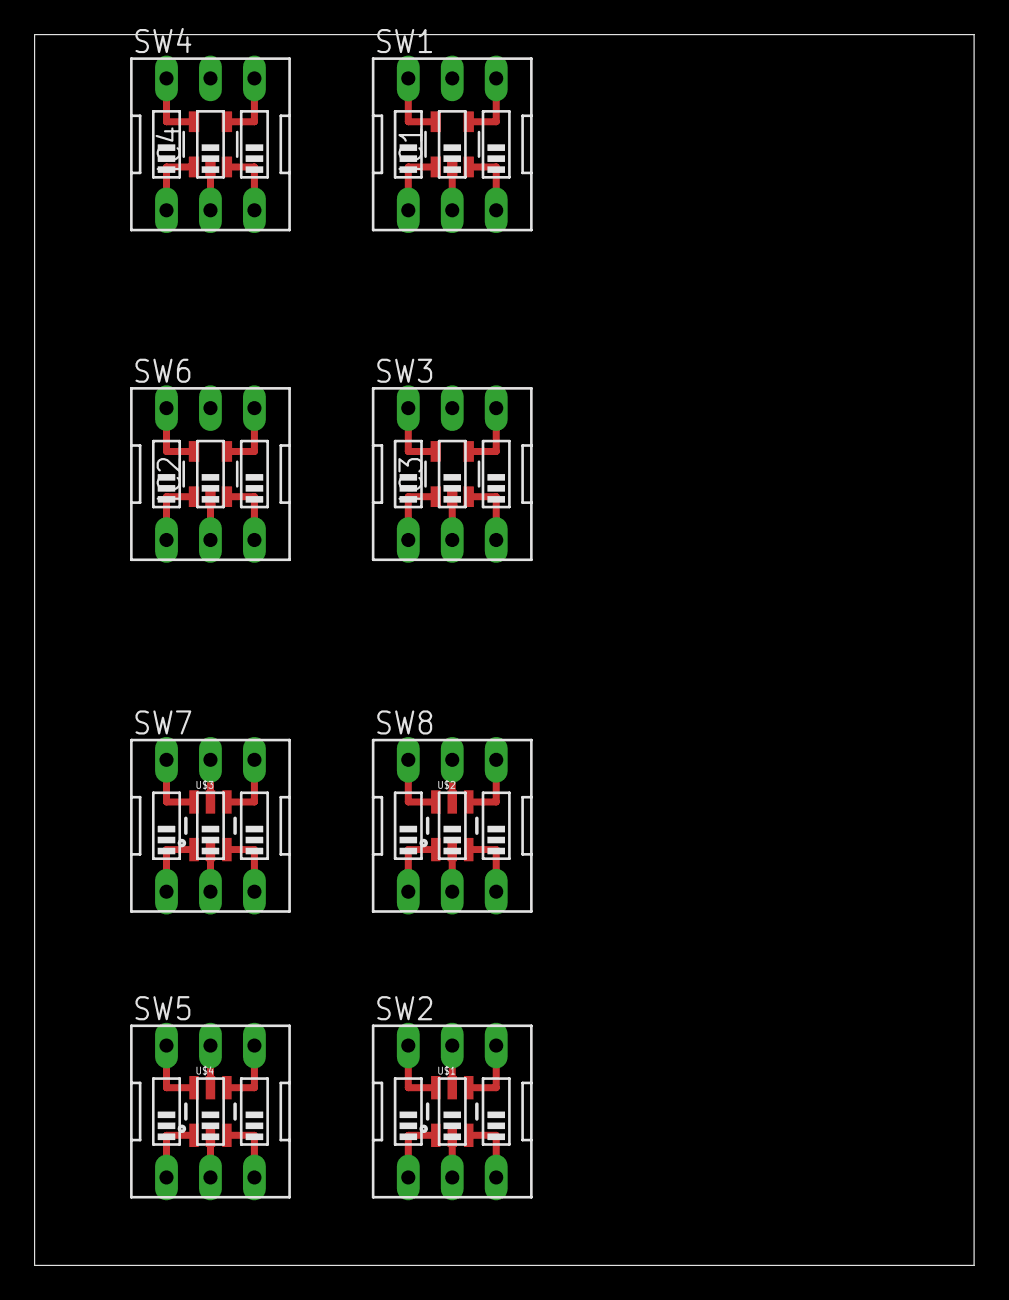
[picture p104: board smd-to-breadboard2.brd from above]

Board: 2 copper layers, 54.3 x 71.1 mm, 16 parts (0 on the bottom side), 44 nets.
