Vivianki/LiCy/VHDL/Encoder/convolutional/trellisTable.vhd

library ieee;
use ieee.std_logic_1164.all;
use ieee.numeric_std.all;

entity trellisTable is
    port (
		  estado_atual : in std_logic_vector(5 downto 0);
		  prox_estado0 : out std_logic_vector(5 downto 0);
		  prox_estado1 : out std_logic_vector(5 downto 0);
		  output_esperado0 : out std_logic_vector(2 downto 0);
		  output_esperado1 : out std_logic_vector(2 downto 0)
    );
end entity;

architecture lut of trellisTable is
begin
	process (estado_atual) is begin
if (estado_atual = "000000") then
	prox_estado0 <= "000000";
	prox_estado1 <=  "100000";
	output_esperado0 <=  "000";
	output_esperado1	<= "111";
elsif (estado_atual = "000001") then
	prox_estado0 <= "000000";
	prox_estado1 <=  "100000";
	output_esperado0 <=  "111";
	output_esperado1	<= "000";
elsif (estado_atual = "000010") then
	prox_estado0 <= "000001";
	prox_estado1 <=  "100001";
	output_esperado0 <=  "100";
	output_esperado1	<= "011";
elsif (estado_atual = "000011") then
	prox_estado0 <= "000001";
	prox_estado1 <=  "100001";
	output_esperado0 <=  "011";
	output_esperado1	<= "100";
elsif (estado_atual = "000100") then
	prox_estado0 <= "000010";
	prox_estado1 <=  "100010";
	output_esperado0 <=  "001";
	output_esperado1	<= "110";
elsif (estado_atual = "000101") then
	prox_estado0 <= "000010";
	prox_estado1 <=  "100010";
	output_esperado0 <=  "110";
	output_esperado1	<= "001";
elsif (estado_atual = "000110") then
	prox_estado0 <= "000011";
	prox_estado1 <=  "100011";
	output_esperado0 <=  "101";
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
	prox_estado0 <= "011111";
	prox_estado1 <=  "111111";
	output_esperado0 <=  "000";
	output_esperado1	<= "111";
else 
	prox_estado0 <= "000000";
	prox_estado1 <=  "100000";
	output_esperado0 <=  "000";
	output_esperado1	<= "111";
 	end if;
   end process;
end architecture; 
