Vivianki/LiCy/VHDL/Encoder/Vhdl1.vhd

library ieee;
use ieee.std_logic_1164.all;

entity ROM_header is
  port ( address : in std_logic_vector(7 downto 0);
         data : out std_logic;
			);
end entity ROM_header;

architecture behavioral of ROM_header is
  type mem is array ( 0 to 155) of std_logic;
  constant my_Rom : mem := (
		0 => '0',
		1 => '0',
		2 => '0',
		3 => '0',
		4 => '0',
		5 => '0',
		6 => '0',
		7 => '0',
		8 => '0',
		9 => '0',
		10 => '0',
		11 => '0',
		12 => '0',
		13 => '0',
		14 => '1',
		15 => '0',
		16 => '1',
		17 => '0',
		18 => '1',
		19 => '0',
		20 => '1',
		21 => '0',
		22 => '1',
		23 => '0',
		24 => '1',
		25 => '0',
		26 => '1',
		27 => '0',
		28 => '1',
		29 => '0',
		30 => '1',
		31 => '0',
		32 => '1',
		33 => '0',
		34 => '1',
		35 => '0',
		36 => '1',
		37 => '0',
		38 => '1',
		39 => '0',
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
begin
   process (address)
   begin
     case address is
		when "00000000" => data <= my_rom(0);
		when "00000001" => data <= my_rom(1);
		when "00000010" => data <= my_rom(2);
		when "00000011" => data <= my_rom(3);
		when "00000100" => data <= my_rom(4);
		when "00000101" => data <= my_rom(5);
		when "00000110" => data <= my_rom(6);
		when "00000111" => data <= my_rom(7);
		when "00001000" => data <= my_rom(8);
		when "00001001" => data <= my_rom(9);
		when "00001010" => data <= my_rom(10);
		when "00001011" => data <= my_rom(11);
		when "00001100" => data <= my_rom(12);
		when "00001101" => data <= my_rom(13);
		when "00001110" => data <= my_rom(14);
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
		when "10011000" => data <= my_rom(152);
		when "10011001" => data <= my_rom(153);
		when "10011010" => data <= my_rom(154);
		when "10011011" => data <= my_rom(155);
      when others => data <= '0';
	 end case;
  end process;
end architecture behavioral;
