Vivianki/LiCy/VHDL/Encoder/Sync/clock_generator.vhd

library ieee;
use IEEE.std_logic_1164.all;

entity clock_generator is
port (clk : in std_logic;
      reset : in std_logic;
      input : in std_logic;
      flp : in std_logic;
		reset_shift_regs: out std_logic;

      output : out std_logic
  );
end clock_generator ;

architecture behavioral of clock_generator is

type state_type is (s0,s1,s2,s3, s4, s5);  --type of state machine.
signal current_s: state_type := s0;
signal next_s: state_type;  --current and next state declaration.
signal temp: integer := 0;
begin

process (clk,reset)
  begin
    if (reset='1') then
      current_s <= s0;  --default state on reset.
    elsif (rising_edge(clk)) then
      current_s <= next_s;   --state change.
    end if;
end process;

--state machine process.
process (current_s, flp)
begin
  case current_s is
    when s0 =>        --when current state is "s0"
		
      if(input ='1' and flp = '1') then
        output <= '0';
	     temp <= 0;
		  reset_shift_regs <= '0';
        next_s <= s4;
		  
      elsif (temp = 10) then
		  temp <= 0;
        output <= '1';
		  reset_shift_regs <= '0';
        next_s <= s1;
		  
	   else
	     output <= '0';
	     temp <= temp + 1;
		  reset_shift_regs <= '0';
        next_s <= s2;
      end if;   
    when s1 =>       --when current state is "s1"

      if(input ='1' and flp = '1') then
        output <= '0';
	     temp <= 0;
		  reset_shift_regs <= '0';
        next_s <= s4;
      elsif (temp = 10) then
		  temp <= 0;
        output <= '1';
		  reset_shift_regs <= '0';
        next_s <= s0;
	   else
	     output <= '0';
	     temp <= temp + 1;
		  reset_shift_regs <= '0';
        next_s <= s3;	
      end if;
		
	    when s2 =>       --when current state is "s1"

      if(input ='1' and flp = '1') then
        output <= '0';
	     temp <= 0;
		  reset_shift_regs <= '0';
        next_s <= s4;
      elsif (temp = 10) then
		  temp <= 0;
        output <= '1';
		  reset_shift_regs <= '0';
        next_s <= s1;
	   else
	     output <= '0';
	     temp <= temp + 1;
		  reset_shift_regs <= '0';
        next_s <= s0;	
      end if;
		
	    when s3 =>       --when current state is "s1"

      if(input ='1' and flp = '1') then
        output <= '0';
	     temp <= 0;
		  reset_shift_regs <= '0';
        next_s <= s4;
      elsif (temp = 10) then
		  temp <= 0;
        output <= '1';
		  reset_shift_regs <= '0';
        next_s <= s0;
	   else
	     output <= '0';
	     temp <= temp + 1;
		  reset_shift_regs <= '0';
        next_s <= s1;	
      end if;
	when s4 =>       --when current state is "s1"

			if (temp = 5) then
			output <= '1';
			temp <= 0;
			reset_shift_regs <= '0';
			next_s <= s1;
			else 
			reset_shift_regs <= '1';
	     output <= '0';
	     temp <= temp + 1;
        next_s <= s5;	
			end if;
		when s5 =>       --when current state is "s1"
			if (temp = 5) then
			output <= '1';
			temp <= 0;
			reset_shift_regs <= '0';
			next_s <= s1;
			else 
			reset_shift_regs <= '1';
	     output <= '0';
	     temp <= temp + 1;
        next_s <= s4;	
			end if;
    end case;
	 
	 
end process;

end behavioral;
