Vivianki/LiCy/VHDL/Encoder/Sync/shiftreg64.vhd

library IEEE;
use IEEE.STD_LOGIC_1164.ALL;
use IEEE.STD_LOGIC_UNSIGNED.ALL;

entity shift_register_top is
    Port ( CLK : in  STD_LOGIC;
           D   : in  STD_LOGIC;
			  Reset_64b   : in  STD_LOGIC;
           shift_regiters_values : out STD_LOGIC_VECTOR(63 downto 0));
end shift_register_top;
    
architecture Behavioral of shift_register_top is
    signal shift_reg : STD_LOGIC_VECTOR(63 downto 0) := "0000000000000000000000000000000000000000000000000000000000000000";
begin
    -- shift register
    process (CLK, Reset_64b)
    begin
	    if (Reset_64b = '1') then
			shift_reg <= "0000000000000000000000000000000000000000000000000000000000000000";
		elsif (CLK'event and CLK = '1') then
					shift_reg(63) <= shift_reg(62);
					shift_reg(62) <= shift_reg(61);
					shift_reg(61) <= shift_reg(60);
					shift_reg(60) <= shift_reg(59);
					shift_reg(59) <= shift_reg(58);
					shift_reg(58) <= shift_reg(57);
					shift_reg(57) <= shift_reg(56);
					shift_reg(56) <= shift_reg(55);
					shift_reg(55) <= shift_reg(54);
					shift_reg(54) <= shift_reg(53);
					shift_reg(53) <= shift_reg(52);
					shift_reg(52) <= shift_reg(51);
					shift_reg(51) <= shift_reg(50);
					shift_reg(50) <= shift_reg(49);
					shift_reg(49) <= shift_reg(48);
					shift_reg(48) <= shift_reg(47);
					shift_reg(47) <= shift_reg(46);
					shift_reg(46) <= shift_reg(45);
					shift_reg(45) <= shift_reg(44);
					shift_reg(44) <= shift_reg(43);
					shift_reg(43) <= shift_reg(42);
					shift_reg(42) <= shift_reg(41);
					shift_reg(41) <= shift_reg(40);
					shift_reg(40) <= shift_reg(39);
					shift_reg(39) <= shift_reg(38);
					shift_reg(38) <= shift_reg(37);
					shift_reg(37) <= shift_reg(36);
					shift_reg(36) <= shift_reg(35);
					shift_reg(35) <= shift_reg(34);
					shift_reg(34) <= shift_reg(33);
					shift_reg(33) <= shift_reg(32);
					shift_reg(32) <= shift_reg(31);
					shift_reg(31) <= shift_reg(30);
					shift_reg(30) <= shift_reg(29);
					shift_reg(29) <= shift_reg(28);
					shift_reg(28) <= shift_reg(27);
					shift_reg(27) <= shift_reg(26);
					shift_reg(26) <= shift_reg(25);
					shift_reg(25) <= shift_reg(24);
					shift_reg(24) <= shift_reg(23);
					shift_reg(23) <= shift_reg(22);
					shift_reg(22) <= shift_reg(21);
					shift_reg(21) <= shift_reg(20);
					shift_reg(20) <= shift_reg(19);
					shift_reg(19) <= shift_reg(18);
					shift_reg(18) <= shift_reg(17);
					shift_reg(17) <= shift_reg(16);
					shift_reg(16) <= shift_reg(15);
					shift_reg(15) <= shift_reg(14);
					shift_reg(14) <= shift_reg(13);
					shift_reg(13) <= shift_reg(12);
					shift_reg(12) <= shift_reg(11);
					shift_reg(11) <= shift_reg(10);
					shift_reg(10) <= shift_reg(9);
					shift_reg(9) <= shift_reg(8);
					shift_reg(8) <= shift_reg(7);
					shift_reg(7) <= shift_reg(6);
					shift_reg(6) <= shift_reg(5);
					shift_reg(5) <= shift_reg(4);
					shift_reg(4) <= shift_reg(3);
					shift_reg(3) <= shift_reg(2);
					shift_reg(2) <= shift_reg(1);
					shift_reg(1) <= shift_reg(0);
					shift_reg(0) <= D;
end if;
    end process;
    shift_regiters_values <= shift_reg;

end Behavioral;
