Vivianki/LiCy/VHDL/all_cycl5/ViterbiDecoder/register1b_viterbi.vhd

library IEEE;
use IEEE.STD_LOGIC_1164.ALL;
use IEEE.STD_LOGIC_UNSIGNED.ALL;


ENTITY register1b_viterbi IS 
PORT( 
d : IN STD_LOGIC; 
clr : IN STD_LOGIC; -- async. clear. 
clk : IN STD_LOGIC; -- clock. 
q : OUT STD_LOGIC);  -- output. 
END register1b_viterbi; 
ARCHITECTURE description OF register1b_viterbi IS 

BEGIN 
process(clk, clr) 
begin 
	if clr = '1' then 
		q<= '0';
	elsif rising_edge(clk) then 
		q <= d; 
	end if; 
end process; 
END description;
