Vivianki/LiCy/VHDL/all_cycl5/Reed Solomon decoder/register4b_decoder.vhd

LIBRARY ieee;
USE ieee.std_logic_1164.ALL;
USE ieee.std_logic_arith.ALL;
USE ieee.std_logic_unsigned.ALL;

ENTITY register4b_decoder IS PORT(
    d   : IN STD_LOGIC_VECTOR(3 DOWNTO 0);
    ld  : IN STD_LOGIC; -- load/enable.
    clr : IN STD_LOGIC; -- async. clear.
    clk : IN STD_LOGIC; -- clock.
    q   : OUT STD_LOGIC_VECTOR(3 DOWNTO 0) -- output
);
END register4b_decoder;

ARCHITECTURE description OF register4b_decoder IS

BEGIN
    process(clk, clr)
    begin
        if clr = '1' then
            q <= "0000";
        elsif rising_edge(clk) then
            if ld = '1' then
                q <= d;
            end if;
        end if;
    end process;
END description;
