Vivianki/LiCy/VHDL/all_cycl5/Reed Solomon decoder/static_4_decoder.vhd

-- Design unit header --
library IEEE;
use IEEE.std_logic_1164.all;
use ieee.numeric_std.all;


entity static_4_decoder is
  port(

       o : out std_logic_vector(3 downto 0)
  );
end static_4_decoder;

architecture behavior of static_4_decoder is

begin
 
 o <= "0100";

end behavior;
