Vivianki/LiCy/VHDL/all_cycl5/Reed Solomon decoder/Syn8x4.vhd

library IEEE;
use IEEE.STD_LOGIC_1164.ALL;

entity Syn8x4 is
       Port ( 		reset, clk, start, load : in STD_LOGIC;
                  Sin0, Sin1, Sin2, Sin3, Sin4, Sin5, Sin6, Sin7 : in STD_LOGIC_VECTOR (3 downto 0);
                  S_out:out STD_LOGIC_VECTOR (3 downto 0);
						error: out STD_LOGIC
		);
end Syn8x4;

architecture Behavioral of Syn8x4 is
      signal Syndrome :STD_LOGIC_VECTOR (31 downto 0) := (others => '0');
      signal DATA:STD_LOGIC_VECTOR (3 downto 0) := (others => '0');
begin
      process(reset, clk, start, load)
      begin
           if reset='1' then
                  Syndrome <= (others=>'0');
						DATA <= "0000";
           elsif rising_edge(clk) then
                 if start = '1' then
						    DATA <= Sin0;
							 Syndrome <= Sin7&Sin6&Sin5&Sin4&Sin3&Sin2&Sin1&Sin0;
                 else
							 if load = '1' then
							   DATA <= Syndrome(7 downto 4);
							   Syndrome <= Syndrome(3 downto 0)&Syndrome(31 downto 4);
							 else
								DATA <= Syndrome(3 downto 0);
							 end if;
					  end if;
           end if;
     end process;
     S_out <= DATA;
	  error <= Syndrome(0) OR Syndrome(1) OR Syndrome(2) OR Syndrome(3) OR Syndrome(4) OR Syndrome(5) OR Syndrome(6) OR Syndrome(7) OR Syndrome(8) OR Syndrome(9) OR Syndrome(10) OR Syndrome(11) OR Syndrome(12) OR Syndrome(13) OR Syndrome(14) OR Syndrome(15) OR Syndrome(16) OR Syndrome(17) OR Syndrome(18) OR Syndrome(19) OR Syndrome(20) OR Syndrome(21) OR Syndrome(22) OR Syndrome(23) OR Syndrome(24) OR Syndrome(25) OR Syndrome(26) OR Syndrome(27) OR Syndrome(28) OR Syndrome(29) OR Syndrome(30) OR Syndrome(31); 
end Behavioral;
