Vivianki/LiCy/VHDL/convolutional/mux2x1.vhd

library IEEE;
use IEEE.STD_LOGIC_1164.ALL;

entity mux2x1 is
    Port ( SEL : in  STD_LOGIC;
           A   : in  STD_LOGIC;
           B   : in  STD_LOGIC;
           X   : out STD_LOGIC
			 );
end mux2x1;

architecture behv of mux2x1 is
begin
    X <= A when (SEL = '1') else B;
end behv;
