Vivianki/LiCy/VHDL/Encoder/interleaver_rev2/counter_standard.vhd

	
library ieee ;
use ieee.std_logic_1164.all;
use ieee.std_logic_unsigned.all;

----------------------------------------------------

entity counter_interleaver is

port(	clock:	in std_logic;
	clear:	in std_logic;
	count:	out std_logic_vector(5 downto 0);
	carry:	out std_logic
);
end counter_interleaver;

----------------------------------------------------

architecture behv of counter is		 	  
	
    signal Pre_Q: std_logic_vector(5 downto 0);

begin

    -- behavior describe the counter

	process(clock, clear)
	begin
		if clear = '1' then
			Pre_Q <= "000000";
			carry <= '0';
		elsif (clock='1' and clock'event) then
			if Pre_Q <= "011110" then
				Pre_Q <= Pre_Q + 1;
				carry <= '1';
			elsif Pre_Q = "111111" then
				carry <= '0';
			else
				Pre_Q <= "000000";
				carry <= '1';		
			end if;
		end if;
	end process;	

    -- concurrent assignment statement
    count <= Pre_Q;

end behv;

-----------------------------------------------------
