Vivianki/LiCy/VHDL/all_cycl5/Encoder/static_13.vhd

-- Design unit header --
library IEEE;
use IEEE.std_logic_1164.all;
use ieee.numeric_std.all;


entity static_13 is
  port(

       o : out std_logic_vector(3 downto 0)
  );
end static_13;

architecture behavior of static_13 is

begin
 
 o <= "1101";

end behavior;
