Vivianki/LiCy/VHDL/all_cycl5/Encoder/static_4.vhd

-- Design unit header --
library IEEE;
use IEEE.std_logic_1164.all;
use ieee.numeric_std.all;


entity static_4 is
  port(

       o : out std_logic_vector(3 downto 0)
  );
end static_4;

architecture behavior of static_4 is

begin
 
 o <= "0011";

end behavior;
