Vivianki/LiCy/Reed Solomon decoder/static_11.vhd

-- Design unit header --
library IEEE;
use IEEE.std_logic_1164.all;
use ieee.numeric_std.all;


entity static_11 is
  port(

       o : out std_logic_vector(3 downto 0)
  );
end static_11;

architecture behavior of static_11 is

begin
 
 o <= "1011";

end behavior;
