Vivianki/LiCy/Reed Solomon decoder/static_6.vhd

-- Design unit header --
library IEEE;
use IEEE.std_logic_1164.all;
use ieee.numeric_std.all;


entity static_6 is
  port(

       o : out std_logic_vector(3 downto 0)
  );
end static_6;

architecture behavior of static_6 is

begin
 
 o <= "0110";

end behavior;
