Vivianki/LiCy/VHDL/all_cycl5/Encoder/static_3.vhd

-- Design unit header --
library IEEE;
use IEEE.std_logic_1164.all;
use ieee.numeric_std.all;


entity static_3 is
  port(

       o : out std_logic_vector(3 downto 0)
  );
end static_3;

architecture behavior of static_3 is

begin
 
 o <= "0011";

end behavior;
