Vivianki/LiCy/(commit log)

2016-04-26 Added mockup ampop circuit
2016-04-27 FPGA
    Complementando justificativa para escolha da FPGA
2016-04-28 LED
    Details and testing
2016-04-29 Motivação
    seção de motivação com referência ao projeto anterior
2016-04-29 Planejamento
    Inclusão da seção de planejamento e subitens
2016-05-01 OpAmp + Circuit
    [AmpOpDif2.sch]
2016-05-16 RS Encoder logic and testbench
2016-09-09 Atualizações Felippe
    Manchester Decoder, RS Decoder (incompleto), RS enc/dec em JavaScript (
    15, 7 em progresso)
    [ManchesterDec.smp_dump.txt]
2016-09-19 Protótipo Reed Solomon
    Em funcionamento, pronto para geração de entradas e para conferir
    resultados com VHDL.
2016-09-22 Added Interleaver code
    Still trying to figure out how to include ram component into
    interleaver.
    Javascript code is included, where the interleaving process happens at a
    higher level to help understanding.
    [Interleaver.smp_dump.txt]
2016-09-24 Revert "Gitignored?"
    This reverts commit 21132df916af13093f550c58a404dcbdfbc67093.
    [Interleaver.smp_dump.txt]
2016-09-24 Revert "Revert "Gitignored?""
    This reverts commit 3a3e0cbc048d2befd00cba55cc0494af94c73ab0.
    [Interleaver.smp_dump.txt]
2016-09-24 Testbench Berlekamp
    incompleto - by @felippedr
    [RSDecoder.smp_dump.txt]
2016-09-25 Added Arduino Square Wave Generator
    And sync proof as a bonus
2016-09-25 Convolutional Encoder & Viterbi
    Integration and FPGA Testing done!
    @Vivianki
2016-09-25 Deinterleaver workaround
    [Interleaver.smp_dump.txt]
2016-09-25 RS Encoding latches fix
    [RSencoder.vhd, gf_mult.vhd, mch_Decoder.vhd, sinalControle.vhd, static_0.vhd, static_13.vhd, static_14.vhd]
2016-09-28 Interleaver Rev2
    Not working, trying things out
    [address_calculator.vhd, depth_counter.vhd, flush_counter.vhd, interleaver_rev2.vhd, interleaver_shared_memory_inst.vhd, length_register.vhd]
2016-09-29 Interleaver Rev2 Fix
    Still not working, needs more work. work by @Vivianki
    [address_calculator.vhd, flush_counter.vhd, interleaver_rev2.vhd]
2016-10-01 Berlekamp Testbench
    @felippedr @gabrieltnishimura
    [RSDecoder.smp_dump.txt]
2016-10-01 Berlekamp Massey - Testbench
    Funcionando, mas precisa de mais alguns ajustes para integração.
    Verificar questão da borda de descida / subida.
    by @felippedr e @gabrieltnishimura
2016-10-01 Chien Testbench
    Funcionando, mas falta integração.
    [RSDecoder.smp_dump.txt]
2016-10-01 Integração Chien + Forney
    Com testbench. Falta detecção de mais de 4 erros.
    [RSDecoder.smp_dump.txt]
2016-10-01 Tentativa de integração Berlekamp + ChienForney
    mal sucedida
    [RSDecoder.smp_dump.txt]
2016-10-11 Added some comentaries on circuitry
2016-10-13 Added encoder integration
    RS Encoder + Interleaver on its way
2016-10-13 Integração parcial Reed SOlomon Decoder
    Falta a máquina de estados da síndrome funcionar
    [RSDecoder.smp_dump.txt]
2016-10-13 Reed Solomon Integrado
    Faltam buffers da mensagem e flag de erro
    [RSDecoder.smp_dump.txt]
2016-10-13 Interleaver integrated with RS Encoder
    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
2016-10-13 Adding convolutional encoder to Encoder
    Not fully integrated yet.
2016-10-20 Signal Tap + Interleaver Integrated
    [stp1.stp]
2016-11-02 Reed Solomon
    com cálculo de erro e quase pronto para integração no pipeline
    [RSDecoder.smp_dump.txt]
2016-11-03 Reed Solomon Decoder
    Completo, pronto para integração
    [RSDecoder.smp_dump.txt]
2016-11-03 Read me de reed solomon decoder
    Reed Solomon Decoder/Read Me
2016-11-03 Encoder Integration + Decoder start
2016-11-06 UART
    FPGA -> Computer working
    [uart.csv, uart_tap.stp, uart_tb.csv]
2016-11-09 New UART with debounce
    It works for a character RX and TX, need to extend to register fifo
    logic
2016-11-12 Integration RSEncoder-RSDecoder
    UART missing
    [BerleMas.vhd, BerlekampController.vhd, Berlekamp_Massey.vhd, Chien.vhd, ChienController.vhd, ChienForney.vhd, ChienSearchLocation.vhd, ChienSearchValue.vhd]
2016-11-12 Refactored Project and Added Circuits/Simulations
    Maybe some linking problems with RSEncoder
    [AmpOpDif2.sch, DRILEGEND.CFG, comparator.ms14, receiver-licy.ms14, receiver-licy2.ms14, receiver-licy3.ms14, receiver_lify.brd, receiver_lify.sch]
2016-11-14 Reed Solomon
    Faltam explicação teórica de berlekamp, imagens e fórmulas
2016-11-15 Added circuit report
    still needs lot of work
    [receiver-licy3.ms14]
2016-11-16 Teoria de Reed Solomon
    Quase completa, faltam imagens, diagramas, algumas fórmulas. Possível
    melhorar a explicação para Berlekamp.
2016-11-17 Report Updates
    new assets, new graphs lib, etc
    [comparator_amp.sch, mosfet_cutoff.sch, mosfet_example.sch, mosfet_saturation.sch, transimpedance_amp.sch, transimpedance_amp_simple.sch]
2016-11-17 Reorganização relatório
    otmização da organização de alguns tópicos
2016-11-18 Finalização da metodologia de hardware
2016-11-24 TX and RX working on the FPGA
    Connecting cable between exposed pins! Yey
2016-11-27 Correções de meto e intro
    Adequação a mudança de escopo do projeto
2016-11-27 Resources and text that needs revision
    Convolutional, Interleaver, Manchester Decoder, UART and Viterbi
2016-11-30 Modificações no arquivo de configurações
2016-11-30 Referencias do RS
    por favor revisar e verificar se funciona antes de gerar
2016-12-13 Cyclone 5 Implementation
    integrations on the way
    [all.stp, c5_pin_model_dump.txt]
2017-01-09 Revisão Bibliográfica quase terminada
    Preciso que alguém verifique como ficaram os nossos acronyms
2017-01-10 intro e conclusão incompletas
    falta o fugging problema de engenharia
2017-01-11 Testes +/-, tabela comparativa para revisao bibliografica e ajustes gerais
    PDF mais atual adicionado ao git
